slimmpylk/Skoll_Ultra/sportwatch_revA.kicad_pcb

## KiCad design sportwatch_revA.kicad_pcb (2026-10-22)

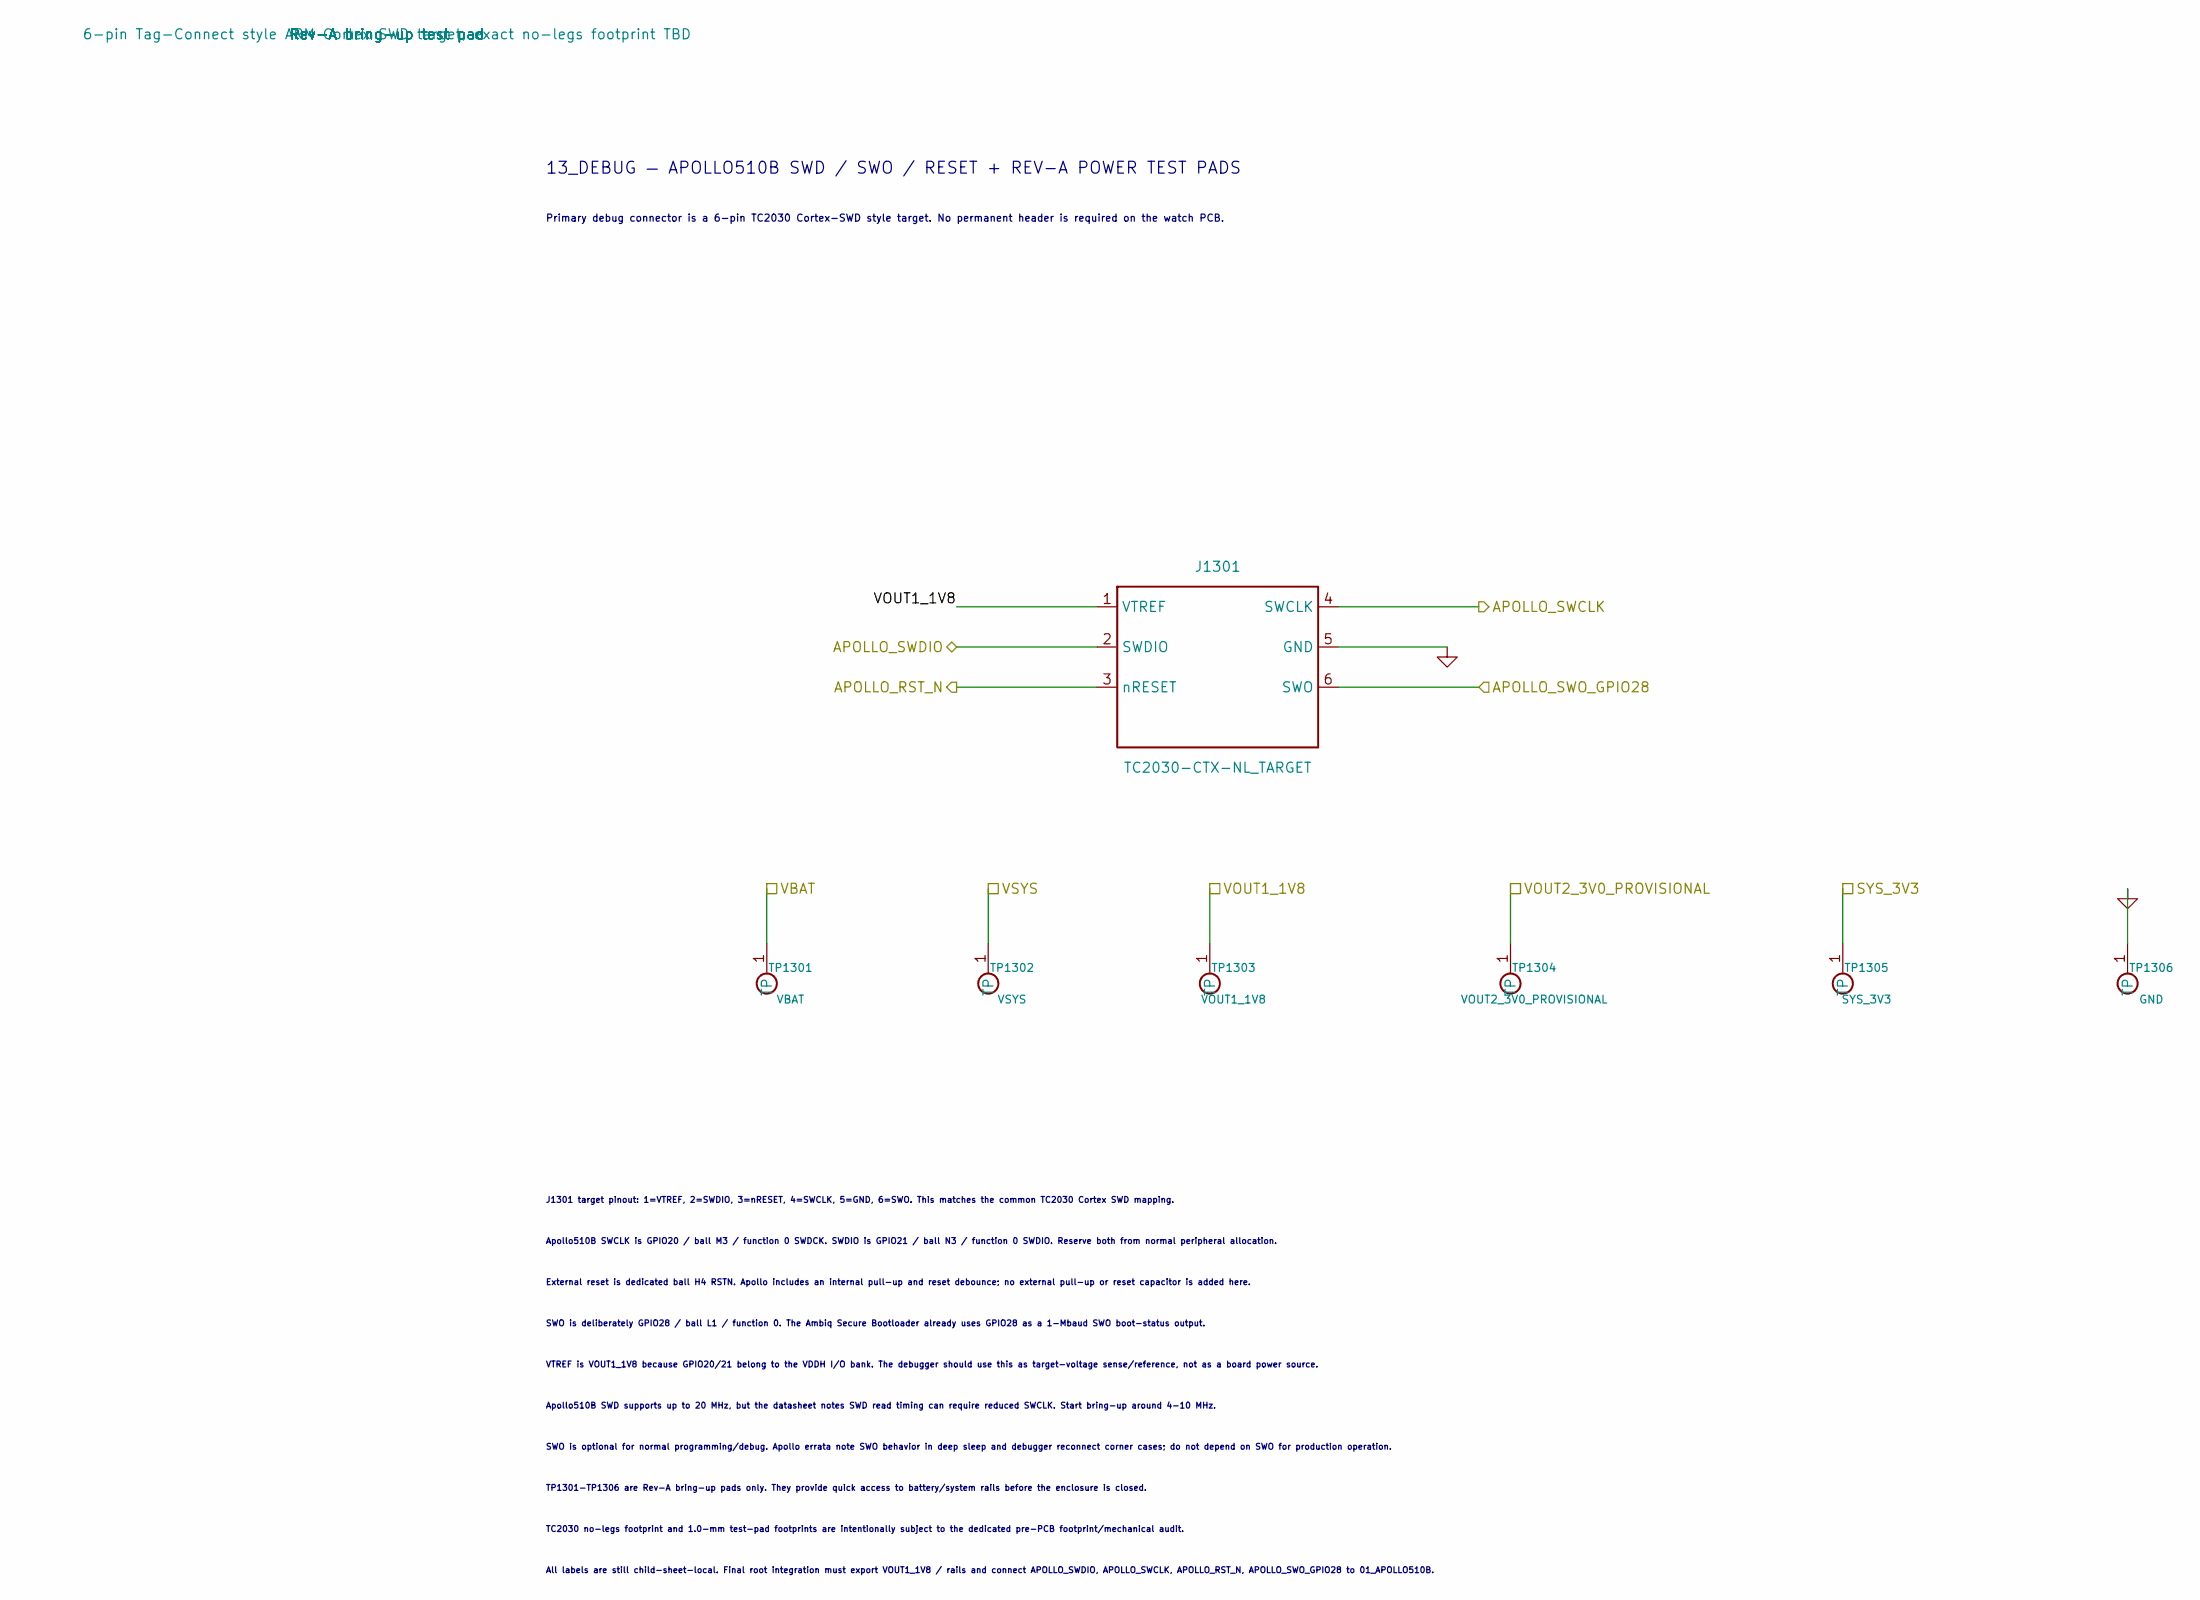
[picture p2: schematic 13_DEBUG.kicad_sch, Rev-A — Apollo510B Debug / Bring-up]

Parts:
J1301: TC2030-CTX-NL_TARGET; Tag-Connect_TC2030-IDC-NL_2x03_P1.27mm_Vertical
TP1301: VBAT; TestPoint_Pad_D1.0mm
TP1302: VSYS; TestPoint_Pad_D1.0mm
TP1303: VOUT1_1V8; TestPoint_Pad_D1.0mm
TP1304: VOUT2_3V0_PROVISIONAL; TestPoint_Pad_D1.0mm
TP1305: SYS_3V3; TestPoint_Pad_D1.0mm
TP1306: GND; TestPoint_Pad_D1.0mm

Connections:
/APOLLO_RST_N: J1301.3 (nRESET); also elsewhere on the board
/APOLLO_SWCLK: J1301.4 (SWCLK); also elsewhere on the board
/APOLLO_SWDIO: J1301.2 (SWDIO); also elsewhere on the board
/APOLLO_SWO_GPIO28: J1301.6 (SWO); also elsewhere on the board
/SYS_3V3: TP1305.1 (TP_1); also elsewhere on the board
/VOUT2_3V0_PROVISIONAL: TP1304.1 (TP_1); also elsewhere on the board
/VSYS: TP1302.1 (TP_1); also elsewhere on the board
GND: J1301.5 (GND), TP1306.1 (TP_1); also elsewhere on the board
VBAT: TP1301.1 (TP_1); also elsewhere on the board
VOUT1_1V8: J1301.1 (VTREF), TP1303.1 (TP_1); also elsewhere on the board

Notes on the sheet:
J1301 target pinout: 1=VTREF, 2=SWDIO, 3=nRESET, 4=SWCLK, 5=GND, 6=SWO. This matches the common TC2030 Cortex SWD mapping.
13_DEBUG — APOLLO510B SWD / SWO / RESET + REV-A POWER TEST PADS
SWO is optional for normal programming/debug. Apollo errata note SWO behavior in deep sleep and debugger reconnect corner cases; do not depend on SWO for production operation.
VTREF is VOUT1_1V8 because GPIO20/21 belong to the VDDH I/O bank. The debugger should use this as target-voltage sense/reference, not as a board power source.
All labels are still child-sheet-local. Final root integration must export VOUT1_1V8 / rails and connect APOLLO_SWDIO, APOLLO_SWCLK, APOLLO_RST_N, APOLLO_SWO_GPIO28 to 01_APOLLO510B.
Apollo510B SWCLK is GPIO20 / ball M3 / function 0 SWDCK. SWDIO is GPIO21 / ball N3 / function 0 SWDIO. Reserve both from normal peripheral allocation.
TC2030 no-legs footprint and 1.0-mm test-pad footprints are intentionally subject to the dedicated pre-PCB footprint/mechanical audit.
External reset is dedicated ball H4 RSTN. Apollo includes an internal pull-up and reset debounce; no external pull-up or reset capacitor is added here.
SWO is deliberately GPIO28 / ball L1 / function 0. The Ambiq Secure Bootloader already uses GPIO28 as a 1-Mbaud SWO boot-status output.
Apollo510B SWD supports up to 20 MHz, but the datasheet notes SWD read timing can require reduced SWCLK. Start bring-up around 4-10 MHz.
Primary debug connector is a 6-pin TC2030 Cortex-SWD style target. No permanent header is required on the watch PCB.
TP1301-TP1306 are Rev-A bring-up pads only. They provide quick access to battery/system rails before the enclosure is closed.

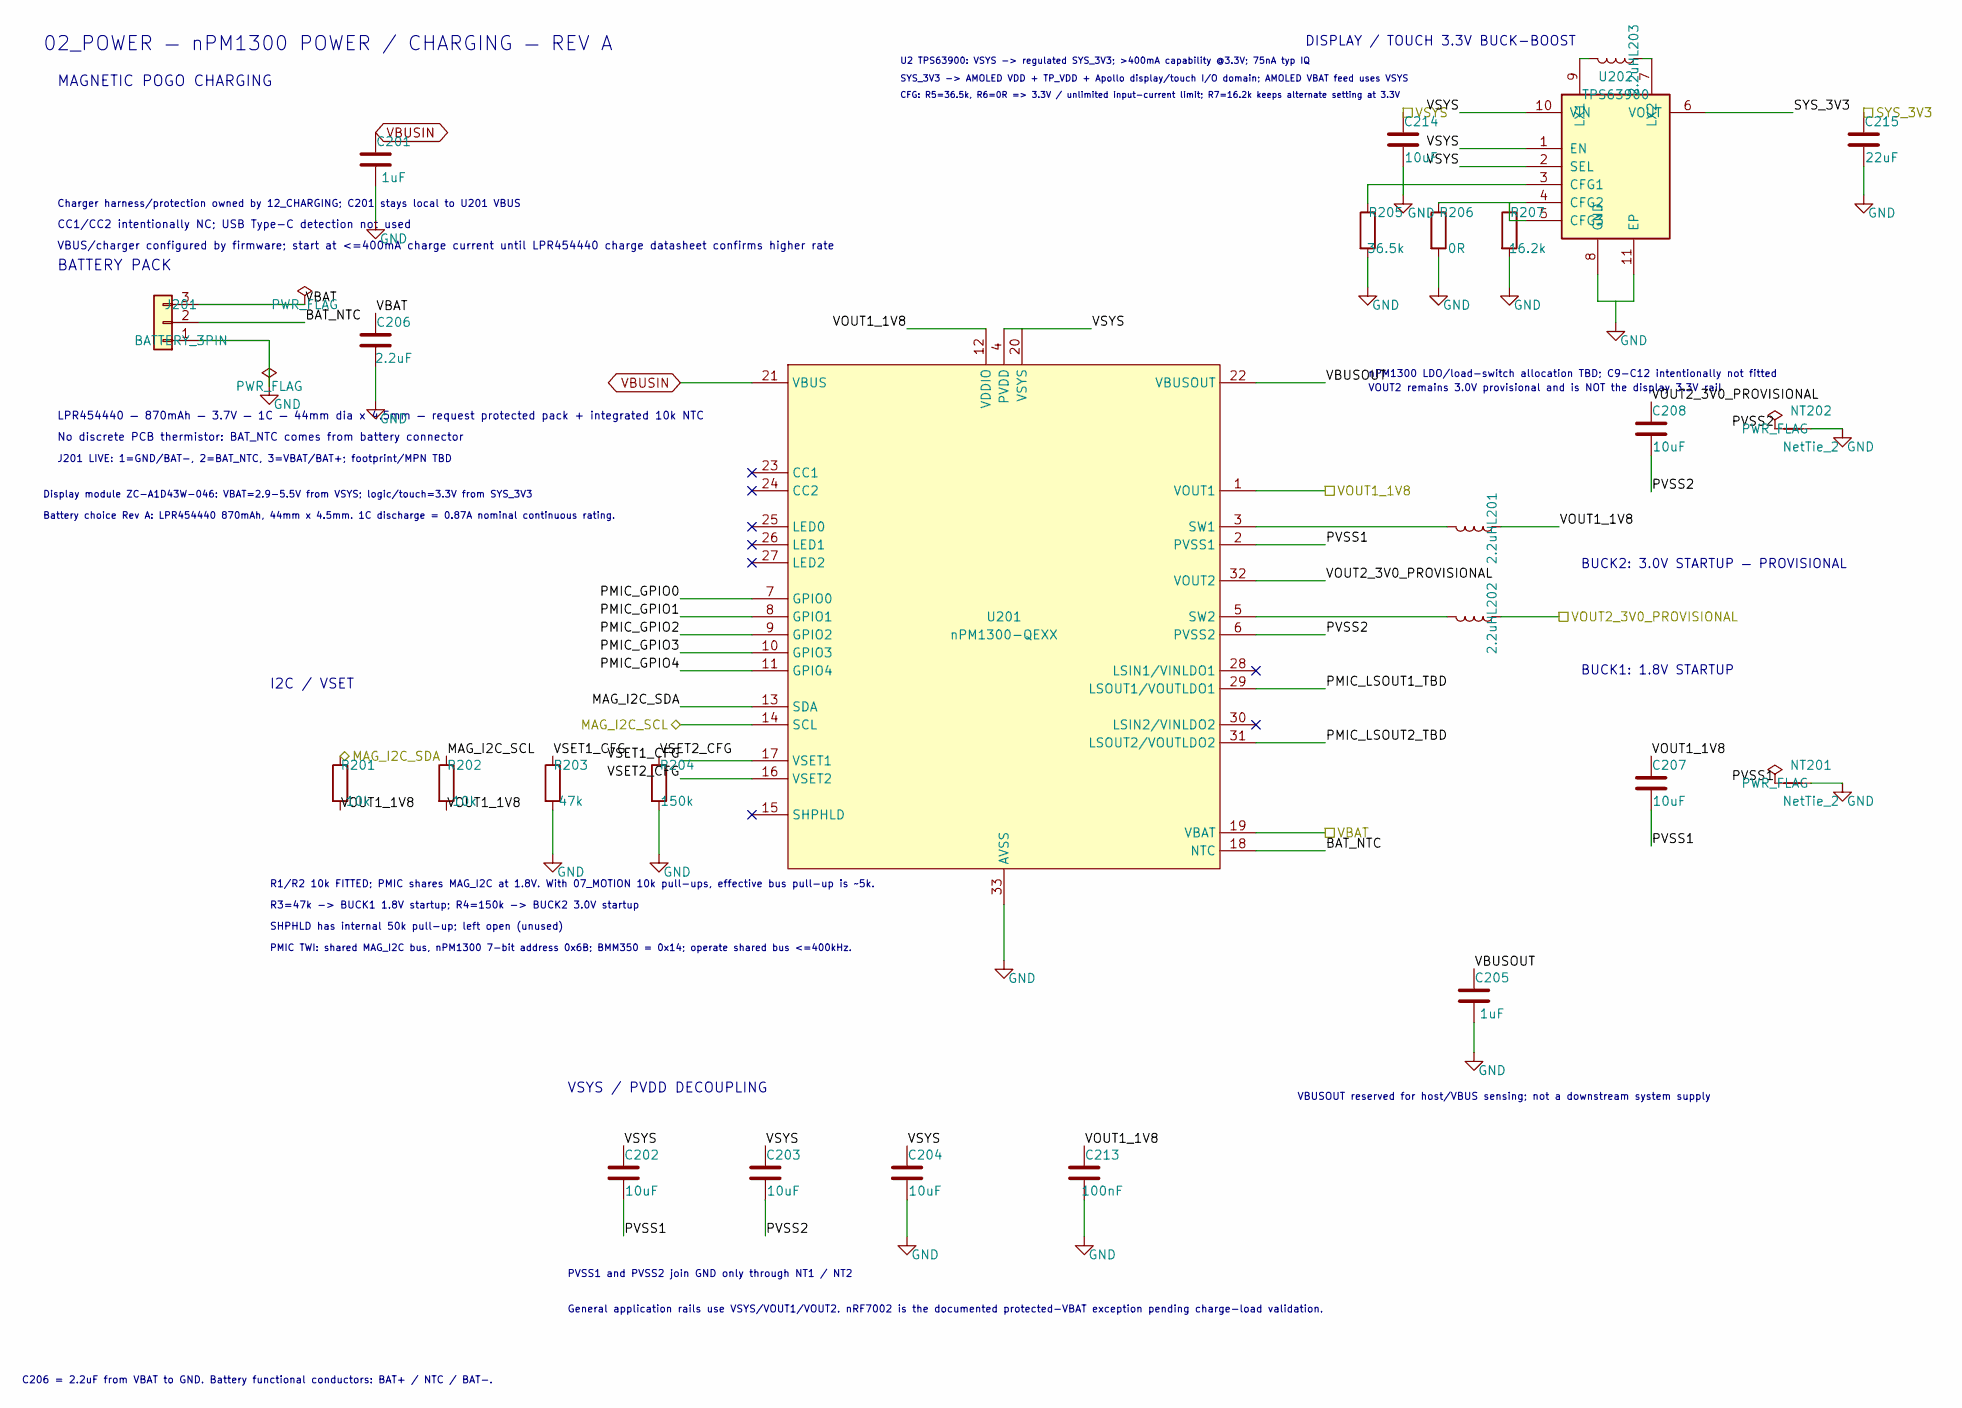
[picture p3: schematic 02_POWER.kicad_sch]

Parts:
C201, C205: 1uF; C_0402_1005Metric
C202, C203, C204, C207, C208, C214: 10uF; C_0603_1608Metric
C206: 2.2uF; C_0402_1005Metric
C213: 100nF; C_0402_1005Metric
C215: 22uF; C_0603_1608Metric
J201: BATTERY_3PIN
L201, L202: 2.2uH; L_0603_1608Metric
L203: 2.2uH; L_2016_2016Metric
NT201, NT202: NetTie_2; NetTie-2_SMD_Pad0.5mm
R201, R202: 10k; R_0402_1005Metric
R203: 47k; R_0402_1005Metric; Tolerance 1%
R204: 150k; R_0402_1005Metric; Tolerance 1%
R205: 36.5k; R_0402_1005Metric; Tolerance 1%
R206: 0R; R_0402_1005Metric; Tolerance 1%
R207: 16.2k; R_0402_1005Metric; Tolerance 1%
U201: nPM1300-QEXX; QFN-32-1EP_5x5mm_P0.5mm_EP3.6x3.6mm_ThermalVias
U202: TPS63900; WSON-10-1EP_2.5x2.5mm_P0.5mm_EP1.2x2mm_ThermalVias; MPN TPS63900DSK

Connections:
/02_POWER/BAT_NTC: J201.2, U201.18 (NTC)
/02_POWER/PMIC_GPIO0: U201.7 (GPIO0)
/02_POWER/PMIC_GPIO1: U201.8 (GPIO1)
/02_POWER/PMIC_GPIO2: U201.9 (GPIO2)
/02_POWER/PMIC_GPIO3: U201.10 (GPIO3)
/02_POWER/PMIC_GPIO4: U201.11 (GPIO4)
/02_POWER/PMIC_LSOUT1_TBD: U201.29 (LSOUT1/VOUTLDO1)
/02_POWER/PMIC_LSOUT2_TBD: U201.31 (LSOUT2/VOUTLDO2)
/02_POWER/PVSS1: C202.2, C207.2, NT201.1, U201.2 (PVSS1)
/02_POWER/PVSS2: C203.2, C208.2, NT202.1, U201.6 (PVSS2)
/02_POWER/VBUSOUT: C205.1, U201.22 (VBUSOUT)
/02_POWER/VSET1_CFG: R203.1, U201.17 (VSET1)
/02_POWER/VSET2_CFG: R204.1, U201.16 (VSET2)
/MAG_I2C_SCL: R202.1, U201.14 (SCL); also elsewhere on the board
/MAG_I2C_SDA: R201.1, U201.13 (SDA); also elsewhere on the board
/SYS_3V3: C215.1, U202.6 (VOUT); also elsewhere on the board
/VOUT2_3V0_PROVISIONAL: C208.1, L202.1, U201.32 (VOUT2); also elsewhere on the board
/VSYS: C202.1, C203.1, C204.1, C214.1, U201.4 (PVDD), U201.20 (VSYS), U202.1 (EN), U202.2 (SEL), U202.10 (VIN); also elsewhere on the board
GND: C201.2, C204.2, C205.2, C206.2, C213.2, C214.2, C215.2, J201.1, NT201.2, NT202.2, R203.2, R204.2, R205.2, R206.2, R207.2, U201.33 (AVSS), U202.8 (GND), U202.11 (EP); also elsewhere on the board
unnamed: L201.2, U201.3 (SW1)
unnamed: L202.2, U201.5 (SW2)
unnamed: R205.1, U202.3 (CFG1)
unnamed: R206.1, U202.4 (CFG2)
unnamed: R207.1, U202.5 (CFG3)
unnamed: L203.2, U202.9 (LX1)
unnamed: L203.1, U202.7 (LX2)
VBAT: C206.1, J201.3, U201.19 (VBAT); also elsewhere on the board
VBUSIN: C201.1, U201.21 (VBUS)
VOUT1_1V8: C207.1, C213.1, L201.1, R201.2, R202.2, U201.1 (VOUT1), U201.12 (VDDIO); also elsewhere on the board

Notes on the sheet:
VBUSOUT reserved for host/VBUS sensing; not a downstream system supply
U2 TPS63900: VSYS -> regulated SYS_3V3; >400mA capability @3.3V; 75nA typ IQ
Battery choice Rev A: LPR454440 870mAh, 44mm x 4.5mm. 1C discharge = 0.87A nominal continuous rating.
BATTERY PACK
DISPLAY / TOUCH 3.3V BUCK-BOOST
SYS_3V3 -> AMOLED VDD + TP_VDD + Apollo display/touch I/O domain; AMOLED VBAT feed uses VSYS
Charger harness/protection owned by 12_CHARGING; C201 stays local to U201 VBUS
VSYS / PVDD DECOUPLING
BUCK1: 1.8V STARTUP
CFG: R5=36.5k, R6=0R => 3.3V / unlimited input-current limit; R7=16.2k keeps alternate setting at 3.3V
No discrete PCB thermistor: BAT_NTC comes from battery connector
CC1/CC2 intentionally NC; USB Type-C detection not used
R3=47k -> BUCK1 1.8V startup; R4=150k -> BUCK2 3.0V startup
I2C / VSET
nPM1300 LDO/load-switch allocation TBD; C9-C12 intentionally not fitted
02_POWER — nPM1300 POWER / CHARGING — REV A
LPR454440 — 870mAh — 3.7V — 1C — 44mm dia x 4.5mm — request protected pack + integrated 10k NTC
R1/R2 10k FITTED; PMIC shares MAG_I2C at 1.8V. With 07_MOTION 10k pull-ups, effective bus pull-up is ~5k.
MAGNETIC POGO CHARGING
J201 LIVE: 1=GND/BAT-, 2=BAT_NTC, 3=VBAT/BAT+; footprint/MPN TBD
Display module ZC-A1D43W-046: VBAT=2.9-5.5V from VSYS; logic/touch=3.3V from SYS_3V3
SHPHLD has internal 50k pull-up; left open (unused)
VBUS/charger configured by firmware; start at <=400mA charge current until LPR454440 charge datasheet confirms higher rate
VOUT2 remains 3.0V provisional and is NOT the display 3.3V rail
PVSS1 and PVSS2 join GND only through NT1 / NT2
BUCK2: 3.0V STARTUP — PROVISIONAL
General application rails use VSYS/VOUT1/VOUT2. nRF7002 is the documented protected-VBAT exception pending charge-load validation.
PMIC TWI: shared MAG_I2C bus, nPM1300 7-bit address 0x6B; BMM350 = 0x14; operate shared bus <=400kHz.
C206 = 2.2uF from VBAT to GND. Battery functional conductors: BAT+ / NTC / BAT-.

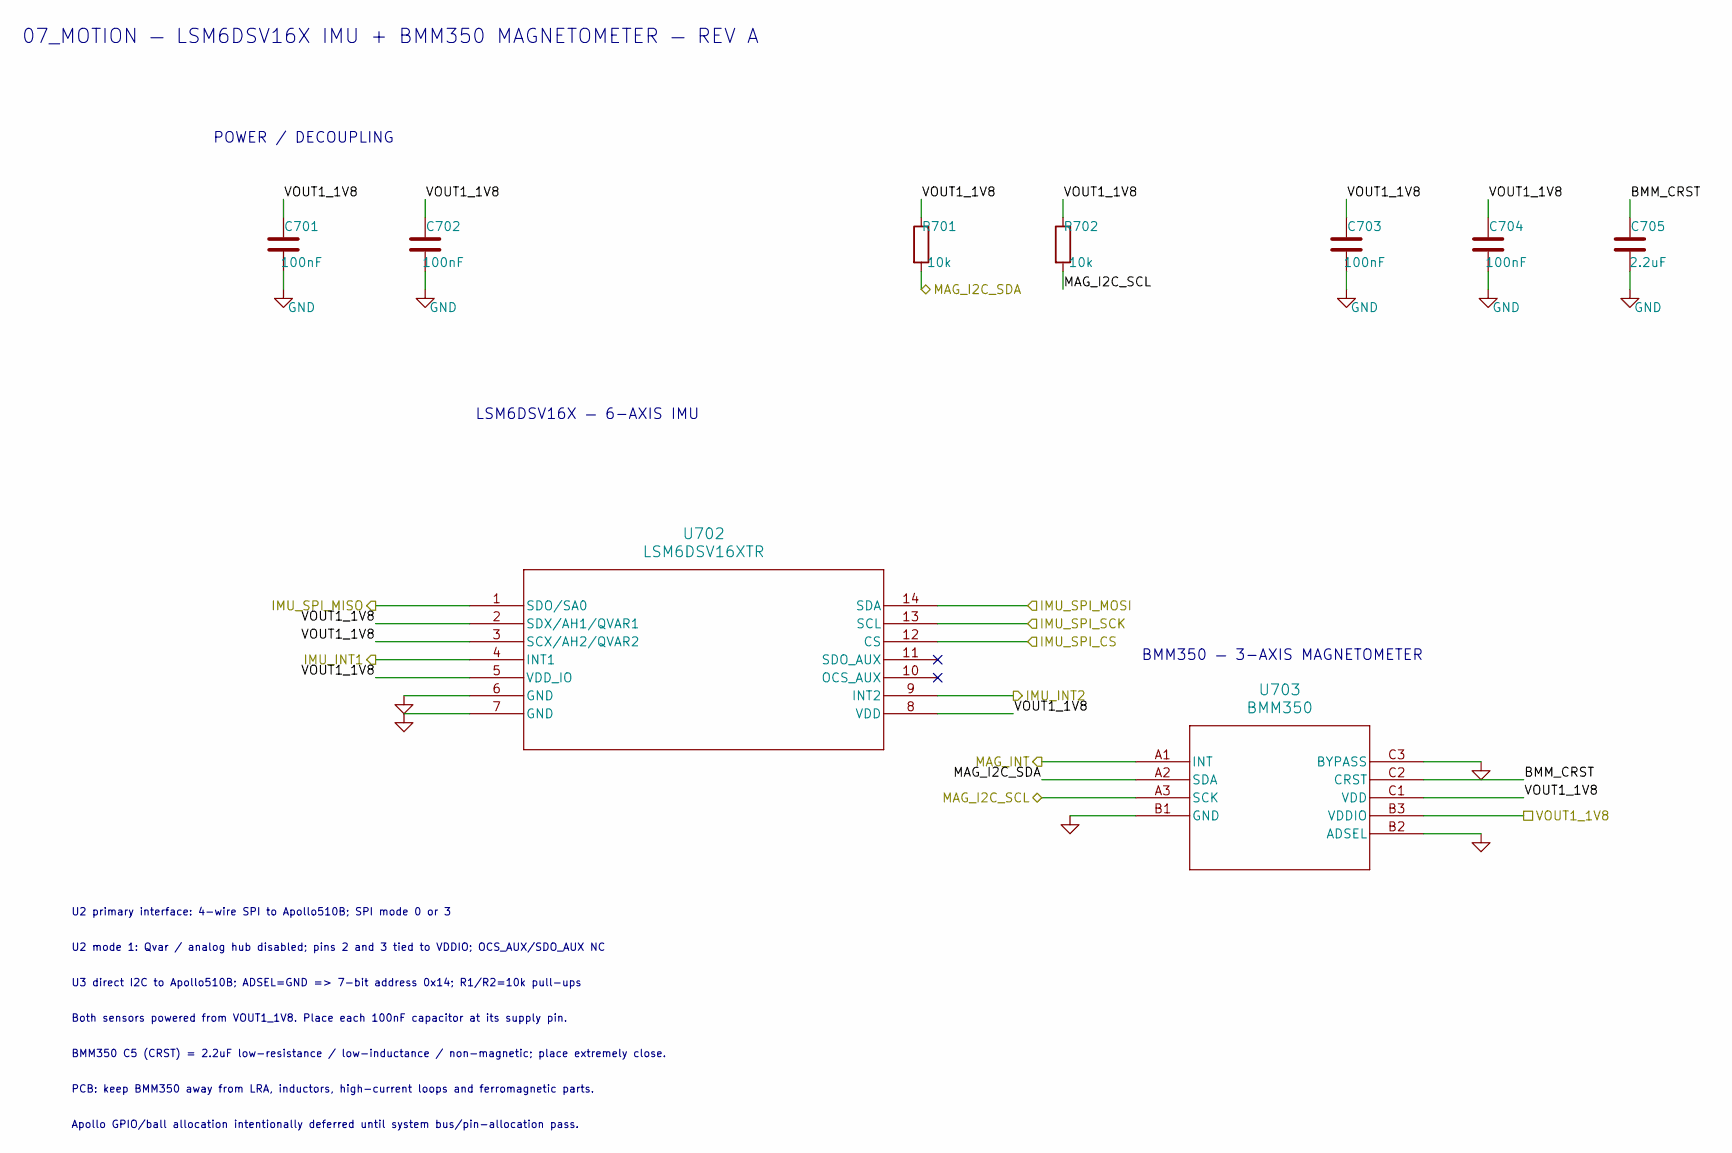
[picture p4: schematic 07_MOTION.kicad_sch]

Parts:
C701, C702, C703, C704: 100nF; C_0402_1005Metric
C705: 2.2uF; C_0805_2012Metric
R701, R702: 10k; R_0402_1005Metric; Tolerance 1%
U702: LSM6DSV16XTR; LGA-14L_STM
U703: BMM350; BGA9_BMM350_BOS

Connections:
/07_MOTION/BMM_CRST: C705.1, U703.C2 (CRST)
/IMU_INT1: U702.4 (INT1); also elsewhere on the board
/IMU_INT2: U702.9 (INT2); also elsewhere on the board
/IMU_SPI_CS: U702.12 (CS); also elsewhere on the board
/IMU_SPI_MISO: U702.1 (SDO/SA0); also elsewhere on the board
/IMU_SPI_MOSI: U702.14 (SDA); also elsewhere on the board
/IMU_SPI_SCK: U702.13 (SCL); also elsewhere on the board
/MAG_I2C_SCL: R702.2, U703.A3 (SCK); also elsewhere on the board
/MAG_I2C_SDA: R701.2, U703.A2 (SDA); also elsewhere on the board
/MAG_INT: U703.A1 (INT); also elsewhere on the board
GND: C701.2, C702.2, C703.2, C704.2, C705.2, U702.6 (GND), U702.7 (GND), U703.B1 (GND), U703.B2 (ADSEL), U703.C3 (BYPASS); also elsewhere on the board
VOUT1_1V8: C701.1, C702.1, C703.1, C704.1, R701.1, R702.1, U702.2 (SDX/AH1/QVAR1), U702.3 (SCX/AH2/QVAR2), U702.5 (VDD_IO), U702.8 (VDD), U703.B3 (VDDIO), U703.C1 (VDD); also elsewhere on the board

Notes on the sheet:
LSM6DSV16X — 6-AXIS IMU
BMM350 C5 (CRST) = 2.2uF low-resistance / low-inductance / non-magnetic; place extremely close.
BMM350 — 3-AXIS MAGNETOMETER
U2 primary interface: 4-wire SPI to Apollo510B; SPI mode 0 or 3
U2 mode 1: Qvar / analog hub disabled; pins 2 and 3 tied to VDDIO; OCS_AUX/SDO_AUX NC
07_MOTION — LSM6DSV16X IMU + BMM350 MAGNETOMETER — REV A
U3 direct I2C to Apollo510B; ADSEL=GND => 7-bit address 0x14; R1/R2=10k pull-ups
POWER / DECOUPLING
PCB: keep BMM350 away from LRA, inductors, high-current loops and ferromagnetic parts.
Apollo GPIO/ball allocation intentionally deferred until system bus/pin-allocation pass.
Both sensors powered from VOUT1_1V8. Place each 100nF capacitor at its supply pin.

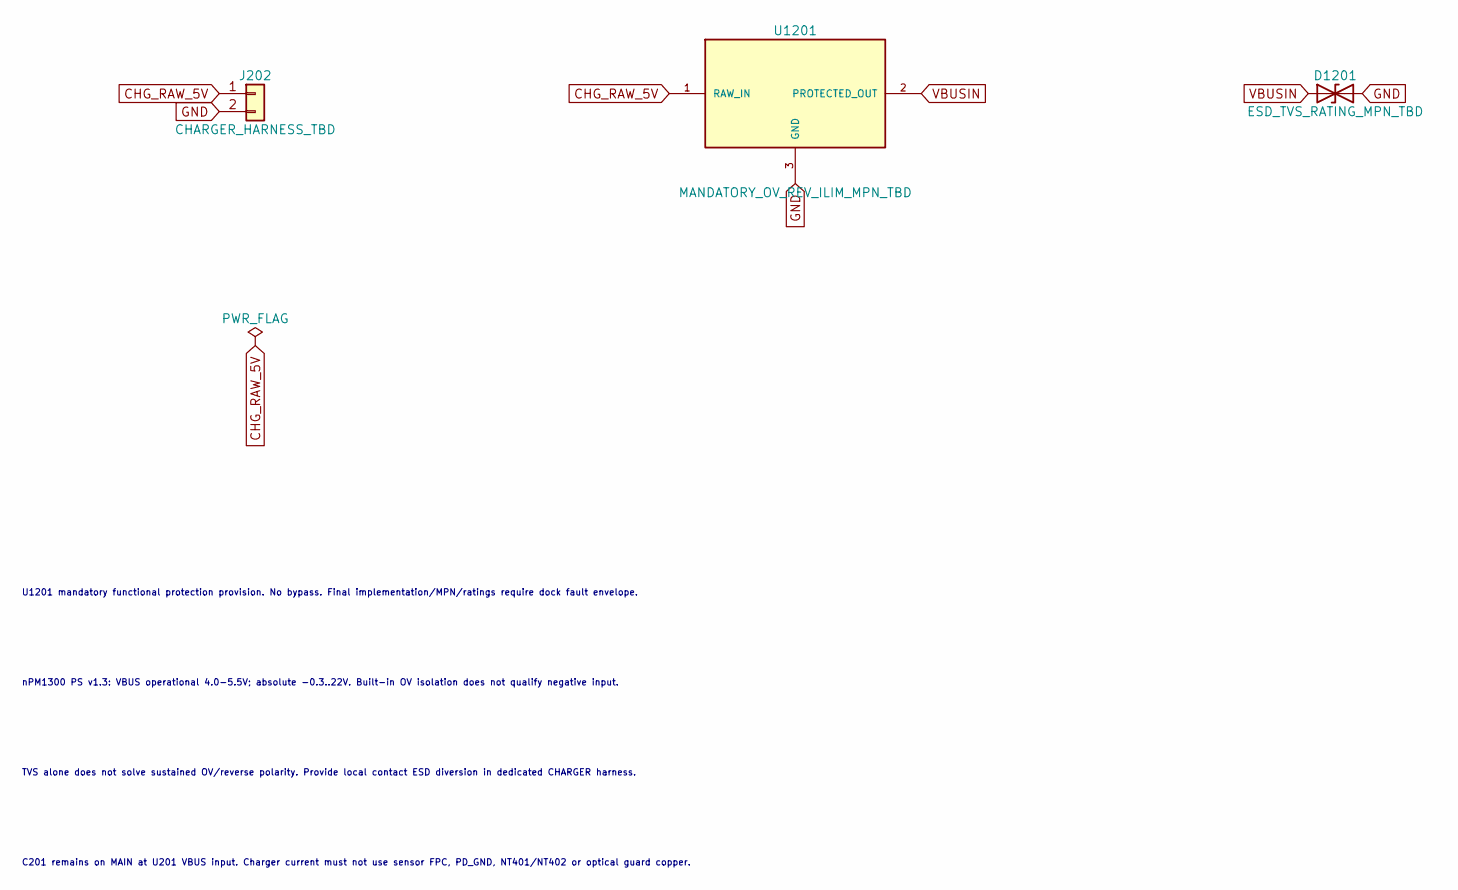
[picture p5: schematic 12_CHARGING.kicad_sch]

Parts:
D1201: ESD_TVS_RATING_MPN_TBD
J202: CHARGER_HARNESS_TBD
U1201: MANDATORY_OV_REV_ILIM_MPN_TBD

Connections:
unnamed: D1201.1 (A1), U1201.2 (PROTECTED_OUT)
unnamed: D1201.2 (A2), J202.2, U1201.3 (GND)
unnamed: J202.1, U1201.1 (RAW_IN)

Notes on the sheet:
U1201 mandatory functional protection provision. No bypass. Final implementation/MPN/ratings require dock fault envelope.
nPM1300 PS v1.3: VBUS operational 4.0-5.5V; absolute -0.3..22V. Built-in OV isolation does not qualify negative input.
TVS alone does not solve sustained OV/reverse polarity. Provide local contact ESD diversion in dedicated CHARGER harness.
C201 remains on MAIN at U201 VBUS input. Charger current must not use sensor FPC, PD_GND, NT401/NT402 or optical guard copper.

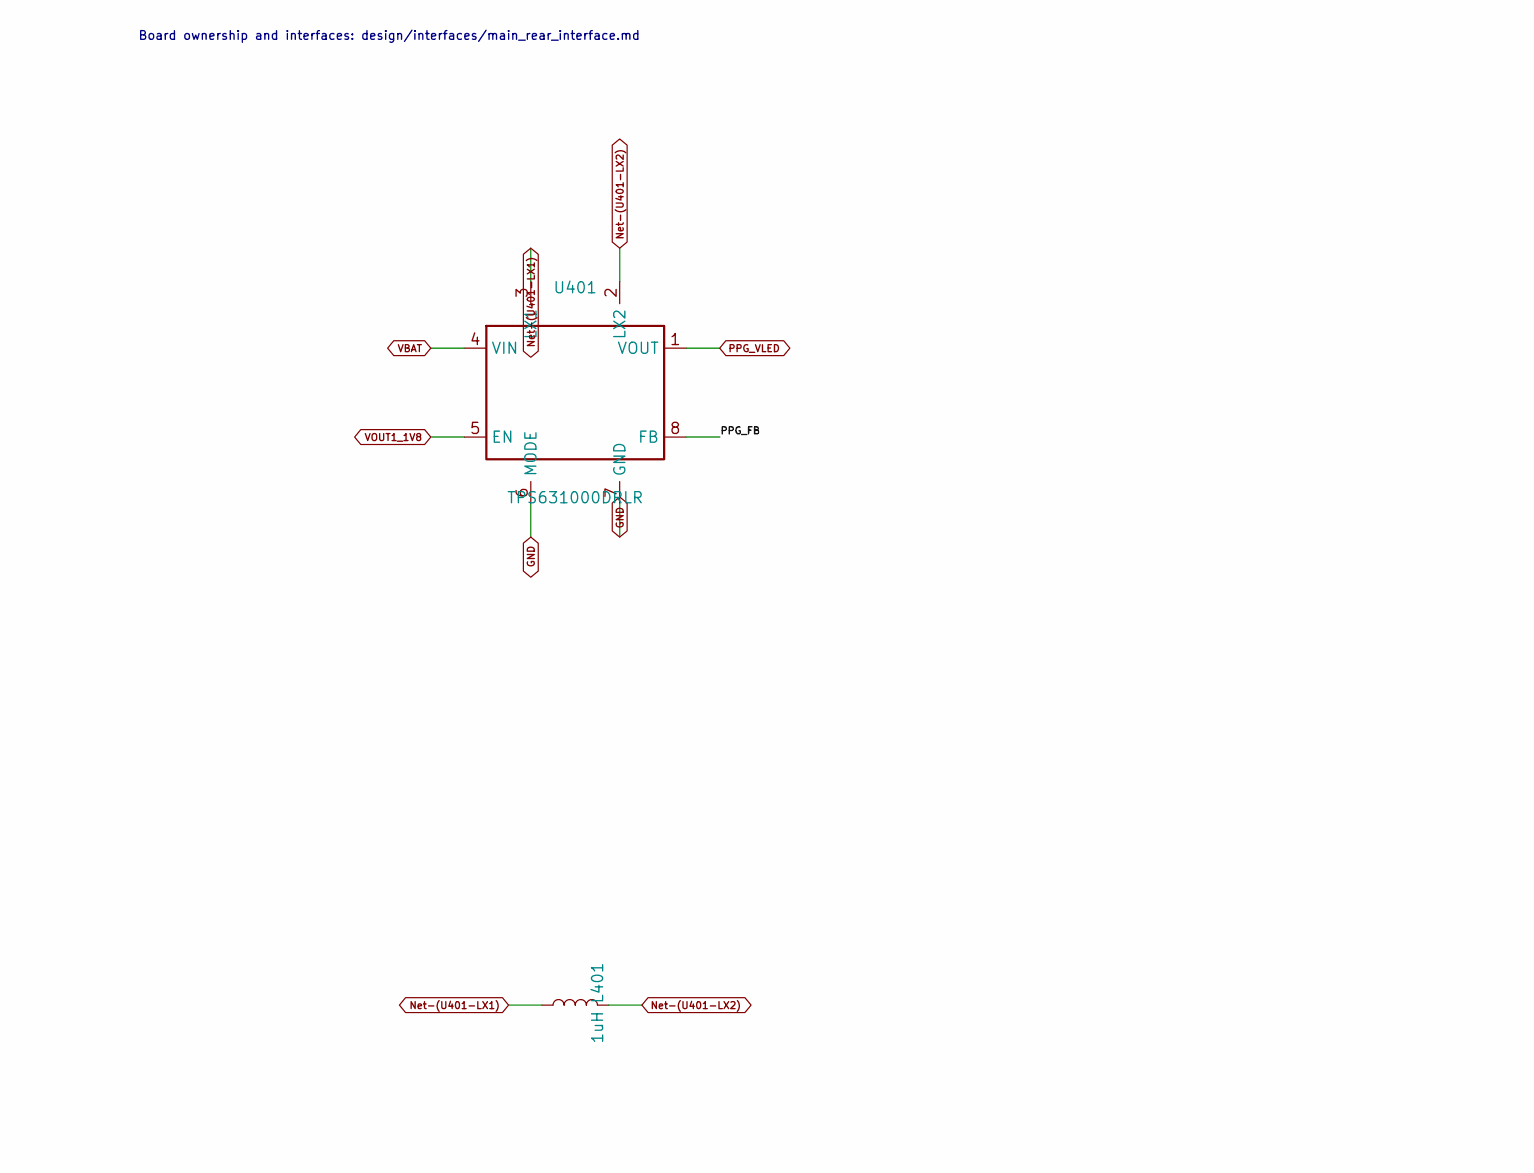
[picture p6: schematic 04_PPG.kicad_sch, MAIN - TPS631000 VLED source and rear interface, part in row 1, column 1]

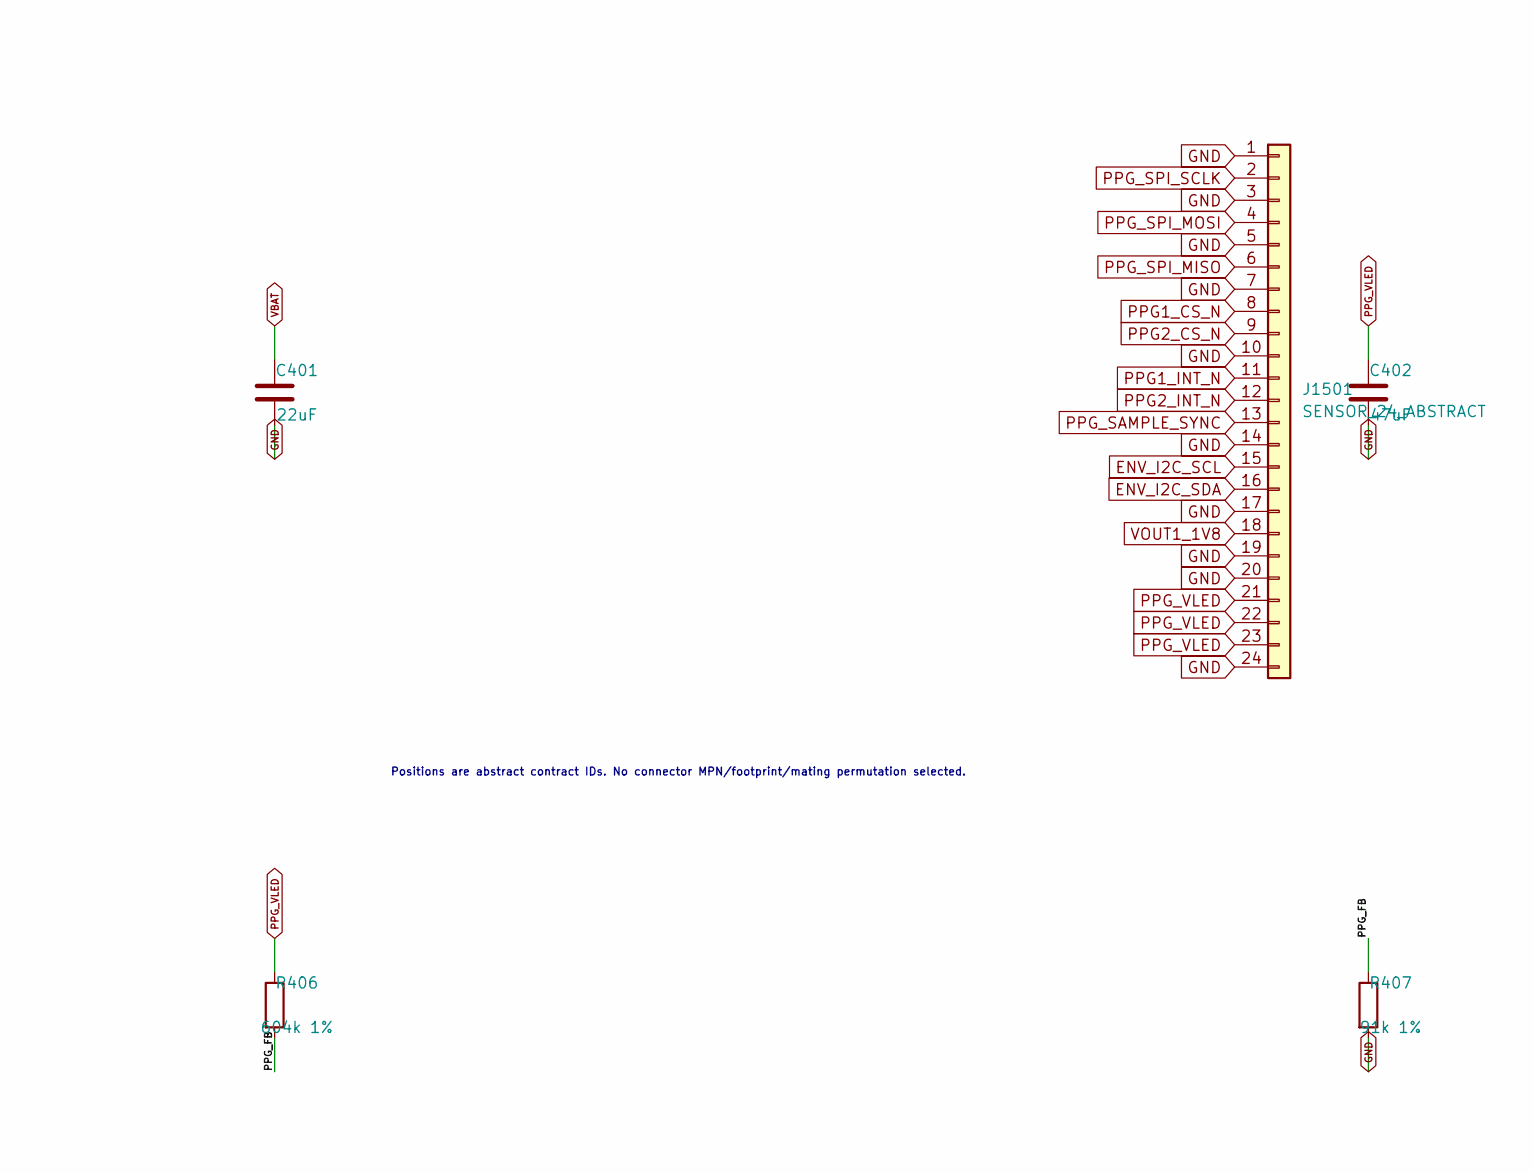
[picture p7: schematic 04_PPG.kicad_sch, MAIN - TPS631000 VLED source and rear interface, part in row 1, column 2]

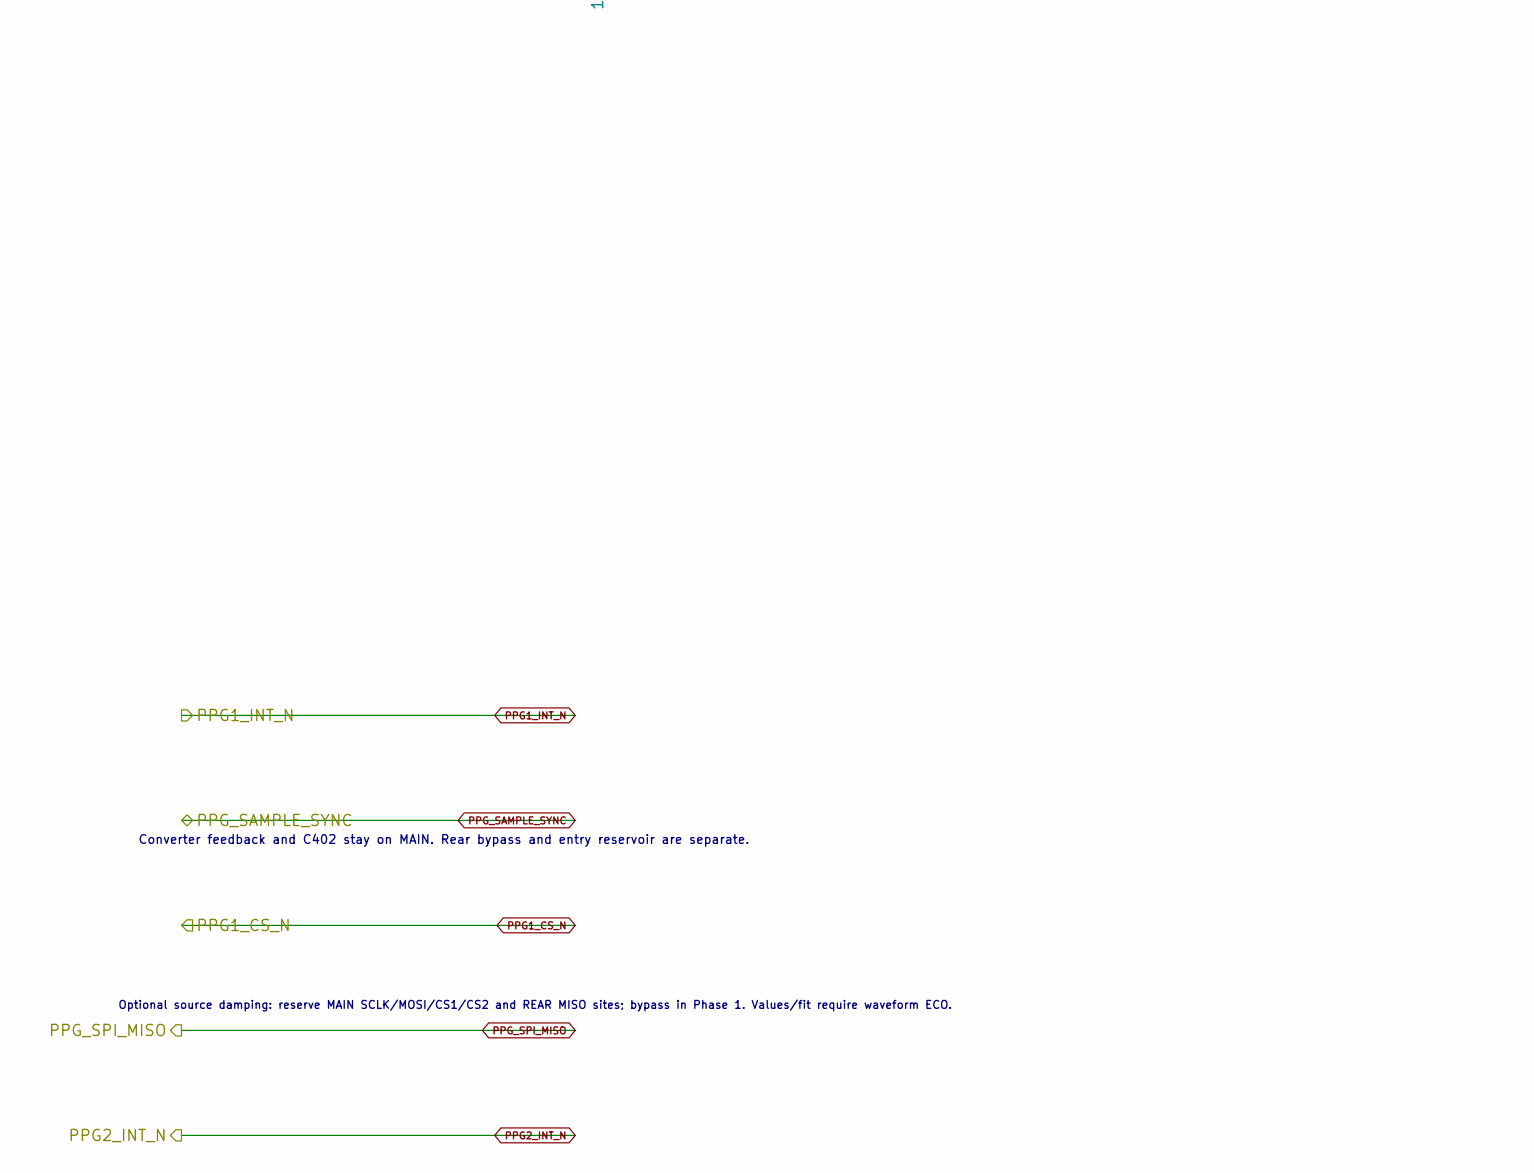
[picture p8: schematic 04_PPG.kicad_sch, MAIN - TPS631000 VLED source and rear interface, part in row 2, column 1]

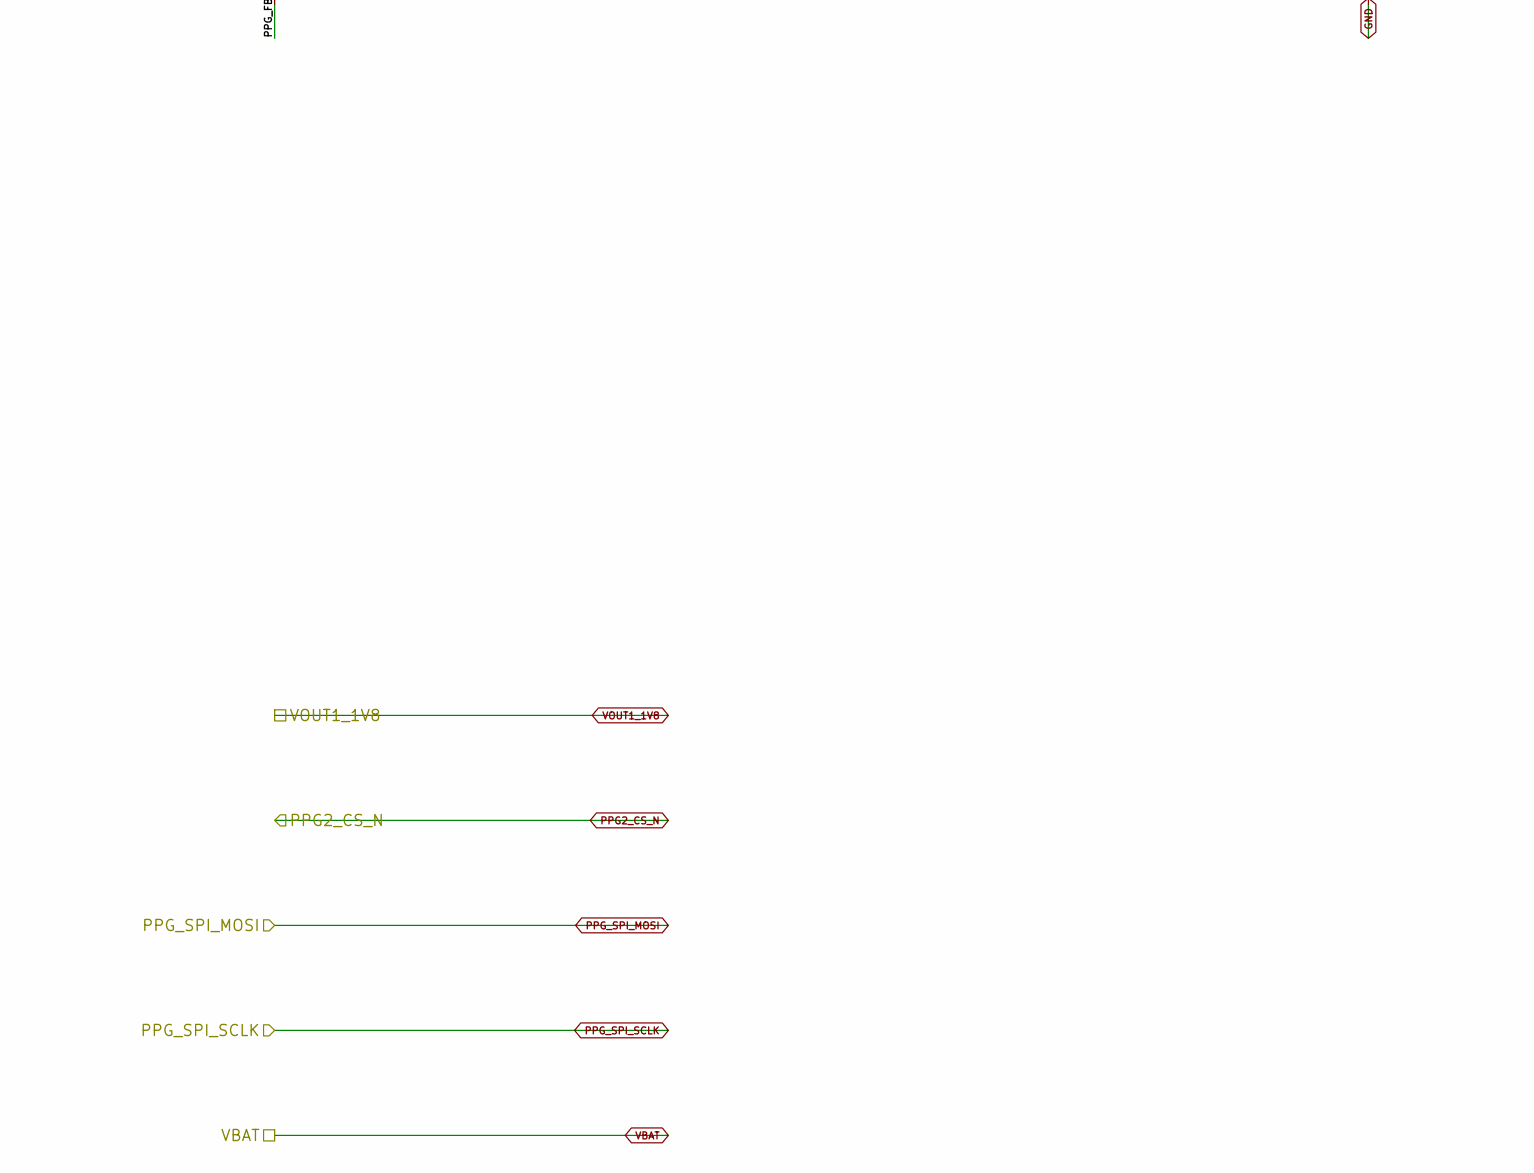
[picture p9: schematic 04_PPG.kicad_sch, MAIN - TPS631000 VLED source and rear interface, part in row 2, column 2]

Parts:
C401: 22uF; C_0603_1608Metric
C402: 47uF; C_0805_2012Metric
J1501: SENSOR_24_ABSTRACT
L401: 1uH; L_2016_2016Metric
R406: 604k 1%; R_0402_1005Metric
R407: 91k 1%; R_0402_1005Metric
U401: TPS631000DRLR; SOT-583-8

Connections:
/04_PPG/PPG_FB: R406.2, R407.1, U401.8 (FB)
GND: C401.2, C402.2, J1501.1, J1501.3, J1501.5, J1501.7, J1501.10, J1501.14, J1501.17, J1501.19, J1501.20, J1501.24, R407.2, U401.6 (MODE), U401.7 (GND); also elsewhere on the board
unnamed: L401.1, U401.3 (LX1)
unnamed: L401.2, U401.2 (LX2)
PPG_VLED: C402.1, J1501.21, J1501.22, J1501.23, R406.1, U401.1 (VOUT)
VBAT: C401.1, U401.4 (VIN); also elsewhere on the board
VOUT1_1V8: J1501.18, U401.5 (EN); also elsewhere on the board

Notes on the sheet:
Board ownership and interfaces: design/interfaces/main_rear_interface.md
Converter feedback and C402 stay on MAIN. Rear bypass and entry reservoir are separate.
Positions are abstract contract IDs. No connector MPN/footprint/mating permutation selected.
Optional source damping: reserve MAIN SCLK/MOSI/CS1/CS2 and REAR MISO sites; bypass in Phase 1. Values/fit require waveform ECO.
