slimmpylk/Skoll_Ultra/sportwatch_revA.kicad_pcb

## KiCad design sportwatch_revA.kicad_pcb (continued)

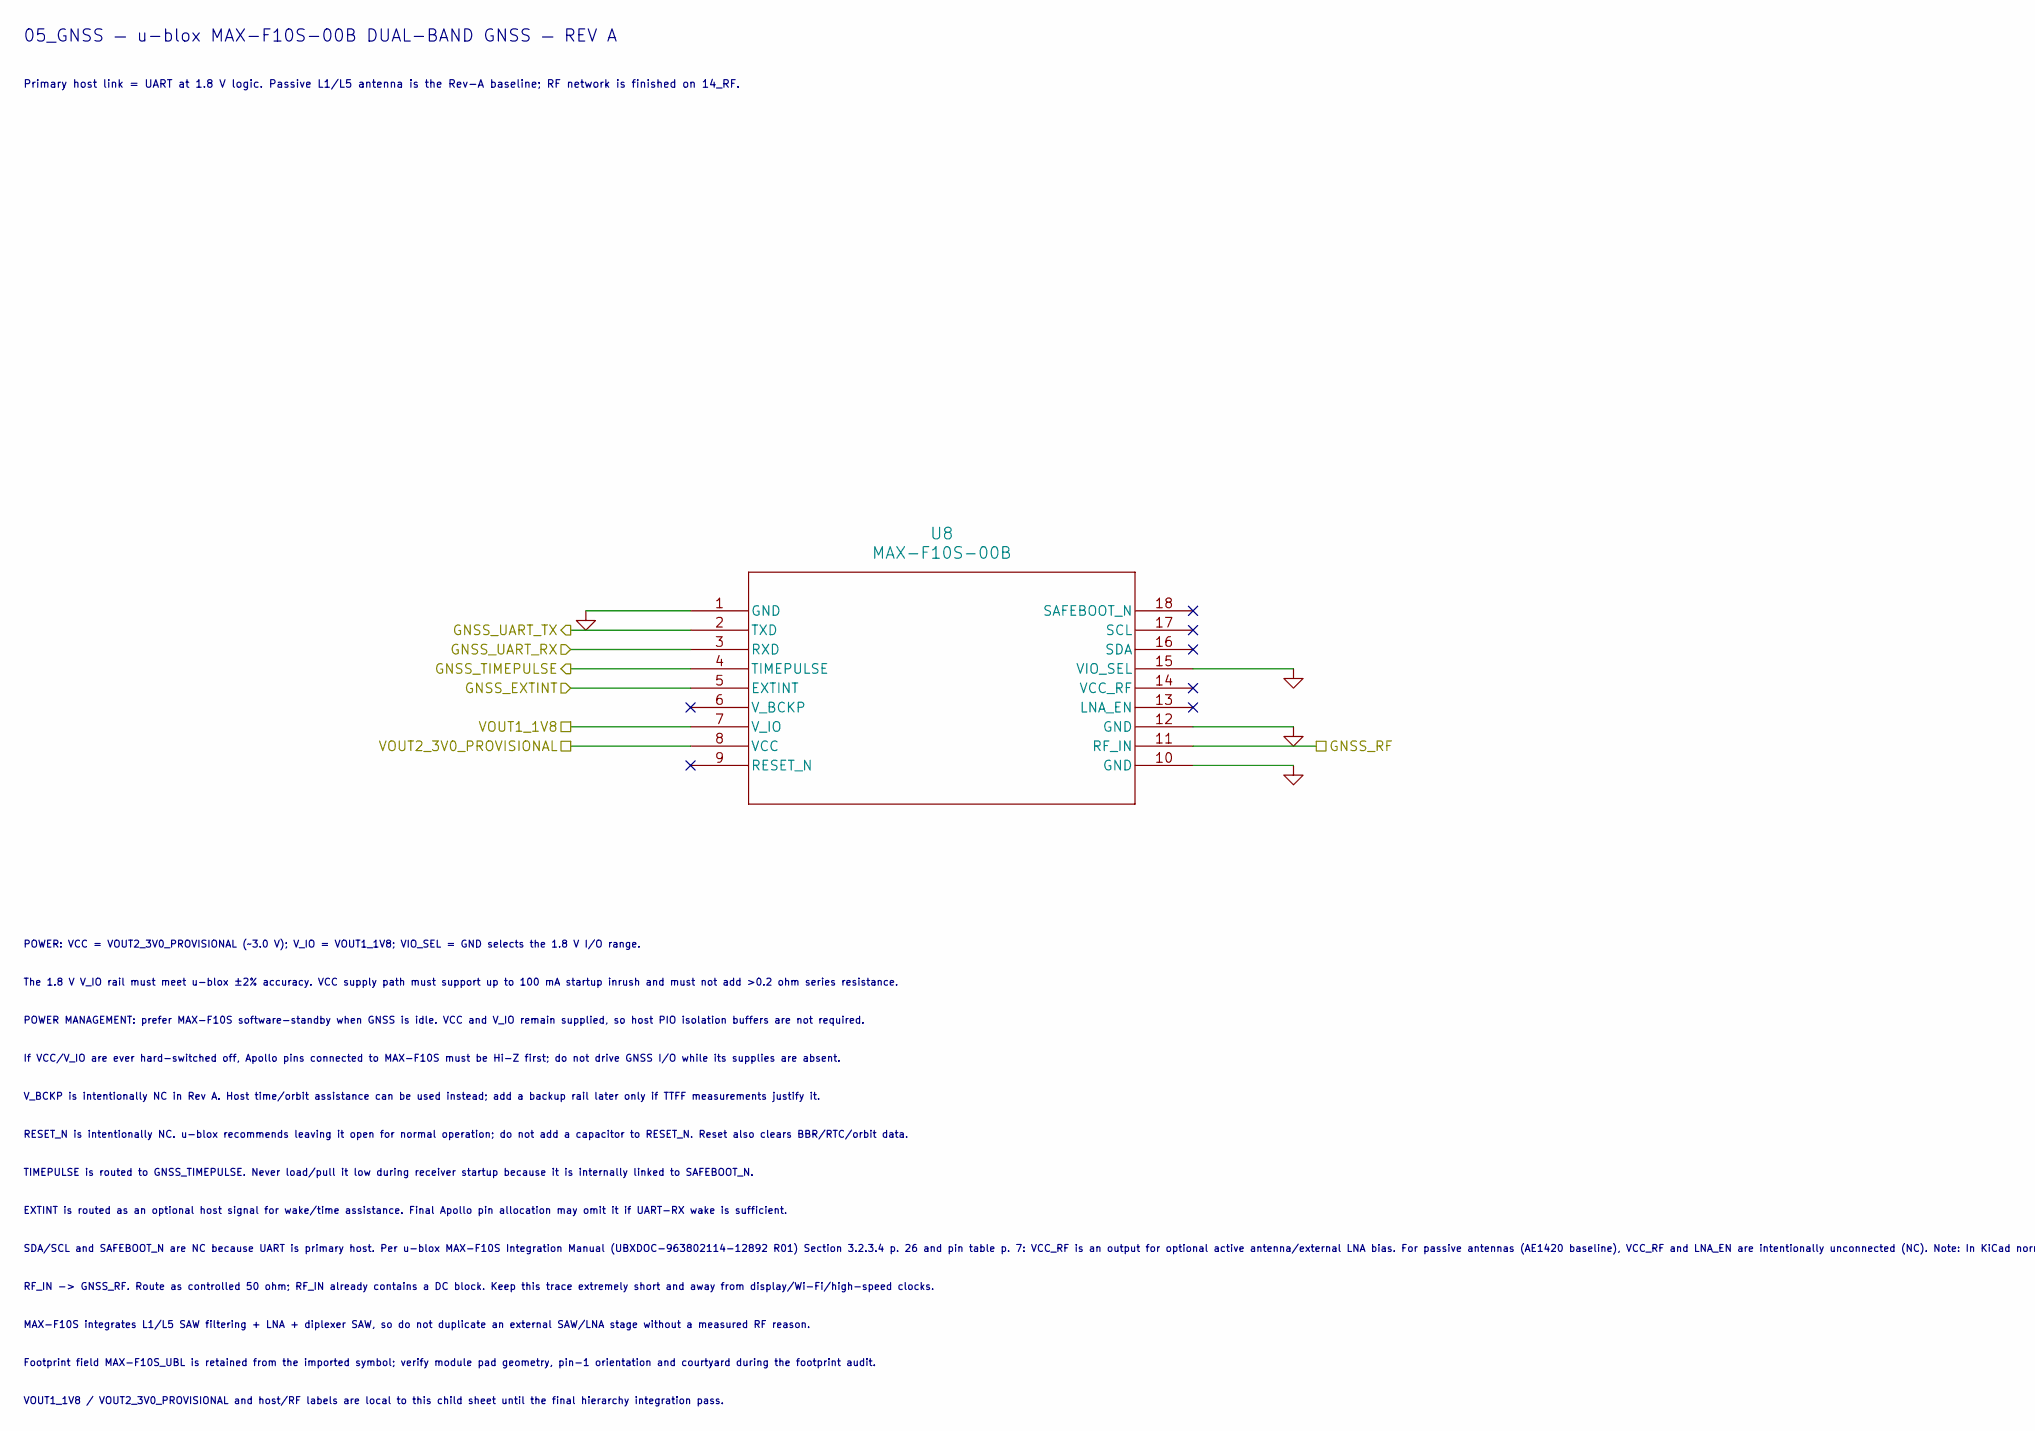
[picture p10: schematic 05_GNSS.kicad_sch, Rev-A — GNSS, part in row 1, column 1]

Parts:
U8: MAX-F10S-00B; MAX-F10S_UBL

Connections:
/GNSS_EXTINT: U8.5 (EXTINT); also elsewhere on the board
/GNSS_RF: U8.11 (RF_IN); also elsewhere on the board
/GNSS_TIMEPULSE: U8.4 (TIMEPULSE); also elsewhere on the board
/GNSS_UART_RX: U8.3 (RXD); also elsewhere on the board
/GNSS_UART_TX: U8.2 (TXD); also elsewhere on the board
/VOUT2_3V0_PROVISIONAL: U8.8 (VCC); also elsewhere on the board
GND: U8.1 (GND), U8.10 (GND), U8.12 (GND), U8.15 (VIO_SEL); also elsewhere on the board
VOUT1_1V8: U8.7 (V_IO); also elsewhere on the board

Notes on the sheet:
EXTINT is routed as an optional host signal for wake/time assistance. Final Apollo pin allocation may omit it if UART-RX wake is sufficient.
VOUT1_1V8 / VOUT2_3V0_PROVISIONAL and host/RF labels are local to this child sheet until the final hierarchy integration pass.
SDA/SCL and SAFEBOOT_N are NC because UART is primary host. Per u-blox MAX-F10S Integration Manual (UBXDOC-963802114-12892 R01) Section 3.2.3.4 p. 26 and pin table p. 7: VCC_RF is an output for optional active antenna/external LNA bias. For passive antennas (AE1420 baseline), VCC_RF and LNA_EN are 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
Primary host link = UART at 1.8 V logic. Passive L1/L5 antenna is the Rev-A baseline; RF network is finished on 14_RF.
If VCC/V_IO are ever hard-switched off, Apollo pins connected to MAX-F10S must be Hi-Z first; do not drive GNSS I/O while its supplies are absent.
The 1.8 V V_IO rail must meet u-blox ±2% accuracy. VCC supply path must support up to 100 mA startup inrush and must not add >0.2 ohm series resistance.
MAX-F10S integrates L1/L5 SAW filtering + LNA + diplexer SAW, so do not duplicate an external SAW/LNA stage without a measured RF reason.
RESET_N is intentionally NC. u-blox recommends leaving it open for normal operation; do not add a capacitor to RESET_N. Reset also clears BBR/RTC/orbit data.
RF_IN -> GNSS_RF. Route as controlled 50 ohm; RF_IN already contains a DC block. Keep this trace extremely short and away from display/Wi-Fi/high-speed clocks.
POWER: VCC = VOUT2_3V0_PROVISIONAL (~3.0 V); V_IO = VOUT1_1V8; VIO_SEL = GND selects the 1.8 V I/O range.
TIMEPULSE is routed to GNSS_TIMEPULSE. Never load/pull it low during receiver startup because it is internally linked to SAFEBOOT_N.
05_GNSS — u-blox MAX-F10S-00B DUAL-BAND GNSS — REV A
POWER MANAGEMENT: prefer MAX-F10S software-standby when GNSS is idle. VCC and V_IO remain supplied, so host PIO isolation buffers are not required.
Footprint field MAX-F10S_UBL is retained from the imported symbol; verify module pad geometry, pin-1 orientation and courtyard during the footprint audit.
V_BCKP is intentionally NC in Rev A. Host time/orbit assistance can be used instead; add a backup rail later only if TTFF measurements justify it.
