slimmpylk/Skoll_Ultra/sportwatch_revA.kicad_pcb

## KiCad design sportwatch_revA.kicad_pcb (continued)

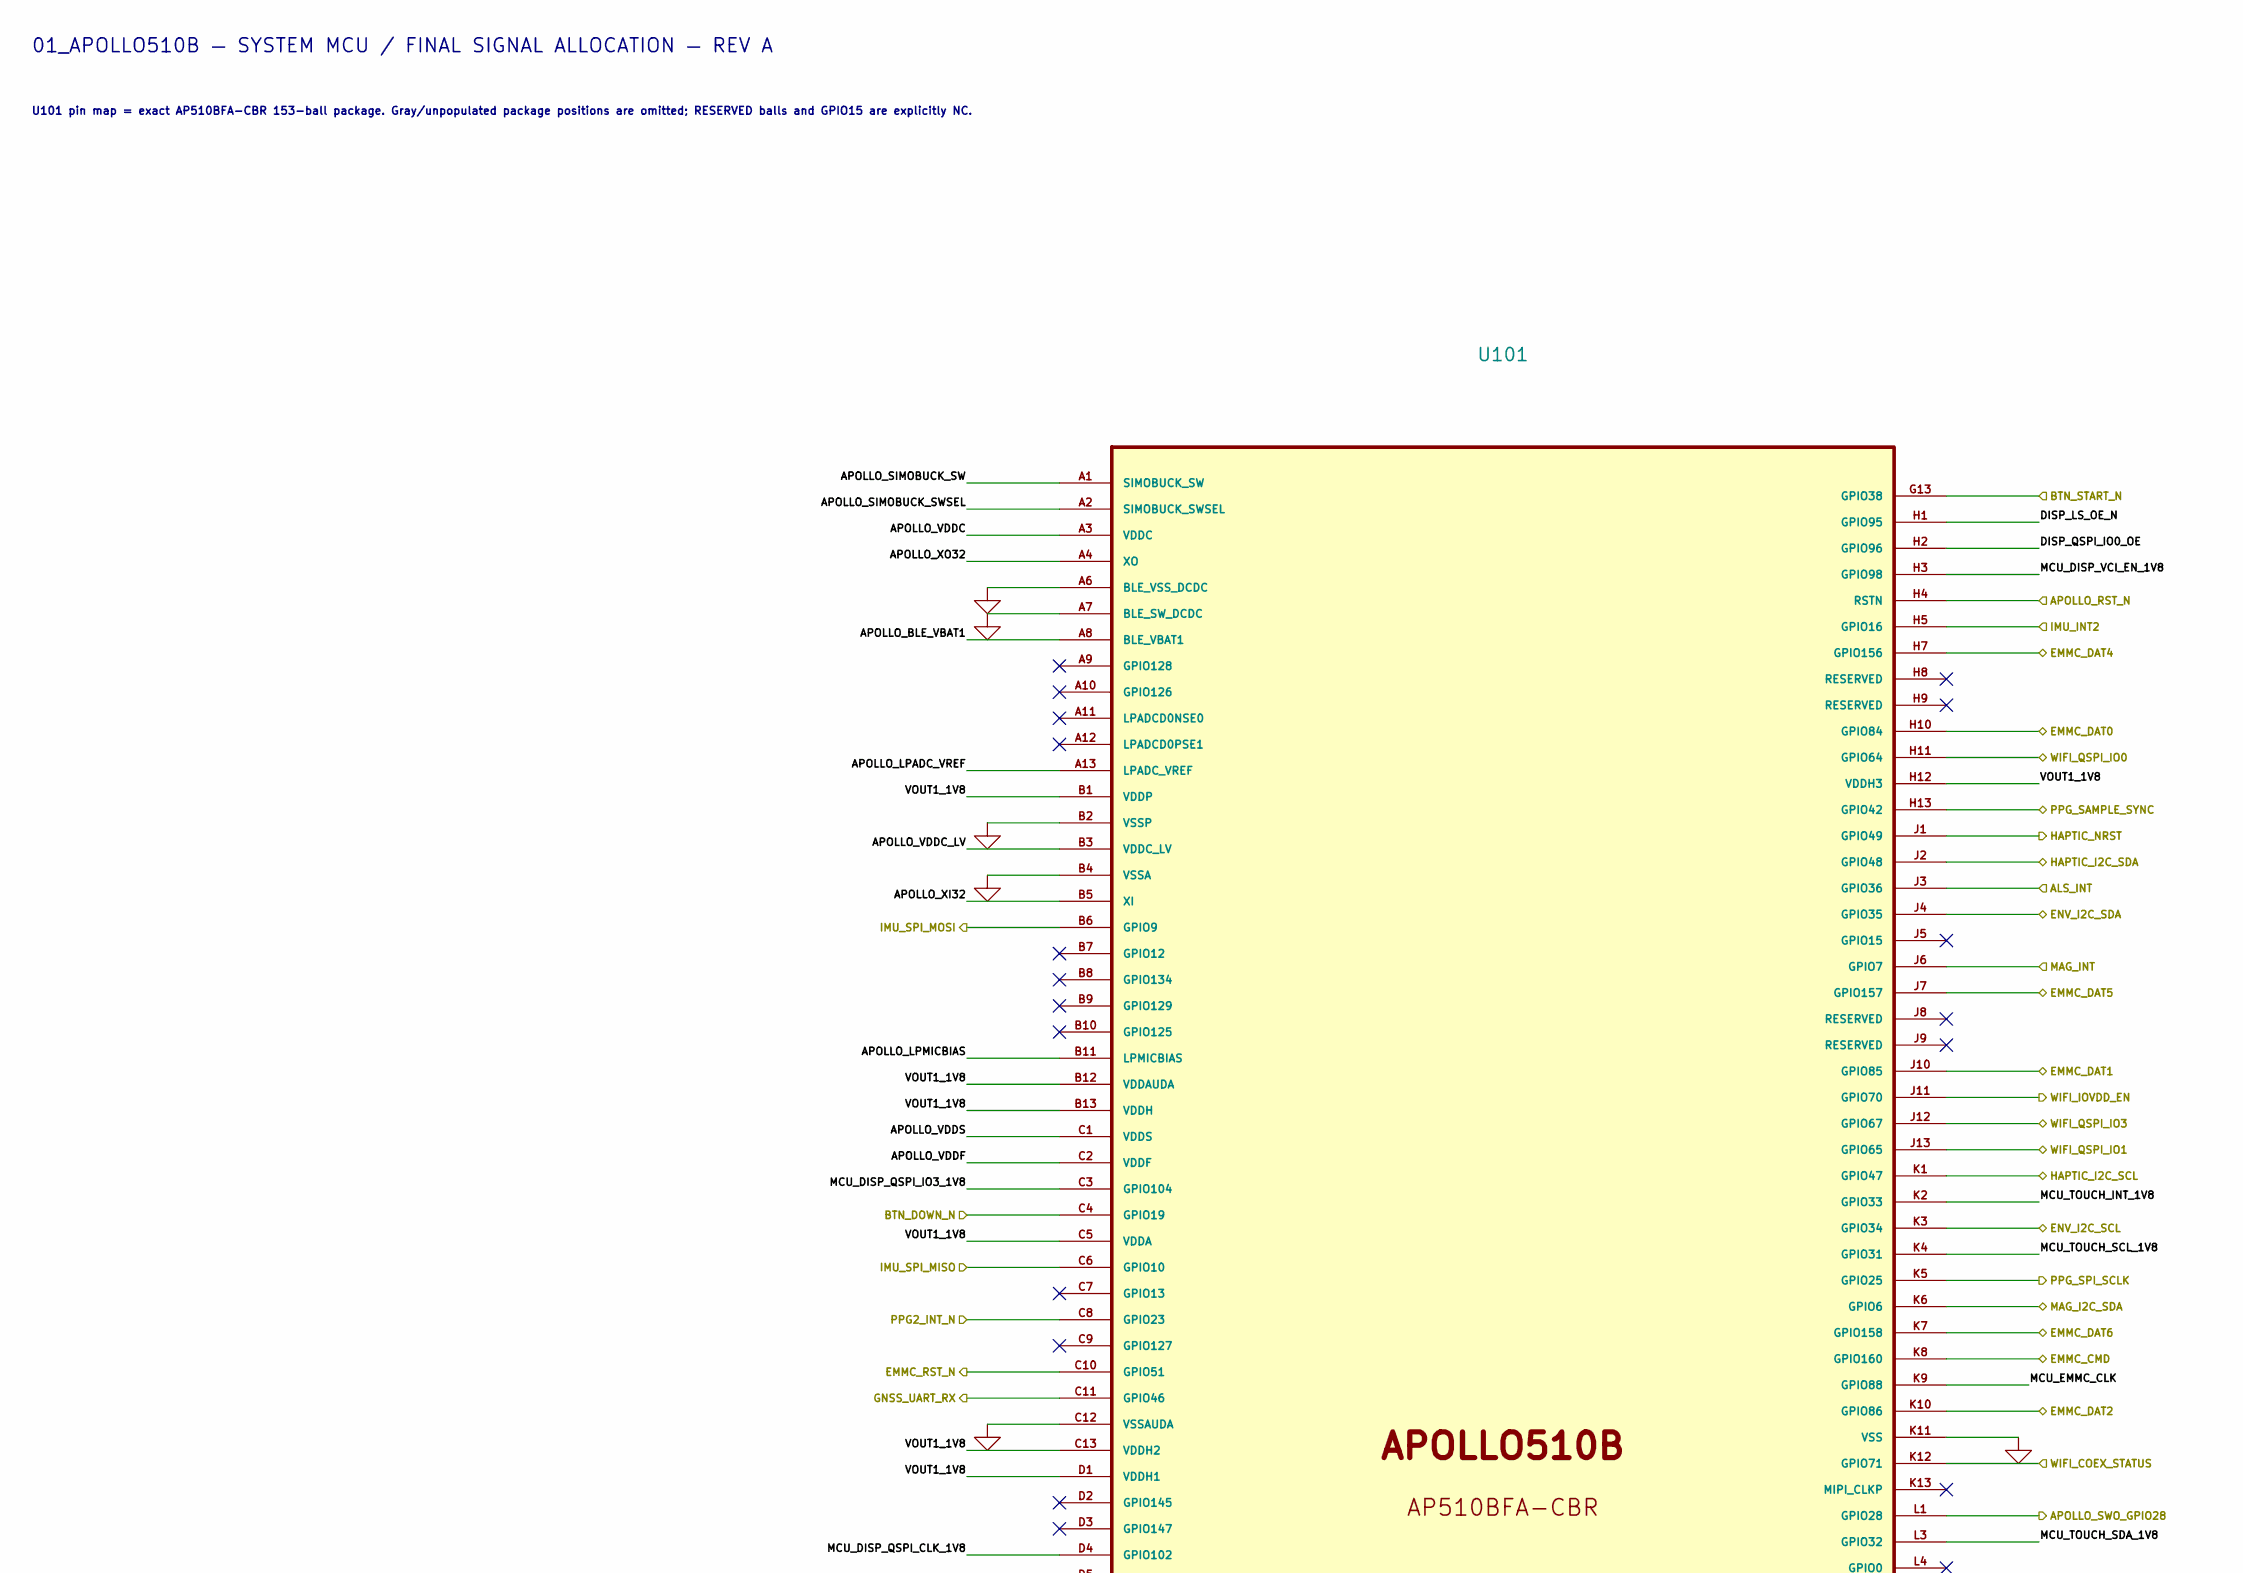
[picture p11: schematic 01_APOLLO510B.kicad_sch, Rev-A — Apollo510B MCU / System Integration, part in row 1, column 1]

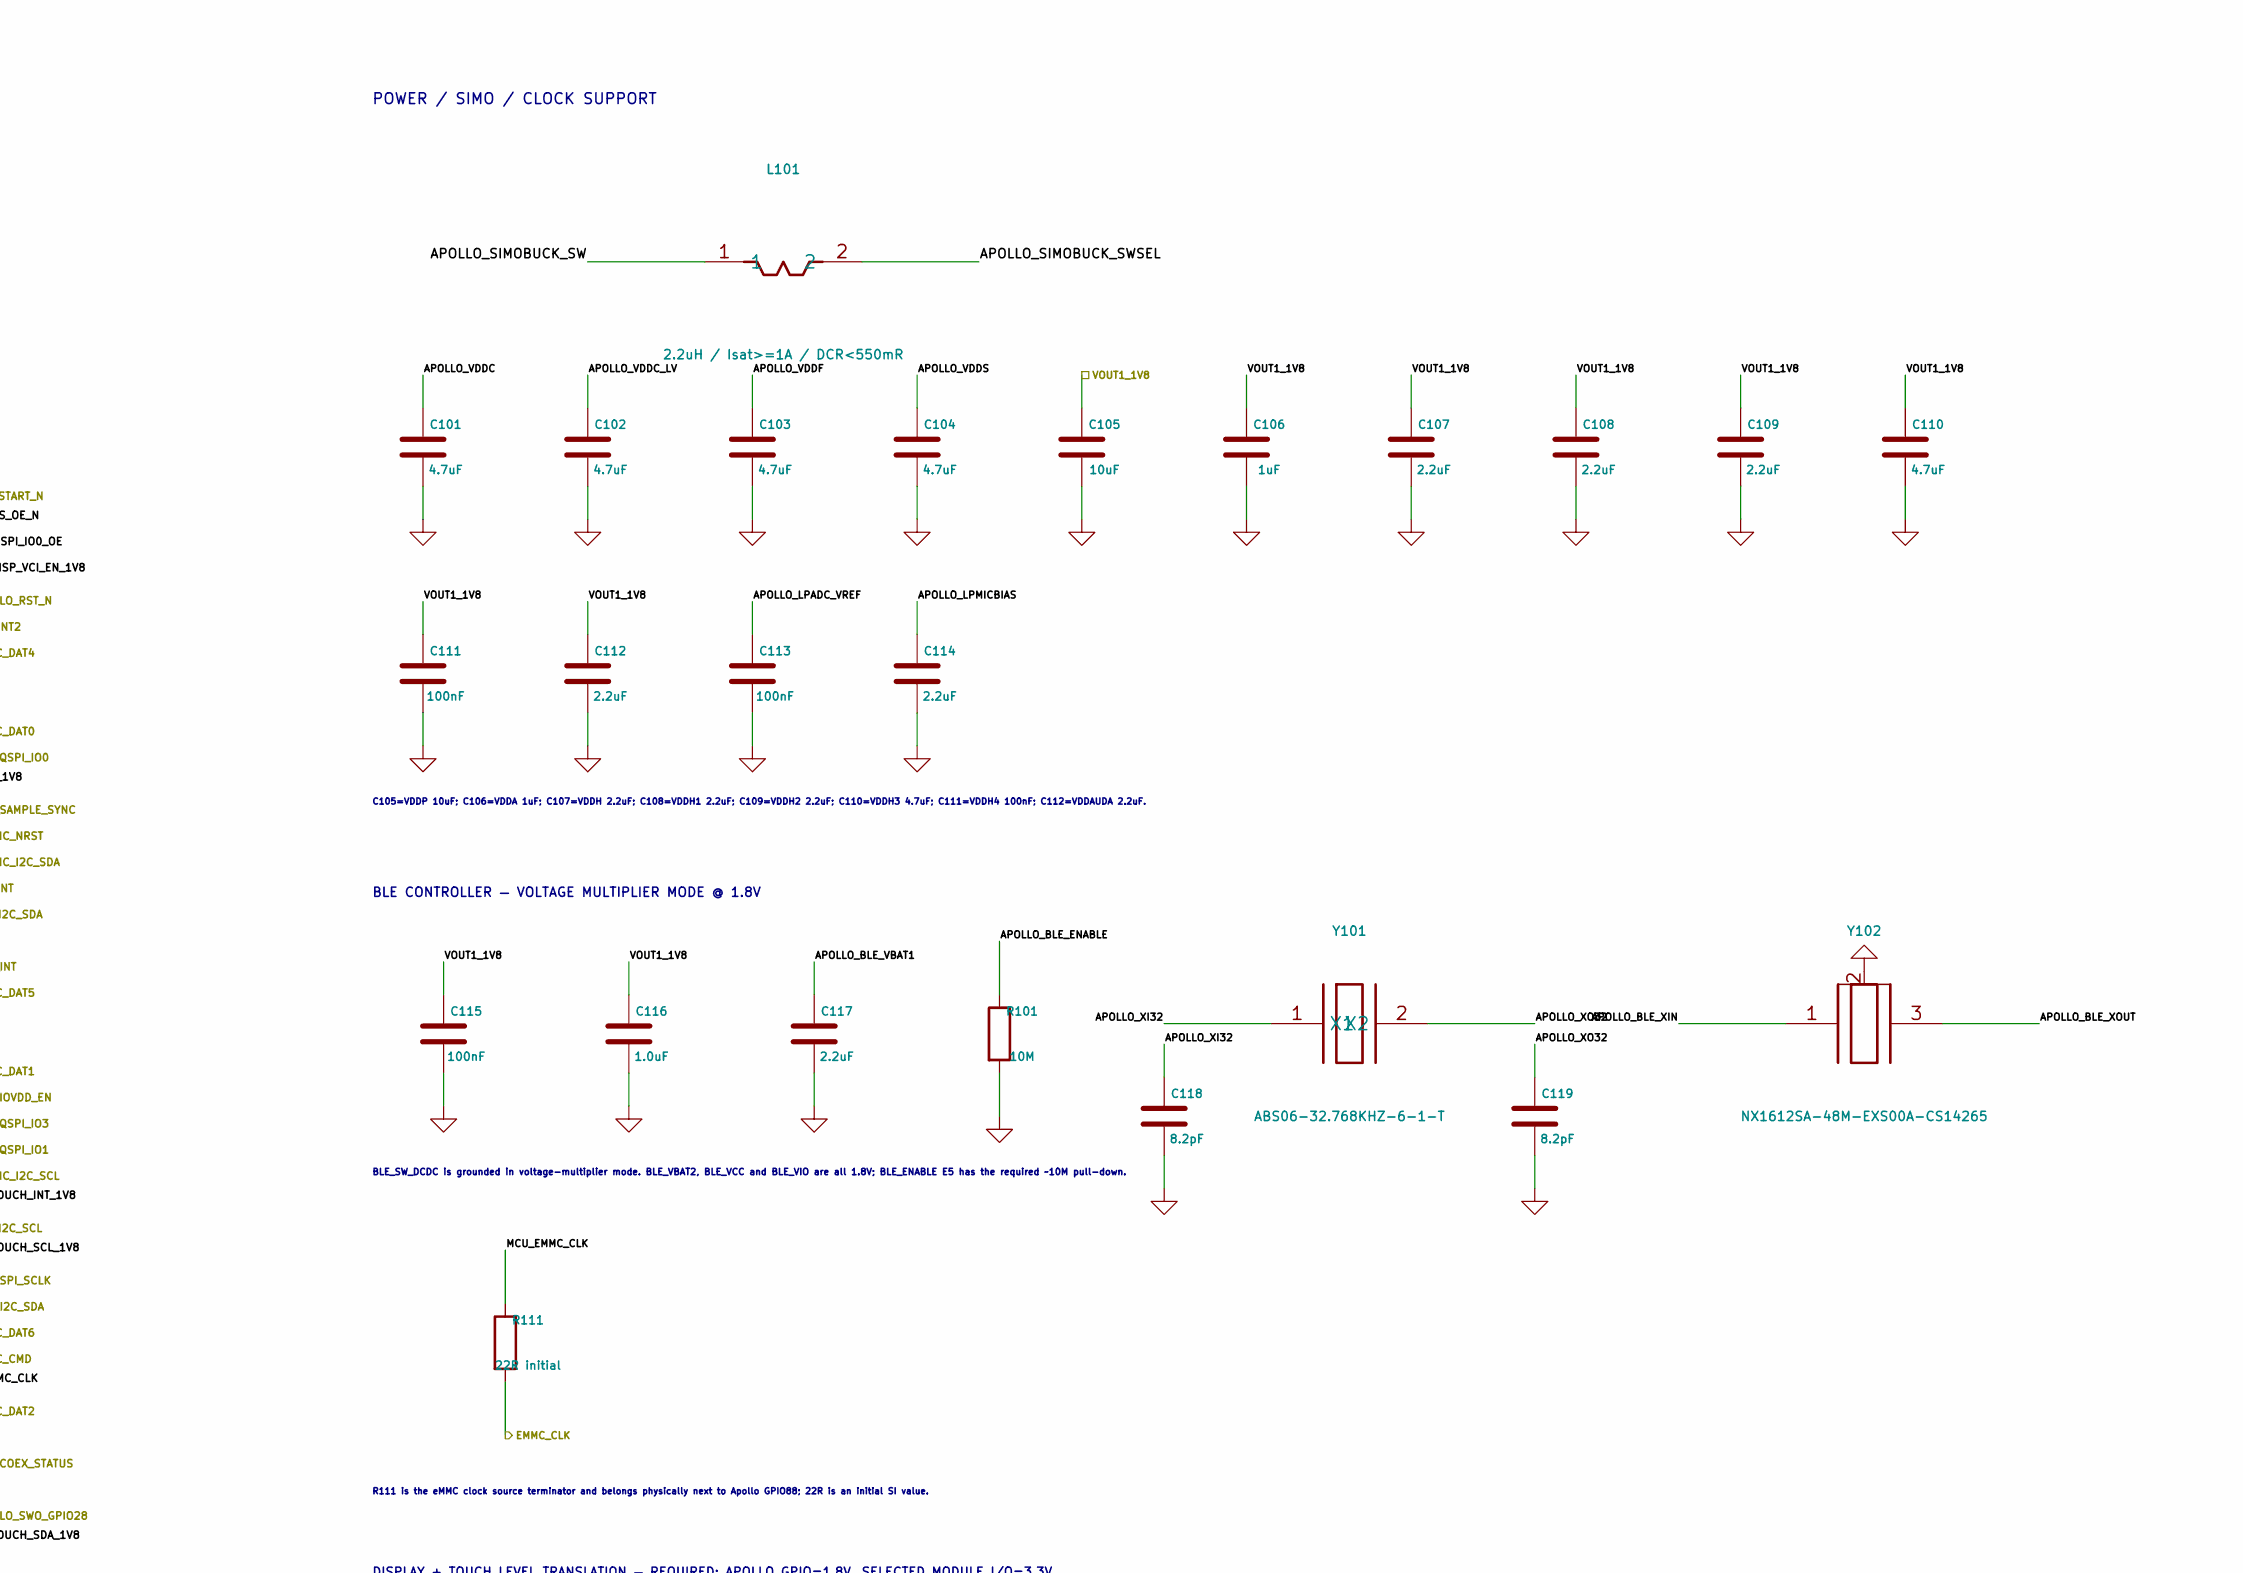
[picture p12: schematic 01_APOLLO510B.kicad_sch, Rev-A — Apollo510B MCU / System Integration, part in row 1, column 2]

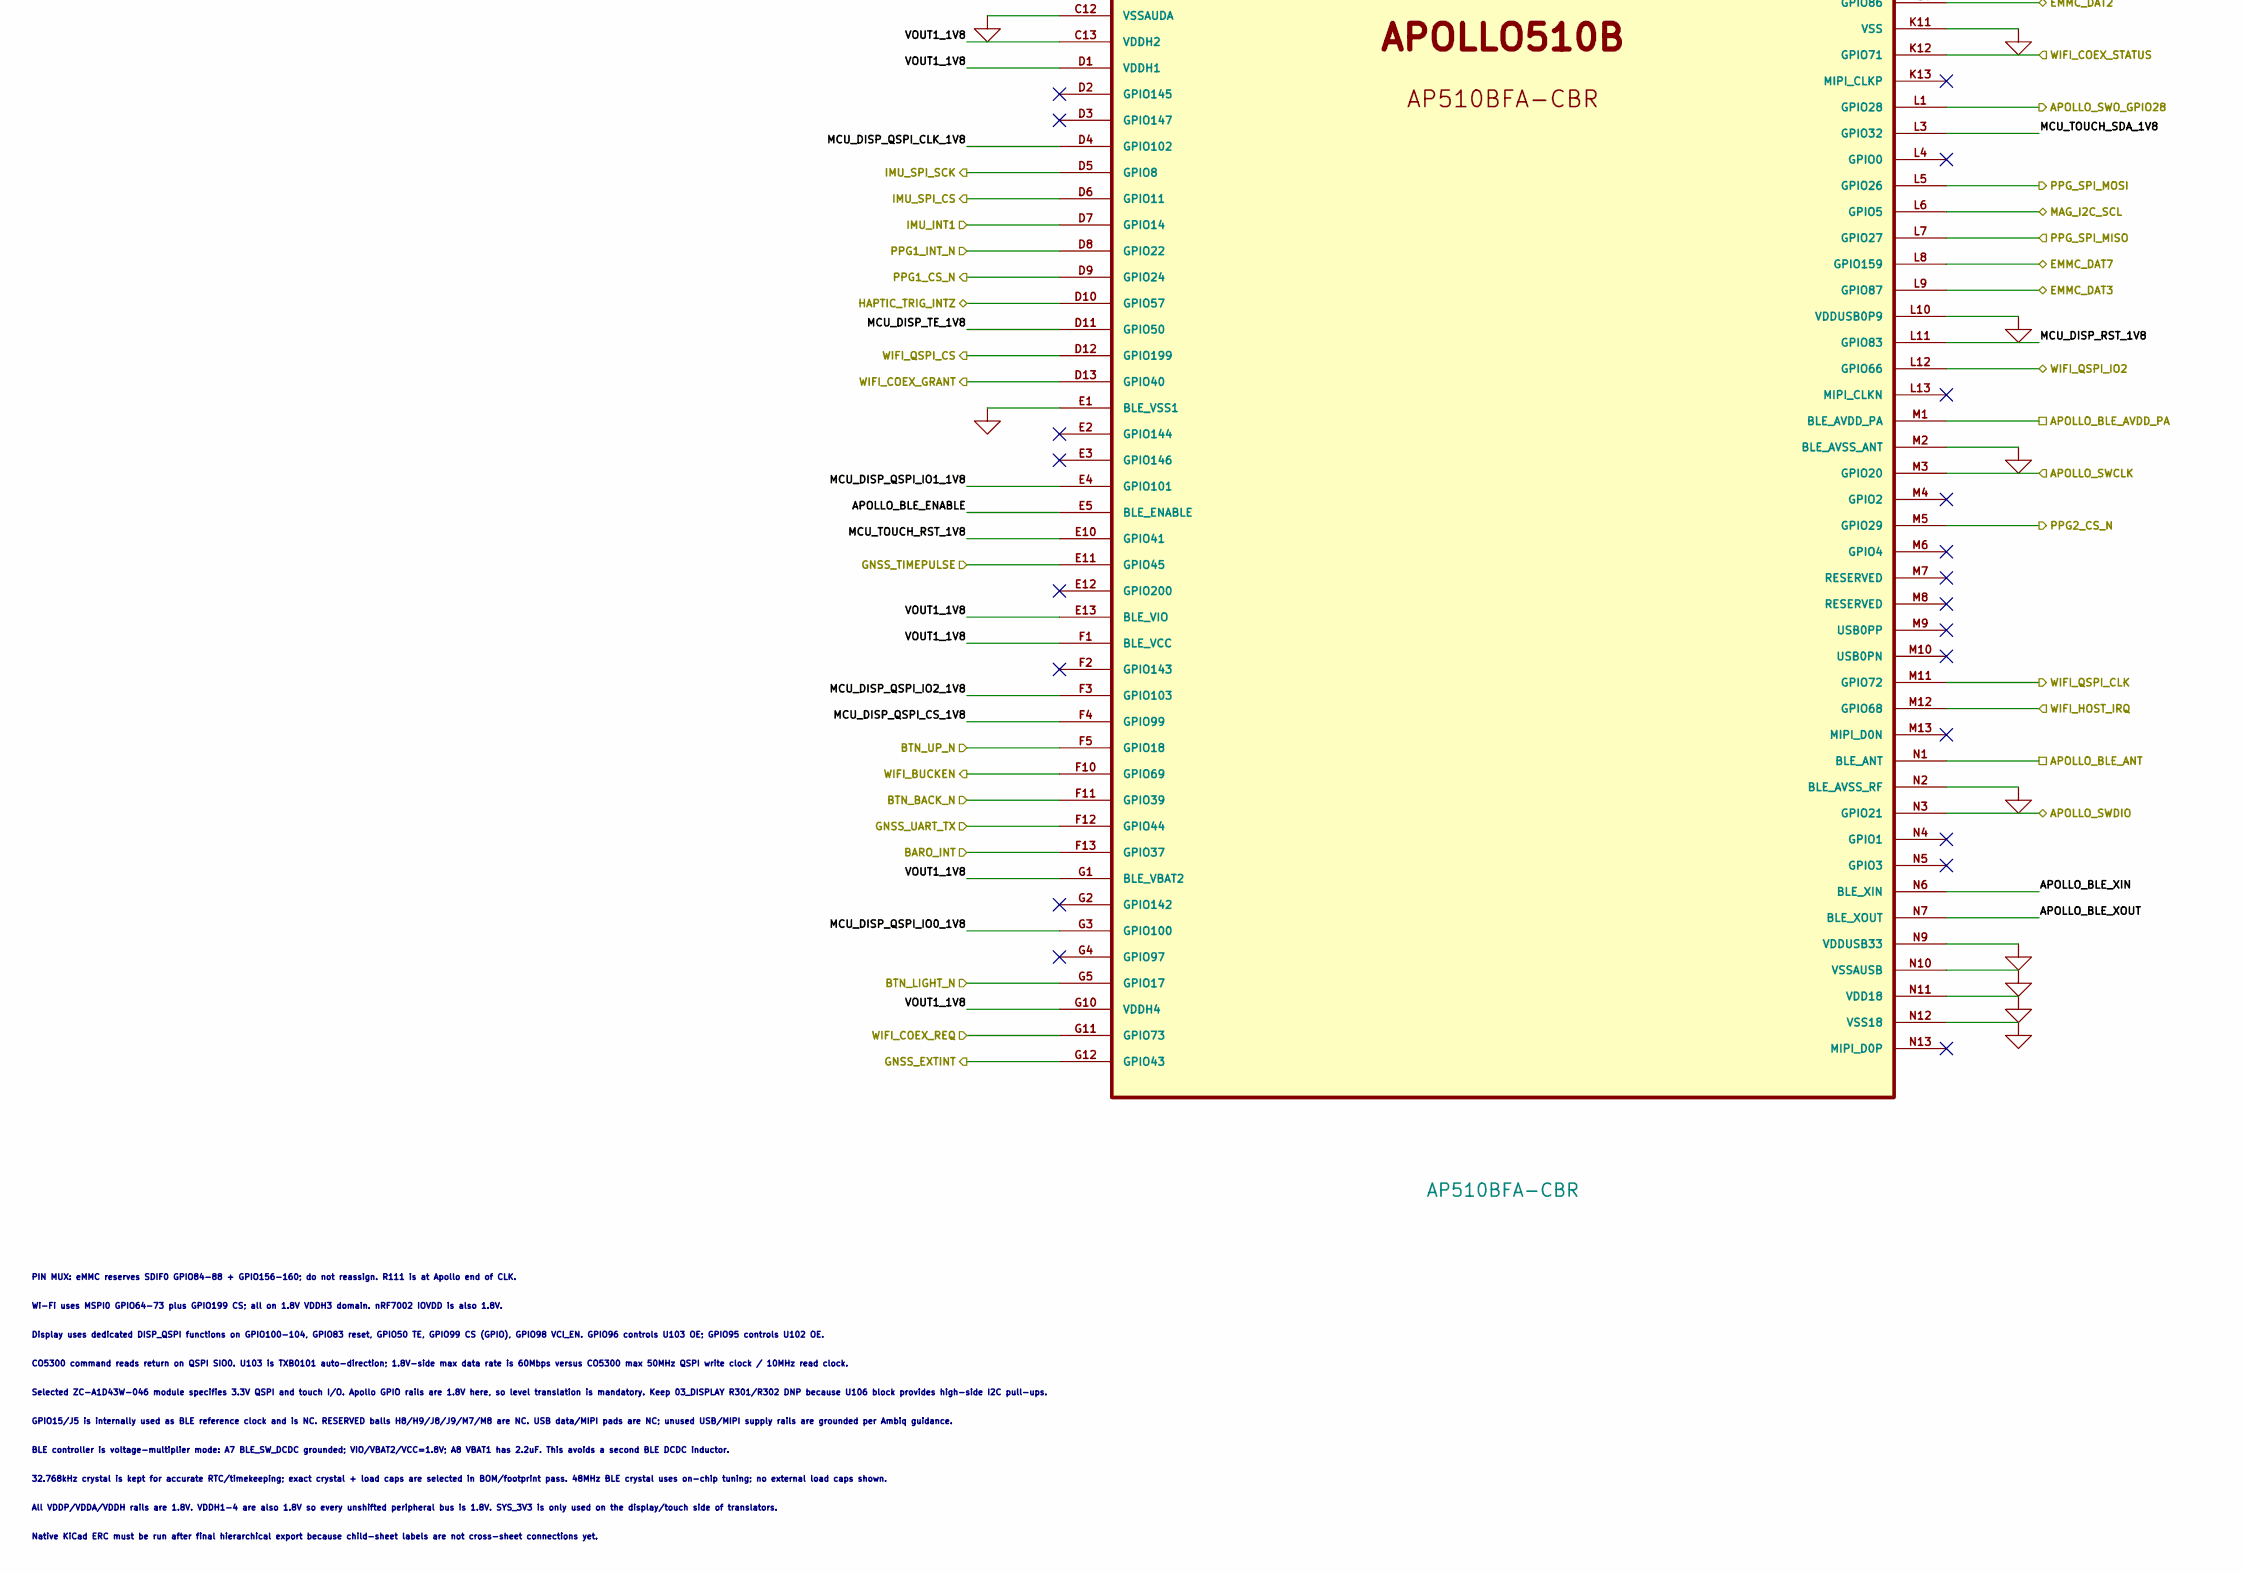
[picture p13: schematic 01_APOLLO510B.kicad_sch, Rev-A — Apollo510B MCU / System Integration, part in row 2, column 1]

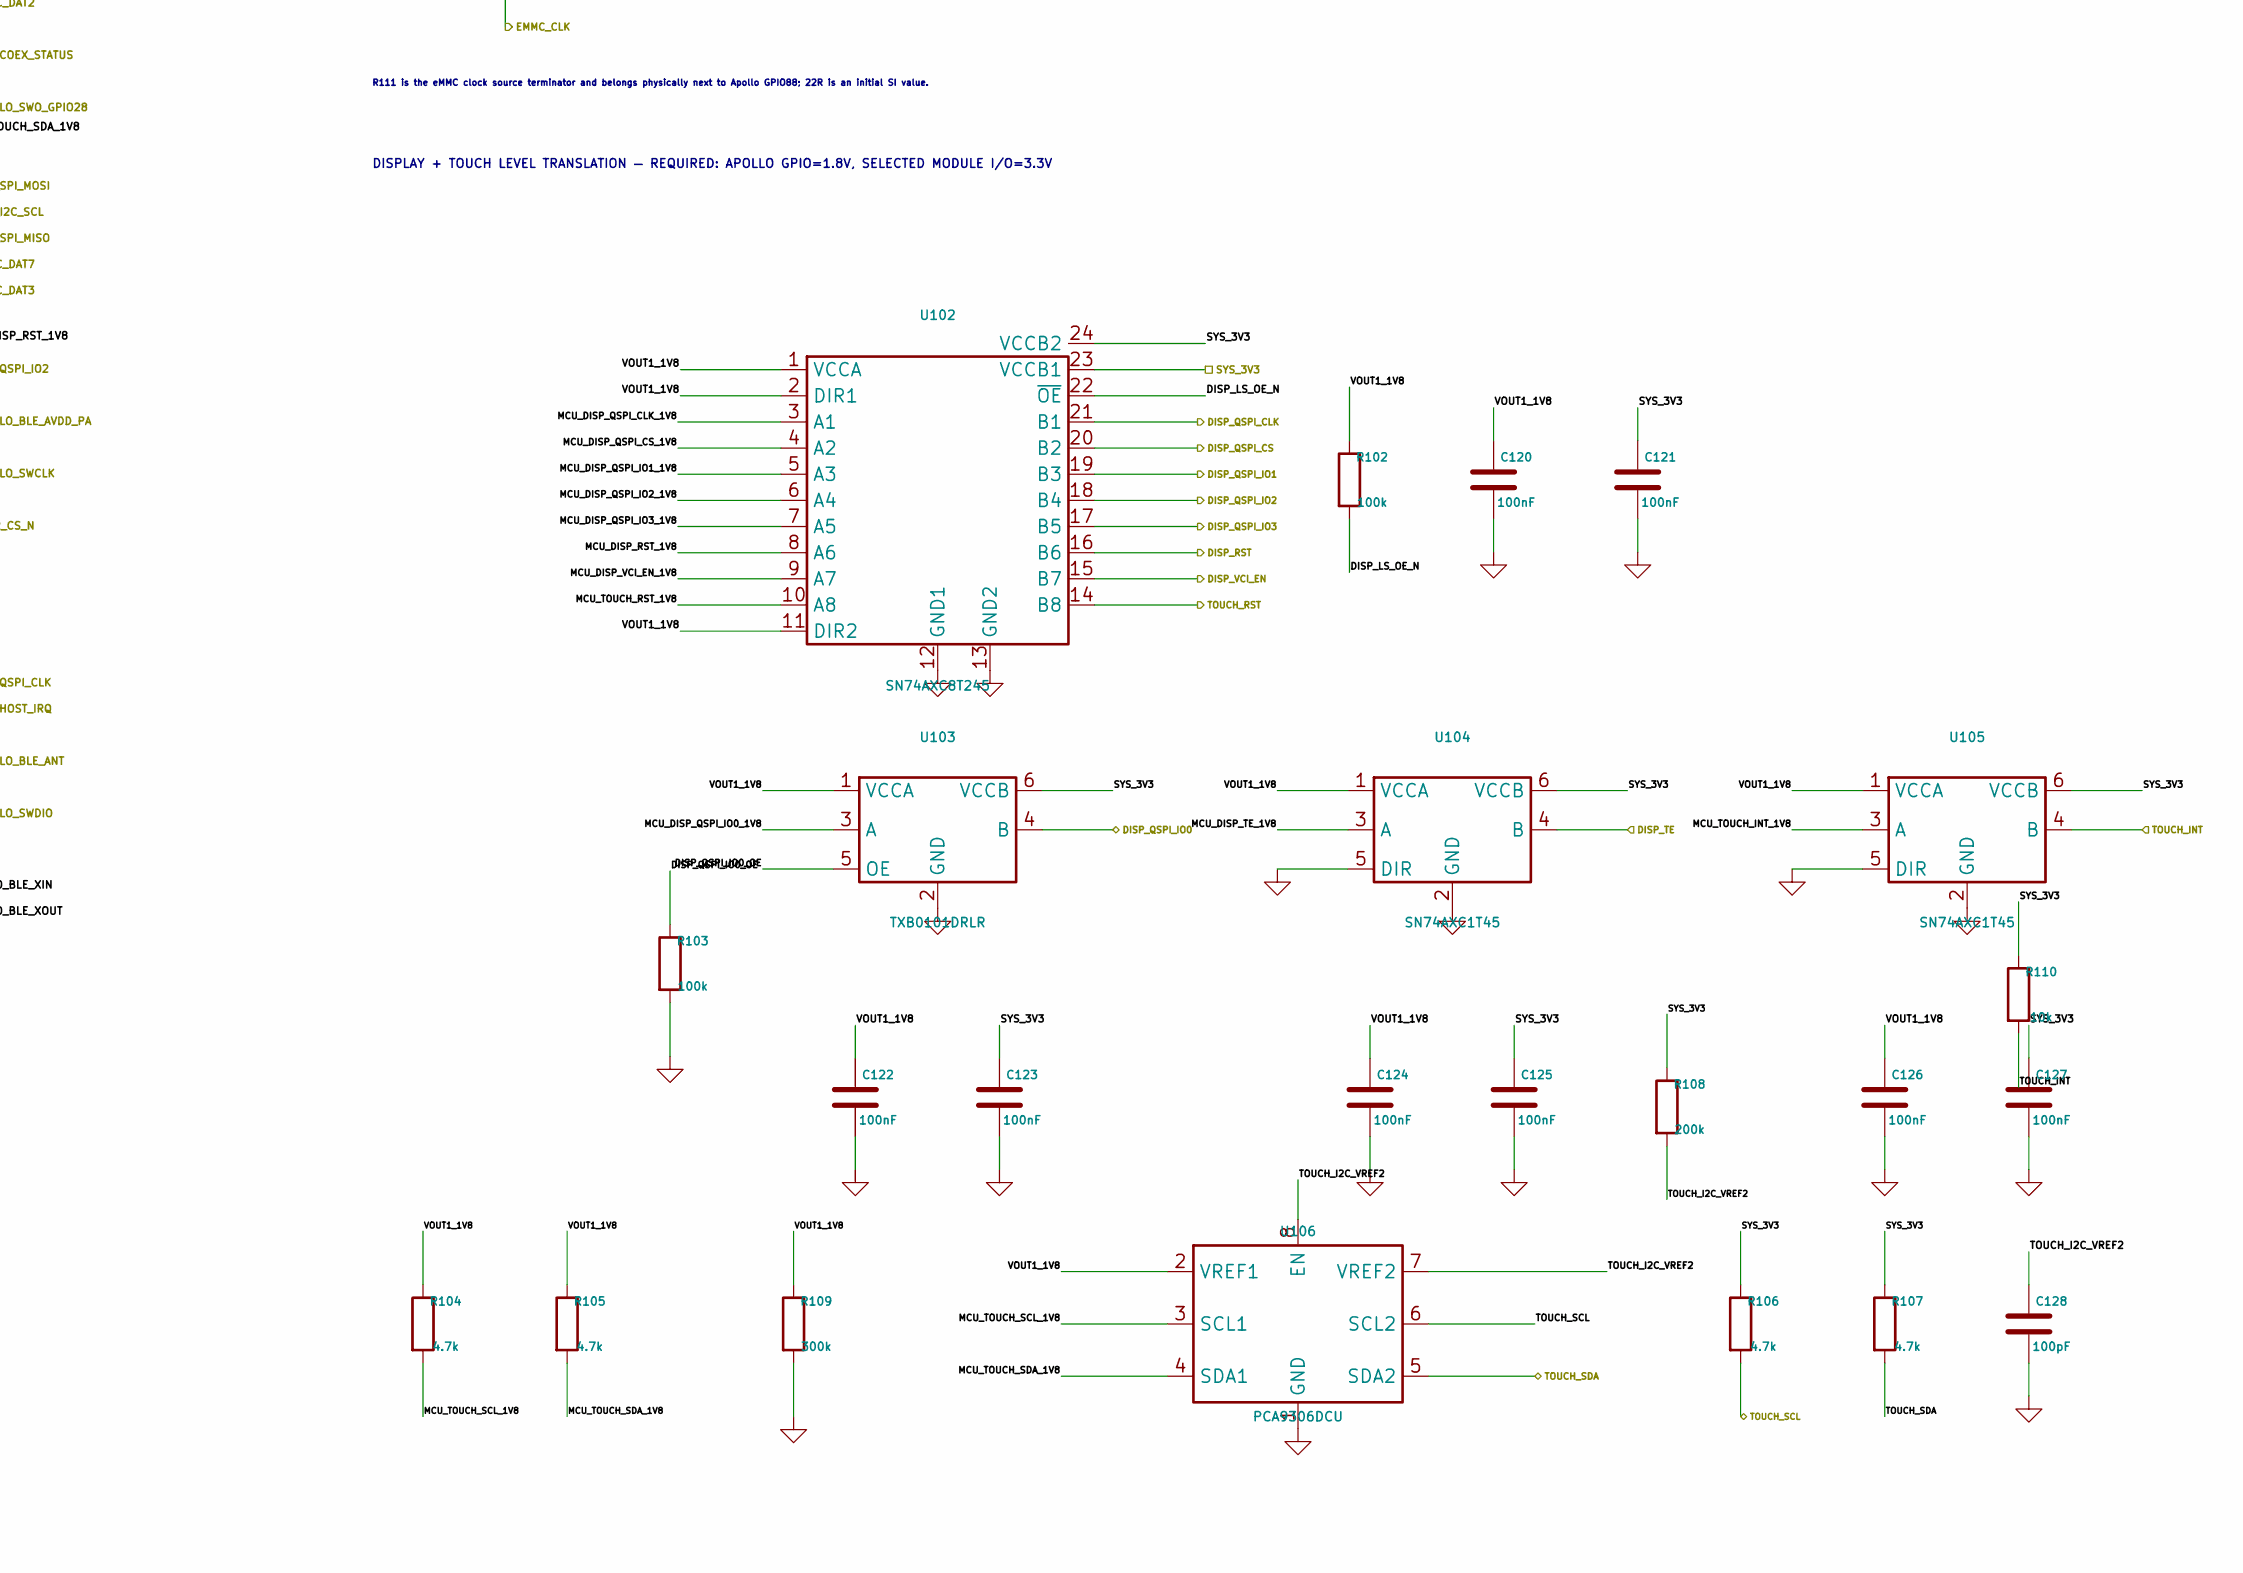
[picture p14: schematic 01_APOLLO510B.kicad_sch, Rev-A — Apollo510B MCU / System Integration, part in row 2, column 2]

Parts:
C101, C102, C103, C104: 4.7uF; C_0201_0603Metric
C105: 10uF; C_0402_1005Metric
C106: 1uF; C_0402_1005Metric
C107, C108, C109, C112, C114, C117: 2.2uF; C_0402_1005Metric
C110: 4.7uF; C_0402_1005Metric
C111, C113, C115, C120, C121, C122, C123, C124, C125, C126, C127: 100nF; C_0402_1005Metric
C116: 1.0uF; C_0402_1005Metric
C118, C119: 8.2pF; C_0201_0603Metric
C128: 100pF; C_0201_0603Metric
L101: 2.2uH / Isat>=1A / DCR<550mR; L_0603_1608Metric
R101: 10M; R_0402_1005Metric
R102, R103: 100k; R_0402_1005Metric
R104, R105, R106, R107: 4.7k; R_0402_1005Metric
R108: 200k; R_0402_1005Metric
R109: 300k; R_0402_1005Metric
R110: 10k; R_0402_1005Metric
R111: 22R initial; R_0201_0603Metric
U101: AP510BFA-CBR; BGA-153_5.6x5.6mm_Layout13x13_P0.4mm_Ball0.25mm_Pad0.22mm_N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
U102: SN74AXC8T245; Texas_RHL0024A
U103: TXB0101DRLR; SOT-563
U104, U105: SN74AXC1T45; SOT-563
U106: PCA9306DCU; VSSOP-8_2.3x2mm_P0.5mm
Y101: ABS06-32.768KHZ-6-1-T; Crystal_SMD_ABS06_2.0x1.2mm
Y102: NX1612SA-48M-EXS00A-CS14265; Crystal_1612-4Pin_1.6x1.2mm

Connections:
/01_APOLLO510B/APOLLO_BLE_ENABLE: R101.1, U101.E5 (BLE_ENABLE)
/01_APOLLO510B/APOLLO_BLE_VBAT1: C117.1, U101.A8 (BLE_VBAT1)
/01_APOLLO510B/APOLLO_BLE_XIN: U101.N6 (BLE_XIN), Y102.1
/01_APOLLO510B/APOLLO_BLE_XOUT: U101.N7 (BLE_XOUT), Y102.3
/01_APOLLO510B/APOLLO_LPADC_VREF: C113.1, U101.A13 (LPADC_VREF)
/01_APOLLO510B/APOLLO_LPMICBIAS: C114.1, U101.B11 (LPMICBIAS)
/01_APOLLO510B/APOLLO_SIMOBUCK_SW: L101.1, U101.A1 (SIMOBUCK_SW)
/01_APOLLO510B/APOLLO_SIMOBUCK_SWSEL: L101.2, U101.A2 (SIMOBUCK_SWSEL)
/01_APOLLO510B/APOLLO_VDDC: C101.1, U101.A3 (VDDC)
/01_APOLLO510B/APOLLO_VDDC_LV: C102.1, U101.B3 (VDDC_LV)
/01_APOLLO510B/APOLLO_VDDF: C103.1, U101.C2 (VDDF)
/01_APOLLO510B/APOLLO_VDDS: C104.1, U101.C1 (VDDS)
/01_APOLLO510B/APOLLO_XI32: C118.1, U101.B5 (XI), Y101.1 (X1)
/01_APOLLO510B/APOLLO_XO32: C119.1, U101.A4 (XO), Y101.2 (X2)
/01_APOLLO510B/DISP_LS_OE_N: R102.2, U101.H1 (GPIO95), U102.22 (~OE)
/01_APOLLO510B/DISP_QSPI_IO0_OE: R103.1, U101.H2 (GPIO96), U103.5 (OE)
/01_APOLLO510B/MCU_DISP_QSPI_CLK_1V8: U101.D4 (GPIO102), U102.3 (A1)
/01_APOLLO510B/MCU_DISP_QSPI_CS_1V8: U101.F4 (GPIO99), U102.4 (A2)
/01_APOLLO510B/MCU_DISP_QSPI_IO0_1V8: U101.G3 (GPIO100), U103.3 (A)
/01_APOLLO510B/MCU_DISP_QSPI_IO1_1V8: U101.E4 (GPIO101), U102.5 (A3)
/01_APOLLO510B/MCU_DISP_QSPI_IO2_1V8: U101.F3 (GPIO103), U102.6 (A4)
/01_APOLLO510B/MCU_DISP_QSPI_IO3_1V8: U101.C3 (GPIO104), U102.7 (A5)
/01_APOLLO510B/MCU_DISP_RST_1V8: U101.L11 (GPIO83), U102.8 (A6)
/01_APOLLO510B/MCU_DISP_TE_1V8: U101.D11 (GPIO50), U104.3 (A)
/01_APOLLO510B/MCU_DISP_VCI_EN_1V8: U101.H3 (GPIO98), U102.9 (A7)
/01_APOLLO510B/MCU_EMMC_CLK: R111.1, U101.K9 (GPIO88)
/01_APOLLO510B/MCU_TOUCH_INT_1V8: U101.K2 (GPIO33), U105.3 (A)
/01_APOLLO510B/MCU_TOUCH_RST_1V8: U101.E10 (GPIO41), U102.10 (A8)
/01_APOLLO510B/MCU_TOUCH_SCL_1V8: R104.2, U101.K4 (GPIO31), U106.3 (SCL1)
/01_APOLLO510B/MCU_TOUCH_SDA_1V8: R105.2, U101.L3 (GPIO32), U106.4 (SDA1)
/01_APOLLO510B/TOUCH_I2C_VREF2: C128.1, R108.2, U106.7 (VREF2), U106.8 (EN)
/APOLLO_BLE_ANT: U101.N1 (BLE_ANT); also elsewhere on the board
/APOLLO_BLE_AVDD_PA: U101.M1 (BLE_AVDD_PA); also elsewhere on the board
/APOLLO_RST_N: U101.H4 (RSTN); also elsewhere on the board
/APOLLO_SWCLK: U101.M3 (GPIO20); also elsewhere on the board
/APOLLO_SWDIO: U101.N3 (GPIO21); also elsewhere on the board
/APOLLO_SWO_GPIO28: U101.L1 (GPIO28); also elsewhere on the board
/BTN_BACK_N: U101.F11 (GPIO39); also elsewhere on the board
/BTN_DOWN_N: U101.C4 (GPIO19); also elsewhere on the board
/BTN_LIGHT_N: U101.G5 (GPIO17); also elsewhere on the board
/BTN_START_N: U101.G13 (GPIO38); also elsewhere on the board
/BTN_UP_N: U101.F5 (GPIO18); also elsewhere on the board
/DISP_QSPI_CLK: U102.21 (B1); also elsewhere on the board
/DISP_QSPI_CS: U102.20 (B2); also elsewhere on the board
/DISP_QSPI_IO0: U103.4 (B); also elsewhere on the board
/DISP_QSPI_IO1: U102.19 (B3); also elsewhere on the board
/DISP_QSPI_IO2: U102.18 (B4); also elsewhere on the board
/DISP_QSPI_IO3: U102.17 (B5); also elsewhere on the board
/DISP_RST: U102.16 (B6); also elsewhere on the board
/DISP_TE: U104.4 (B); also elsewhere on the board
/DISP_VCI_EN: U102.15 (B7); also elsewhere on the board
/EMMC_CLK: R111.2; also elsewhere on the board
/EMMC_CMD: U101.K8 (GPIO160); also elsewhere on the board
/EMMC_DAT0: U101.H10 (GPIO84); also elsewhere on the board
/EMMC_DAT1: U101.J10 (GPIO85); also elsewhere on the board
/EMMC_DAT2: U101.K10 (GPIO86); also elsewhere on the board
/EMMC_DAT3: U101.L9 (GPIO87); also elsewhere on the board
/EMMC_DAT4: U101.H7 (GPIO156); also elsewhere on the board
/EMMC_DAT5: U101.J7 (GPIO157); also elsewhere on the board
/EMMC_DAT6: U101.K7 (GPIO158); also elsewhere on the board
/EMMC_DAT7: U101.L8 (GPIO159); also elsewhere on the board
/EMMC_RST_N: U101.C10 (GPIO51); also elsewhere on the board
/GNSS_EXTINT: U101.G12 (GPIO43); also elsewhere on the board
/GNSS_TIMEPULSE: U101.E11 (GPIO45); also elsewhere on the board
/GNSS_UART_RX: U101.C11 (GPIO46); also elsewhere on the board
/GNSS_UART_TX: U101.F12 (GPIO44); also elsewhere on the board
/HAPTIC_I2C_SCL: U101.K1 (GPIO47); also elsewhere on the board
/HAPTIC_I2C_SDA: U101.J2 (GPIO48); also elsewhere on the board
/HAPTIC_NRST: U101.J1 (GPIO49); also elsewhere on the board
/HAPTIC_TRIG_INTZ: U101.D10 (GPIO57); also elsewhere on the board
/IMU_INT1: U101.D7 (GPIO14); also elsewhere on the board
/IMU_INT2: U101.H5 (GPIO16); also elsewhere on the board
/IMU_SPI_CS: U101.D6 (GPIO11); also elsewhere on the board
/IMU_SPI_MISO: U101.C6 (GPIO10); also elsewhere on the board
/IMU_SPI_MOSI: U101.B6 (GPIO9); also elsewhere on the board
/IMU_SPI_SCK: U101.D5 (GPIO8); also elsewhere on the board
/MAG_I2C_SCL: U101.L6 (GPIO5); also elsewhere on the board
/MAG_I2C_SDA: U101.K6 (GPIO6); also elsewhere on the board
/MAG_INT: U101.J6 (GPIO7); also elsewhere on the board
/SYS_3V3: C121.1, C123.1, C125.1, C127.1, R106.1, R107.1, R108.1, R110.1, U102.23 (VCCB1), U102.24 (VCCB2), U103.6 (VCCB), U104.6 (VCCB), U105.6 (VCCB); also elsewhere on the board
/TOUCH_INT: R110.2, U105.4 (B); also elsewhere on the board
/TOUCH_RST: U102.14 (B8); also elsewhere on the board
/TOUCH_SCL: R106.2, U106.6 (SCL2); also elsewhere on the board
/TOUCH_SDA: R107.2, U106.5 (SDA2); also elsewhere on the board
/WIFI_BUCKEN: U101.F10 (GPIO69); also elsewhere on the board
/WIFI_COEX_GRANT: U101.D13 (GPIO40); also elsewhere on the board
/WIFI_COEX_REQ: U101.G11 (GPIO73); also elsewhere on the board
/WIFI_COEX_STATUS: U101.K12 (GPIO71); also elsewhere on the board
/WIFI_HOST_IRQ: U101.M12 (GPIO68); also elsewhere on the board
/WIFI_IOVDD_EN: U101.J11 (GPIO70); also elsewhere on the board
/WIFI_QSPI_CLK: U101.M11 (GPIO72); also elsewhere on the board
/WIFI_QSPI_CS: U101.D12 (GPIO199); also elsewhere on the board
/WIFI_QSPI_IO0: U101.H11 (GPIO64); also elsewhere on the board
/WIFI_QSPI_IO1: U101.J13 (GPIO65); also elsewhere on the board
/WIFI_QSPI_IO2: U101.L12 (GPIO66); also elsewhere on the board
/WIFI_QSPI_IO3: U101.J12 (GPIO67); also elsewhere on the board
ALS_INT: U101.J3 (GPIO36); also elsewhere on the board
BARO_INT: U101.F13 (GPIO37); also elsewhere on the board
ENV_I2C_SCL: U101.K3 (GPIO34); also elsewhere on the board
ENV_I2C_SDA: U101.J4 (GPIO35); also elsewhere on the board
GND: C101.2, C102.2, C103.2, C104.2, C105.2, C106.2, C107.2, C108.2, C109.2, C110.2, C111.2, C112.2, C113.2, C114.2, C115.2, C116.2, C117.2, C118.2, C119.2, C120.2, C121.2, C122.2, C123.2, C124.2, C125.2, C126.2, C127.2, C128.2, R101.2, R103.2, R109.2, U101.A6 (BLE_VSS_DCDC), U101.A7 (BLE_SW_DCDC), U101.B2 (VSSP), U101.B4 (VSSA), U101.C12 (VSSAUDA), U101.E1 (BLE_VSS1), U101.K11 (VSS), U101.L10 (VDDUSB0P9), U101.M2 (BLE_AVSS_ANT), U101.N2 (BLE_AVSS_RF), U101.N9 (VDDUSB33), U101.N10 (VSSAUSB), U101.N11 (VDD18), U101.N12 (VSS18), U102.12 (GND1), U102.13 (GND2), U103.2 (GND), U104.2 (GND), U104.5 (DIR), U105.2 (GND), U105.5 (DIR), U106.1 (GND), Y102.2 (GND), Y102.4 (GND); also elsewhere on the board
PPG1_CS_N: U101.D9 (GPIO24)
PPG1_INT_N: U101.D8 (GPIO22)
PPG2_CS_N: U101.M5 (GPIO29)
PPG2_INT_N: U101.C8 (GPIO23)
PPG_SAMPLE_SYNC: U101.H13 (GPIO42)
PPG_SPI_MISO: U101.L7 (GPIO27)
PPG_SPI_MOSI: U101.L5 (GPIO26)
PPG_SPI_SCLK: U101.K5 (GPIO25)
VOUT1_1V8: C105.1, C106.1, C107.1, C108.1, C109.1, C110.1, C111.1, C112.1, C115.1, C116.1, C120.1, C122.1, C124.1, C126.1, R102.1, R104.1, R105.1, R109.1, U101.B1 (VDDP), U101.B12 (VDDAUDA), U101.B13 (VDDH), U101.C5 (VDDA), U101.C13 (VDDH2), U101.D1 (VDDH1), U101.E13 (BLE_VIO), U101.F1 (BLE_VCC), U101.G1 (BLE_VBAT2), U101.G10 (VDDH4), U101.H12 (VDDH3), U102.1 (VCCA), U102.2 (DIR1), U102.11 (DIR2), U103.1 (VCCA), U104.1 (VCCA), U105.1 (VCCA), U106.2 (VREF1); also elsewhere on the board

Notes on the sheet:
01_APOLLO510B — SYSTEM MCU / FINAL SIGNAL ALLOCATION — REV A
Selected ZC-A1D43W-046 module specifies 3.3V QSPI and touch I/O. Apollo GPIO rails are 1.8V here, so level translation is mandatory. Keep 03_DISPLAY R301/R302 DNP because U106 block provides high-side I2C pull-ups.
32.768kHz crystal is kept for accurate RTC/timekeeping; exact crystal + load caps are selected in BOM/footprint pass. 48MHz BLE crystal uses on-chip tuning; no external load caps shown.
DISPLAY + TOUCH LEVEL TRANSLATION — REQUIRED: APOLLO GPIO=1.8V, SELECTED MODULE I/O=3.3V
Native KiCad ERC must be run after final hierarchical export because child-sheet labels are not cross-sheet connections yet.
POWER / SIMO / CLOCK SUPPORT
BLE CONTROLLER — VOLTAGE MULTIPLIER MODE @ 1.8V
GPIO15/J5 is internally used as BLE reference clock and is NC. RESERVED balls H8/H9/J8/J9/M7/M8 are NC. USB data/MIPI pads are NC; unused USB/MIPI supply rails are grounded per Ambiq guidance.
BLE controller is voltage-multiplier mode: A7 BLE_SW_DCDC grounded; VIO/VBAT2/VCC=1.8V; A8 VBAT1 has 2.2uF. This avoids a second BLE DCDC inductor.
Wi-Fi uses MSPI0 GPIO64-73 plus GPIO199 CS; all on 1.8V VDDH3 domain. nRF7002 IOVDD is also 1.8V.
Display uses dedicated DISP_QSPI functions on GPIO100-104, GPIO83 reset, GPIO50 TE, GPIO99 CS (GPIO), GPIO98 VCI_EN. GPIO96 controls U103 OE; GPIO95 controls U102 OE.
U101 pin map = exact AP510BFA-CBR 153-ball package. Gray/unpopulated package positions are omitted; RESERVED balls and GPIO15 are explicitly NC.
All VDDP/VDDA/VDDH rails are 1.8V. VDDH1-4 are also 1.8V so every unshifted peripheral bus is 1.8V. SYS_3V3 is only used on the display/touch side of translators.
CO5300 command reads return on QSPI SIO0. U103 is TXB0101 auto-direction; 1.8V-side max data rate is 60Mbps versus CO5300 max 50MHz QSPI write clock / 10MHz read clock.
BLE_SW_DCDC is grounded in voltage-multiplier mode. BLE_VBAT2, BLE_VCC and BLE_VIO are all 1.8V; BLE_ENABLE E5 has the required ~10M pull-down.
R111 is the eMMC clock source terminator and belongs physically next to Apollo GPIO88; 22R is an initial SI value.
PIN MUX: eMMC reserves SDIF0 GPIO84-88 + GPIO156-160; do not reassign. R111 is at Apollo end of CLK.
C105=VDDP 10uF; C106=VDDA 1uF; C107=VDDH 2.2uF; C108=VDDH1 2.2uF; C109=VDDH2 2.2uF; C110=VDDH3 4.7uF; C111=VDDH4 100nF; C112=VDDAUDA 2.2uF.
