slimmpylk/Skoll_Ultra/sportwatch_revA.kicad_pcb

## KiCad design sportwatch_revA.kicad_pcb (continued)

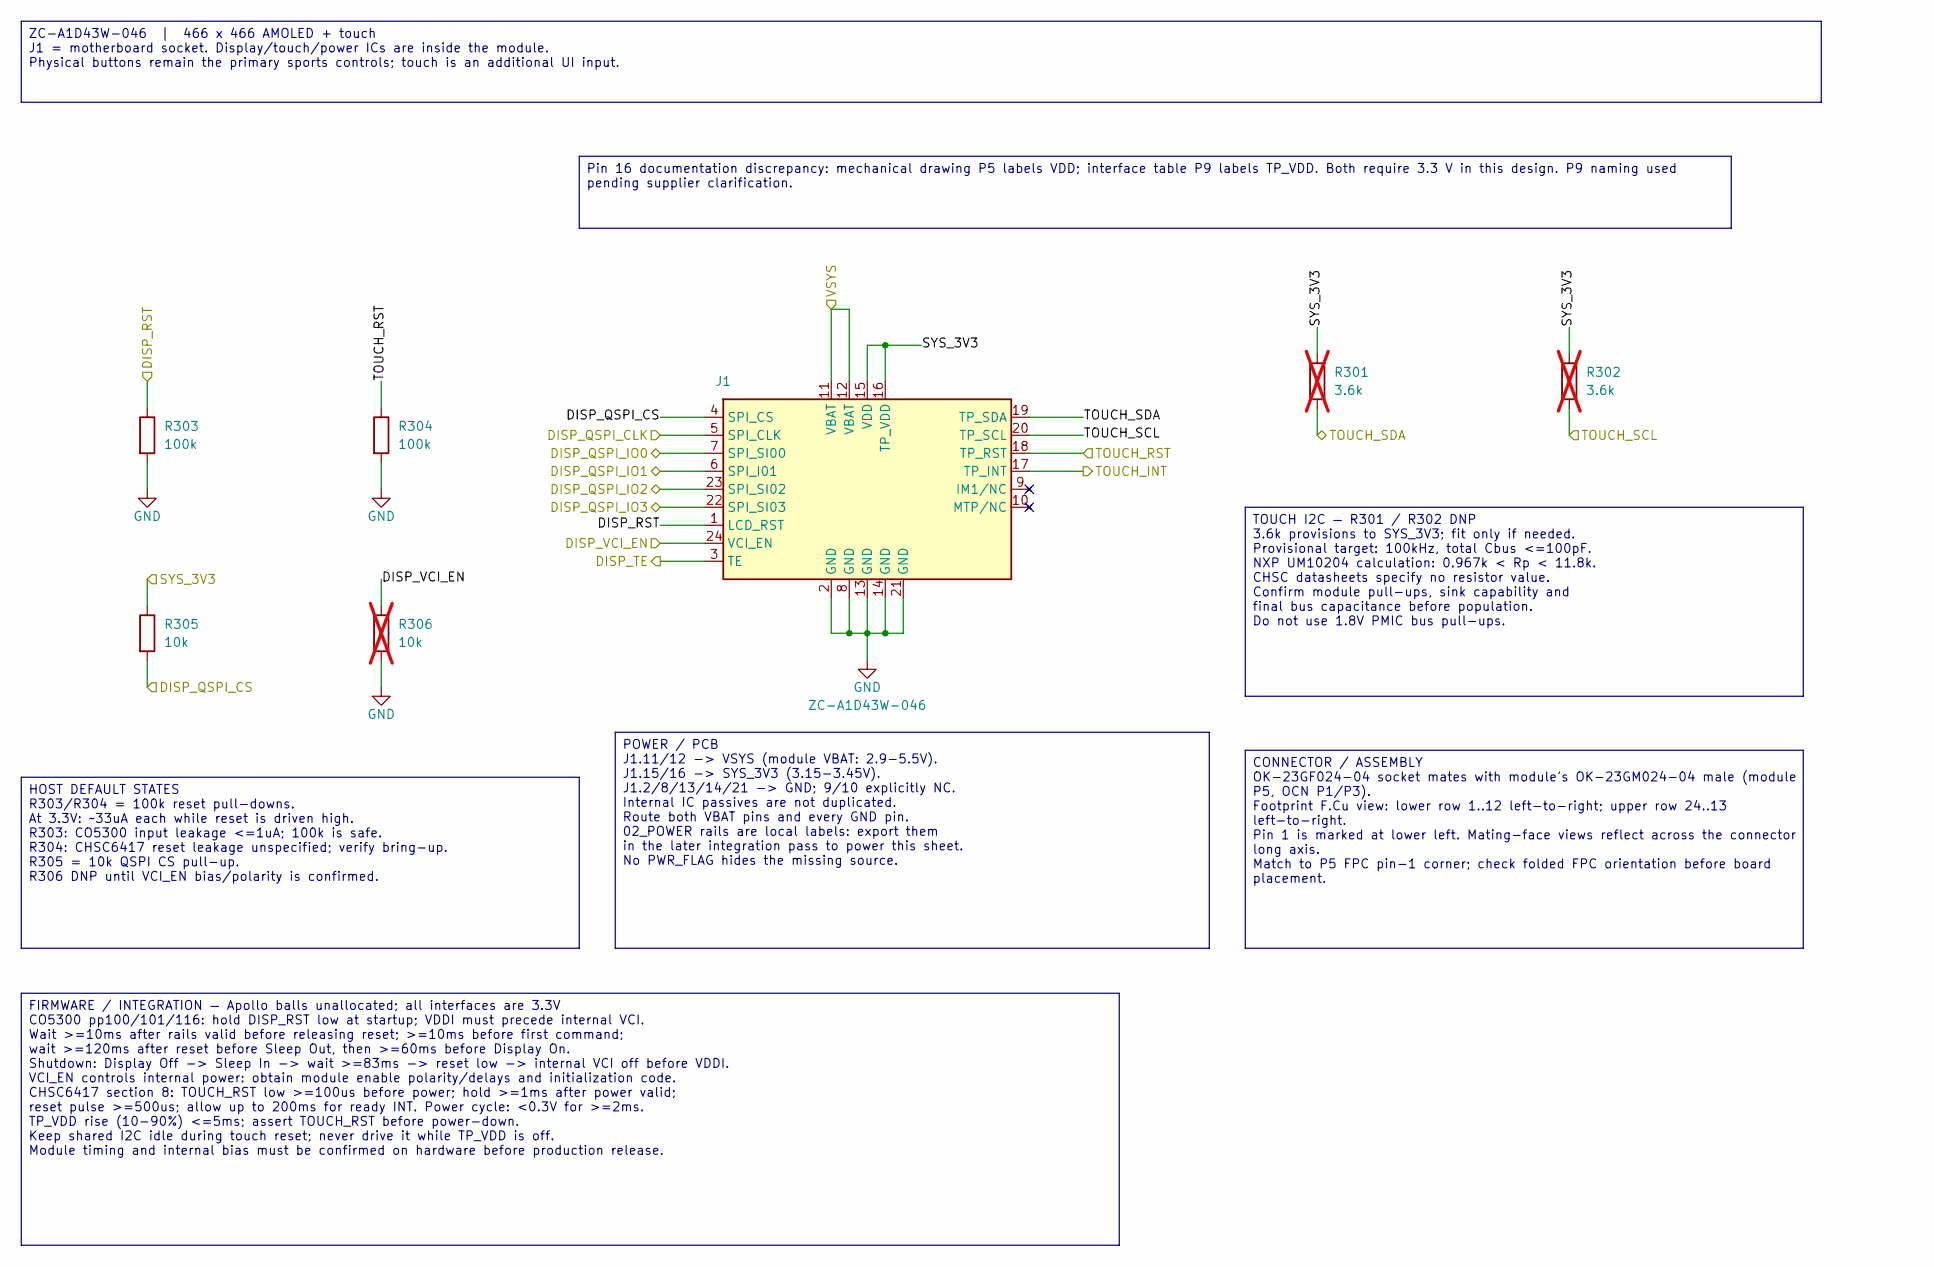
[picture p15: schematic 03_DISPLAY.kicad_sch, Rev-A — ZC-A1D43W-046 AMOLED / touch]

Parts:
J1: ZC-A1D43W-046; OK-23GF024-04; MPN OK-23GF024-04
R301, R302: 3.6k; R_0402_1005Metric; Tolerance 1%; Rating 0.063W, >=25V; not fitted
R303, R304: 100k; R_0402_1005Metric; Tolerance 1%; Rating 0.063W, >=25V
R305: 10k; R_0402_1005Metric; Tolerance 1%; Rating 0.063W, >=25V
R306: 10k; R_0402_1005Metric; Tolerance 1%; Rating 0.063W, >=25V; not fitted

Connections:
/DISP_QSPI_CLK: J1.5 (SPI_CLK); also elsewhere on the board
/DISP_QSPI_CS: J1.4 (SPI_CS), R305.2; also elsewhere on the board
/DISP_QSPI_IO0: J1.7 (SPI_SI00); also elsewhere on the board
/DISP_QSPI_IO1: J1.6 (SPI_I01); also elsewhere on the board
/DISP_QSPI_IO2: J1.23 (SPI_SI02); also elsewhere on the board
/DISP_QSPI_IO3: J1.22 (SPI_SI03); also elsewhere on the board
/DISP_RST: J1.1 (LCD_RST), R303.1; also elsewhere on the board
/DISP_TE: J1.3 (TE); also elsewhere on the board
/DISP_VCI_EN: J1.24 (VCI_EN), R306.1; also elsewhere on the board
/SYS_3V3: J1.15 (VDD), J1.16 (TP_VDD), R301.1, R302.1, R305.1; also elsewhere on the board
/TOUCH_INT: J1.17 (TP_INT); also elsewhere on the board
/TOUCH_RST: J1.18 (TP_RST), R304.1; also elsewhere on the board
/TOUCH_SCL: J1.20 (TP_SCL), R302.2; also elsewhere on the board
/TOUCH_SDA: J1.19 (TP_SDA), R301.2; also elsewhere on the board
/VSYS: J1.11 (VBAT), J1.12 (VBAT); also elsewhere on the board
GND: J1.2 (GND), J1.8 (GND), J1.13 (GND), J1.14 (GND), J1.21 (GND), R303.2, R304.2, R306.2; also elsewhere on the board

Notes on the sheet:
POWER / PCB J1.11/12 -> VSYS (module VBAT: 2.9-5.5V). J1.15/16 -> SYS_3V3 (3.15-3.45V). J1.2/8/13/14/21 -> GND; 9/10 explicitly NC. Internal IC passives are not duplicated. Route both VBAT pins and every GND pin. 02_POWER rails are local labels: export them in the later integration pass to power th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
CONNECTOR / ASSEMBLY OK-23GF024-04 socket mates with module's OK-23GM024-04 male (module P5, OCN P1/P3). Footprint F.Cu view: lower row 1..12 left-to-right; upper row 24..13 left-to-right. Pin 1 is marked at lower left. Mating-face views reflect across the connector long axis. Match to P5 FPC pin-1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
Pin 16 documentation discrepancy: mechanical drawing P5 labels VDD; interface table P9 labels TP_VDD. Both require 3.3 V in this design. P9 naming used pending supplier clarification.
ZC-A1D43W-046 | 466 x 466 AMOLED + touch J1 = motherboard socket. Display/touch/power ICs are inside the module. Physical buttons remain the primary sports controls; touch is an additional UI input.
TOUCH I2C — R301 / R302 DNP 3.6k provisions to SYS_3V3; fit only if needed. Provisional target: 100kHz, total Cbus <=100pF. NXP UM10204 calculation: 0.967k < Rp < 11.8k. CHSC datasheets specify no resistor value. Confirm module pull-ups, sink capability and final bus capacitance before population. 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
HOST DEFAULT STATES R303/R304 = 100k reset pull-downs. At 3.3V: ~33uA each while reset is driven high. R303: CO5300 input leakage <=1uA; 100k is safe. R304: CHSC6417 reset leakage unspecified; verify bring-up. R305 = 10k QSPI CS pull-up. R306 DNP until VCI_EN bias/polarity is confirmed.
FIRMWARE / INTEGRATION — Apollo balls unallocated; all interfaces are 3.3V CO5300 pp100/101/116: hold DISP_RST low at startup; VDDI must precede internal VCI. Wait >=10ms after rails valid before releasing reset; >=10ms before first command; wait >=120ms after reset before Sleep Out, then >=60ms be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

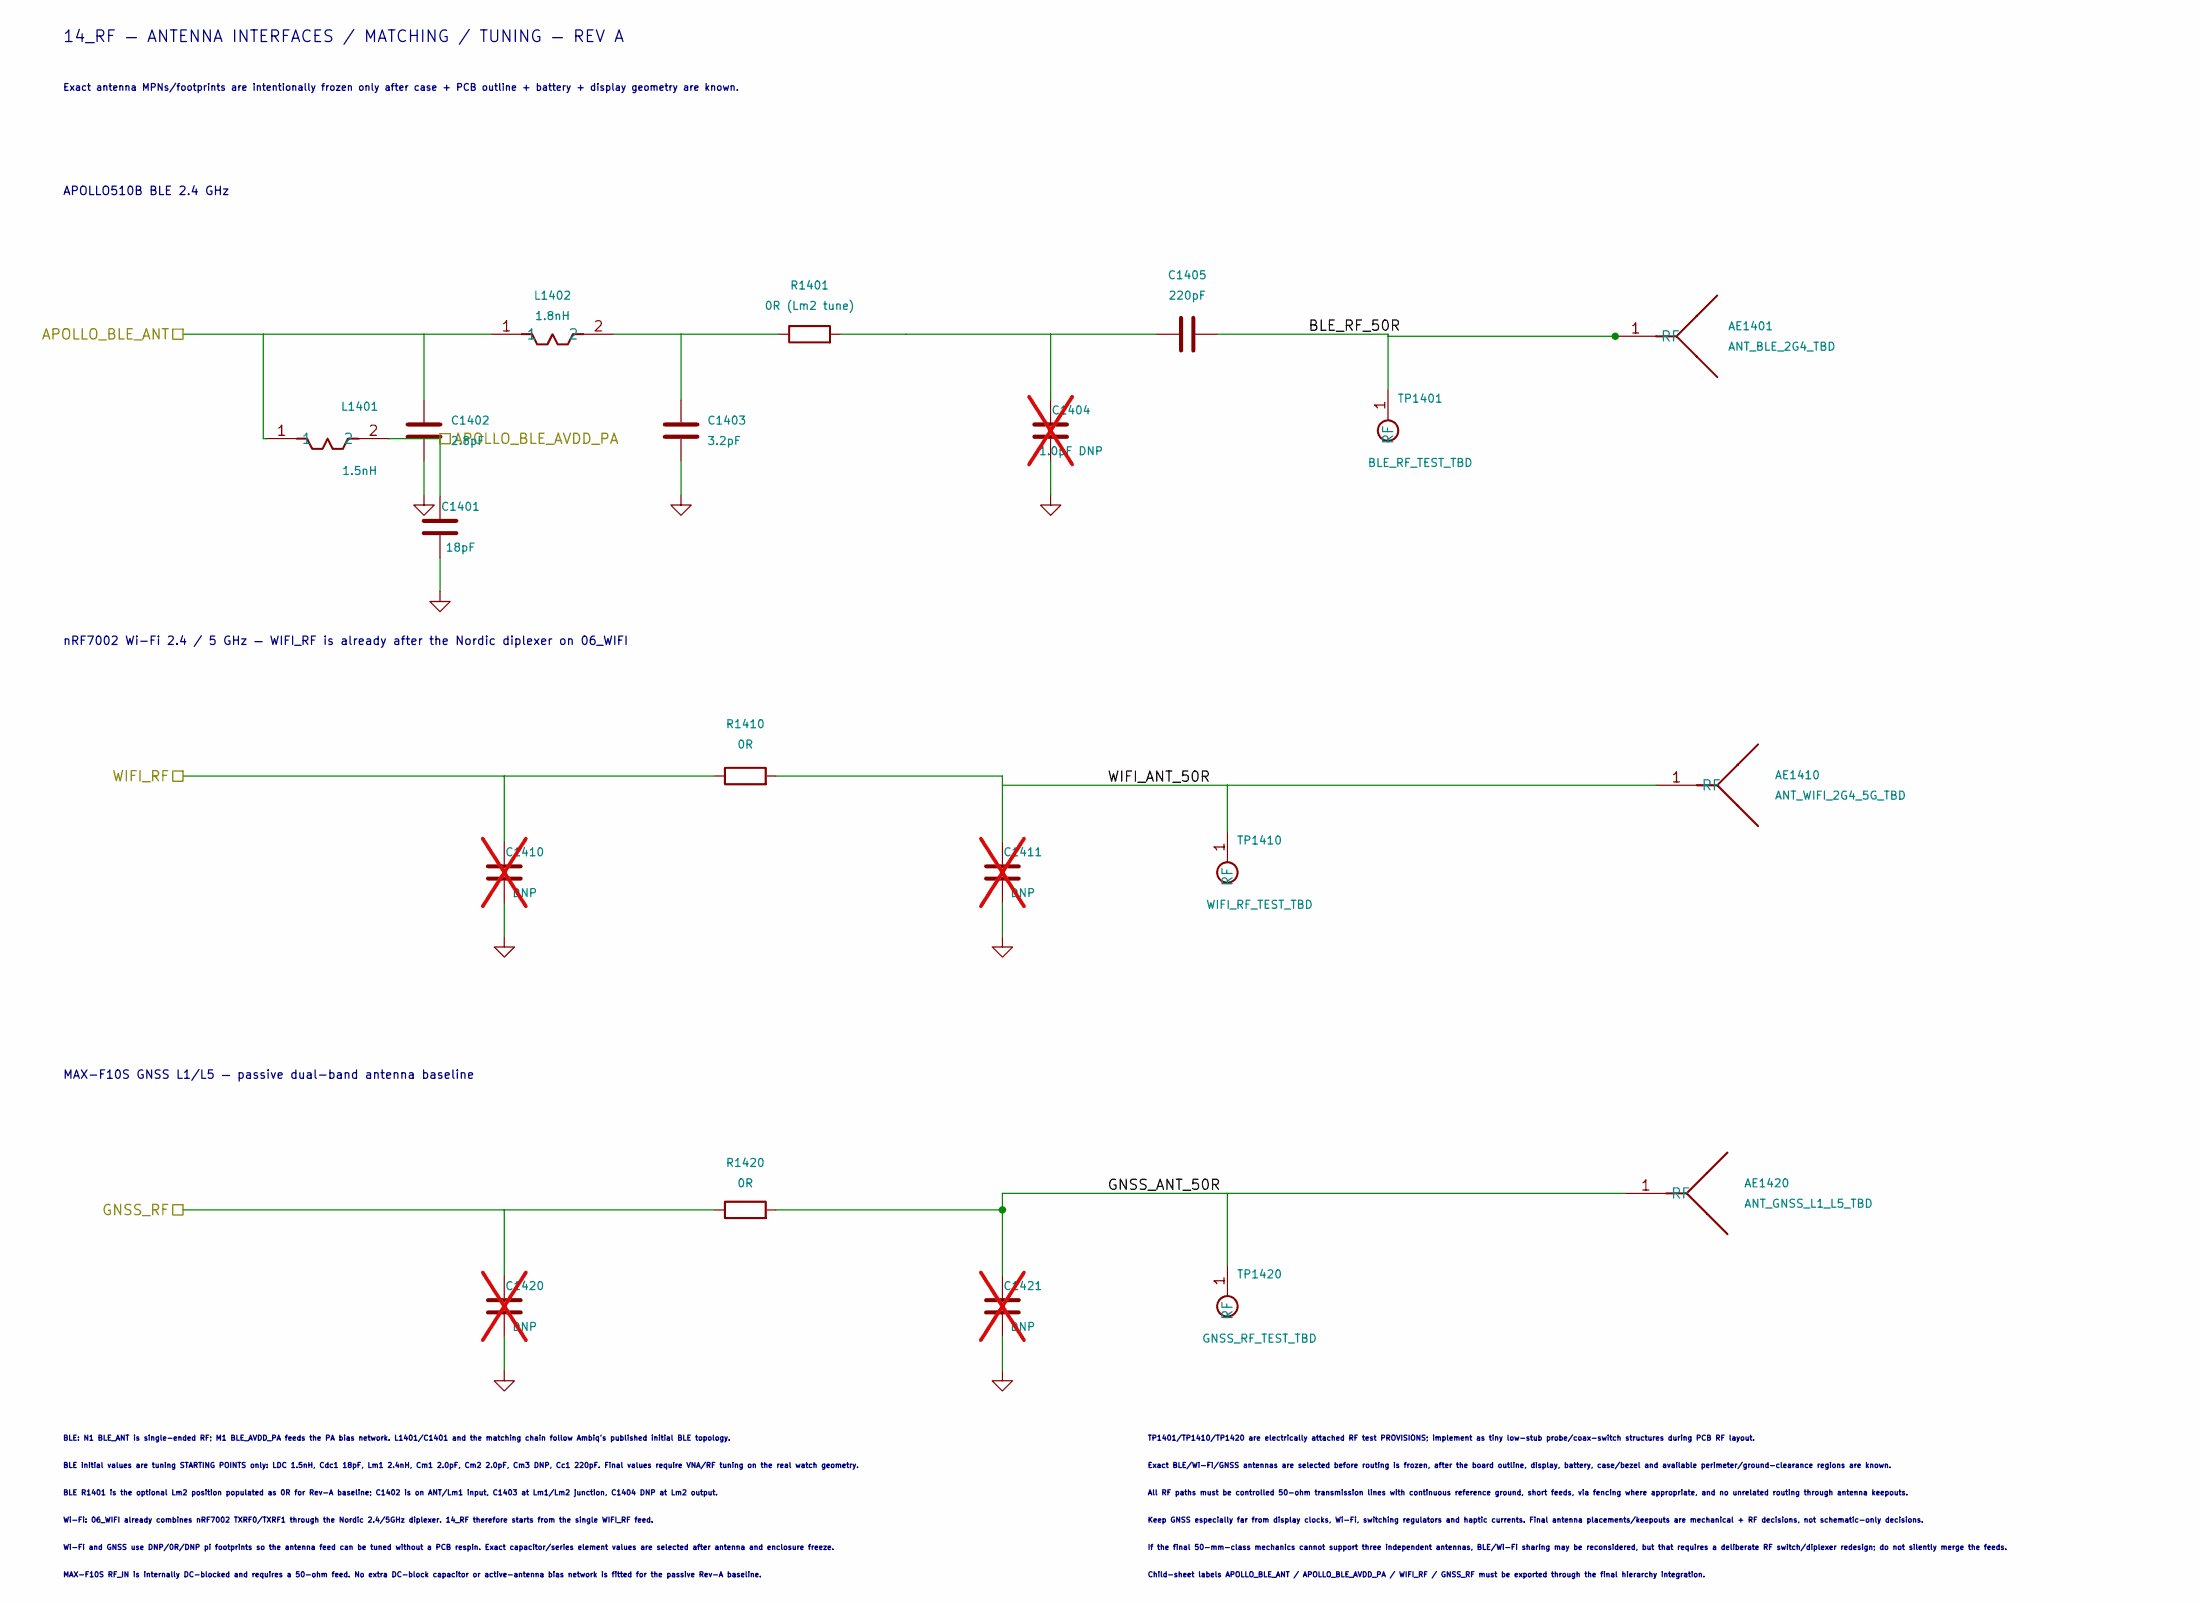
[picture p16: schematic 14_RF.kicad_sch, Rev-A — RF / Antenna Networks]

Parts:
AE1401: ANT_BLE_2G4_TBD
AE1410: ANT_WIFI_2G4_5G_TBD
AE1420: ANT_GNSS_L1_L5_TBD
C1401: 18pF; C_0201_0603Metric
C1402: 2.8pF; C_0201_0603Metric
C1403: 3.2pF; C_0201_0603Metric
C1404: 1.0pF DNP; C_0201_0603Metric; not fitted
C1405: 220pF; C_0201_0603Metric
C1410, C1411, C1420, C1421: DNP; C_0201_0603Metric; not fitted
L1401: 1.5nH; L_0201_0603Metric
L1402: 1.8nH; L_0201_0603Metric
R1401: 0R (Lm2 tune); R_0201_0603Metric
R1410, R1420: 0R; R_0201_0603Metric
TP1401: BLE_RF_TEST_TBD
TP1410: WIFI_RF_TEST_TBD
TP1420: GNSS_RF_TEST_TBD

Connections:
/14_RF/BLE_RF_50R: AE1401.1, C1405.2, TP1401.1
/14_RF/GNSS_ANT_50R: AE1420.1, C1421.1, R1420.2, TP1420.1
/14_RF/WIFI_ANT_50R: AE1410.1, C1411.1, R1410.2, TP1410.1
/APOLLO_BLE_ANT: C1402.1, L1401.1, L1402.1; also elsewhere on the board
/APOLLO_BLE_AVDD_PA: C1401.1, L1401.2; also elsewhere on the board
/GNSS_RF: C1420.1, R1420.1; also elsewhere on the board
/WIFI_RF: C1410.1, R1410.1
GND: C1401.2, C1402.2, C1403.2, C1404.2, C1410.2, C1411.2, C1420.2, C1421.2; also elsewhere on the board
unnamed: C1403.1, L1402.2, R1401.1
unnamed: C1404.1, C1405.1, R1401.2

Notes on the sheet:
If the final 50-mm-class mechanics cannot support three independent antennas, BLE/Wi-Fi sharing may be reconsidered, but that requires a deliberate RF switch/diplexer redesign; do not silently merge the feeds.
Exact BLE/Wi-Fi/GNSS antennas are selected before routing is frozen, after the board outline, display, battery, case/bezel and available perimeter/ground-clearance regions are known.
Child-sheet labels APOLLO_BLE_ANT / APOLLO_BLE_AVDD_PA / WIFI_RF / GNSS_RF must be exported through the final hierarchy integration.
TP1401/TP1410/TP1420 are electrically attached RF test PROVISIONS; implement as tiny low-stub probe/coax-switch structures during PCB RF layout.
All RF paths must be controlled 50-ohm transmission lines with continuous reference ground, short feeds, via fencing where appropriate, and no unrelated routing through antenna keepouts.
MAX-F10S RF_IN is internally DC-blocked and requires a 50-ohm feed. No extra DC-block capacitor or active-antenna bias network is fitted for the passive Rev-A baseline.
BLE initial values are tuning STARTING POINTS only: LDC 1.5nH, Cdc1 18pF, Lm1 2.4nH, Cm1 2.0pF, Cm2 2.0pF, Cm3 DNP, Cc1 220pF. Final values require VNA/RF tuning on the real watch geometry.
nRF7002 Wi-Fi 2.4 / 5 GHz — WIFI_RF is already after the Nordic diplexer on 06_WIFI
14_RF — ANTENNA INTERFACES / MATCHING / TUNING — REV A
APOLLO510B BLE 2.4 GHz
BLE R1401 is the optional Lm2 position populated as 0R for Rev-A baseline; C1402 is on ANT/Lm1 input, C1403 at Lm1/Lm2 junction, C1404 DNP at Lm2 output.
Wi-Fi and GNSS use DNP/0R/DNP pi footprints so the antenna feed can be tuned without a PCB respin. Exact capacitor/series element values are selected after antenna and enclosure freeze.
Wi-Fi: 06_WIFI already combines nRF7002 TXRF0/TXRF1 through the Nordic 2.4/5GHz diplexer. 14_RF therefore starts from the single WIFI_RF feed.
Exact antenna MPNs/footprints are intentionally frozen only after case + PCB outline + battery + display geometry are known.
BLE: N1 BLE_ANT is single-ended RF; M1 BLE_AVDD_PA feeds the PA bias network. L1401/C1401 and the matching chain follow Ambiq's published initial BLE topology.
MAX-F10S GNSS L1/L5 — passive dual-band antenna baseline
Keep GNSS especially far from display clocks, Wi-Fi, switching regulators and haptic currents. Final antenna placements/keepouts are mechanical + RF decisions, not schematic-only decisions.

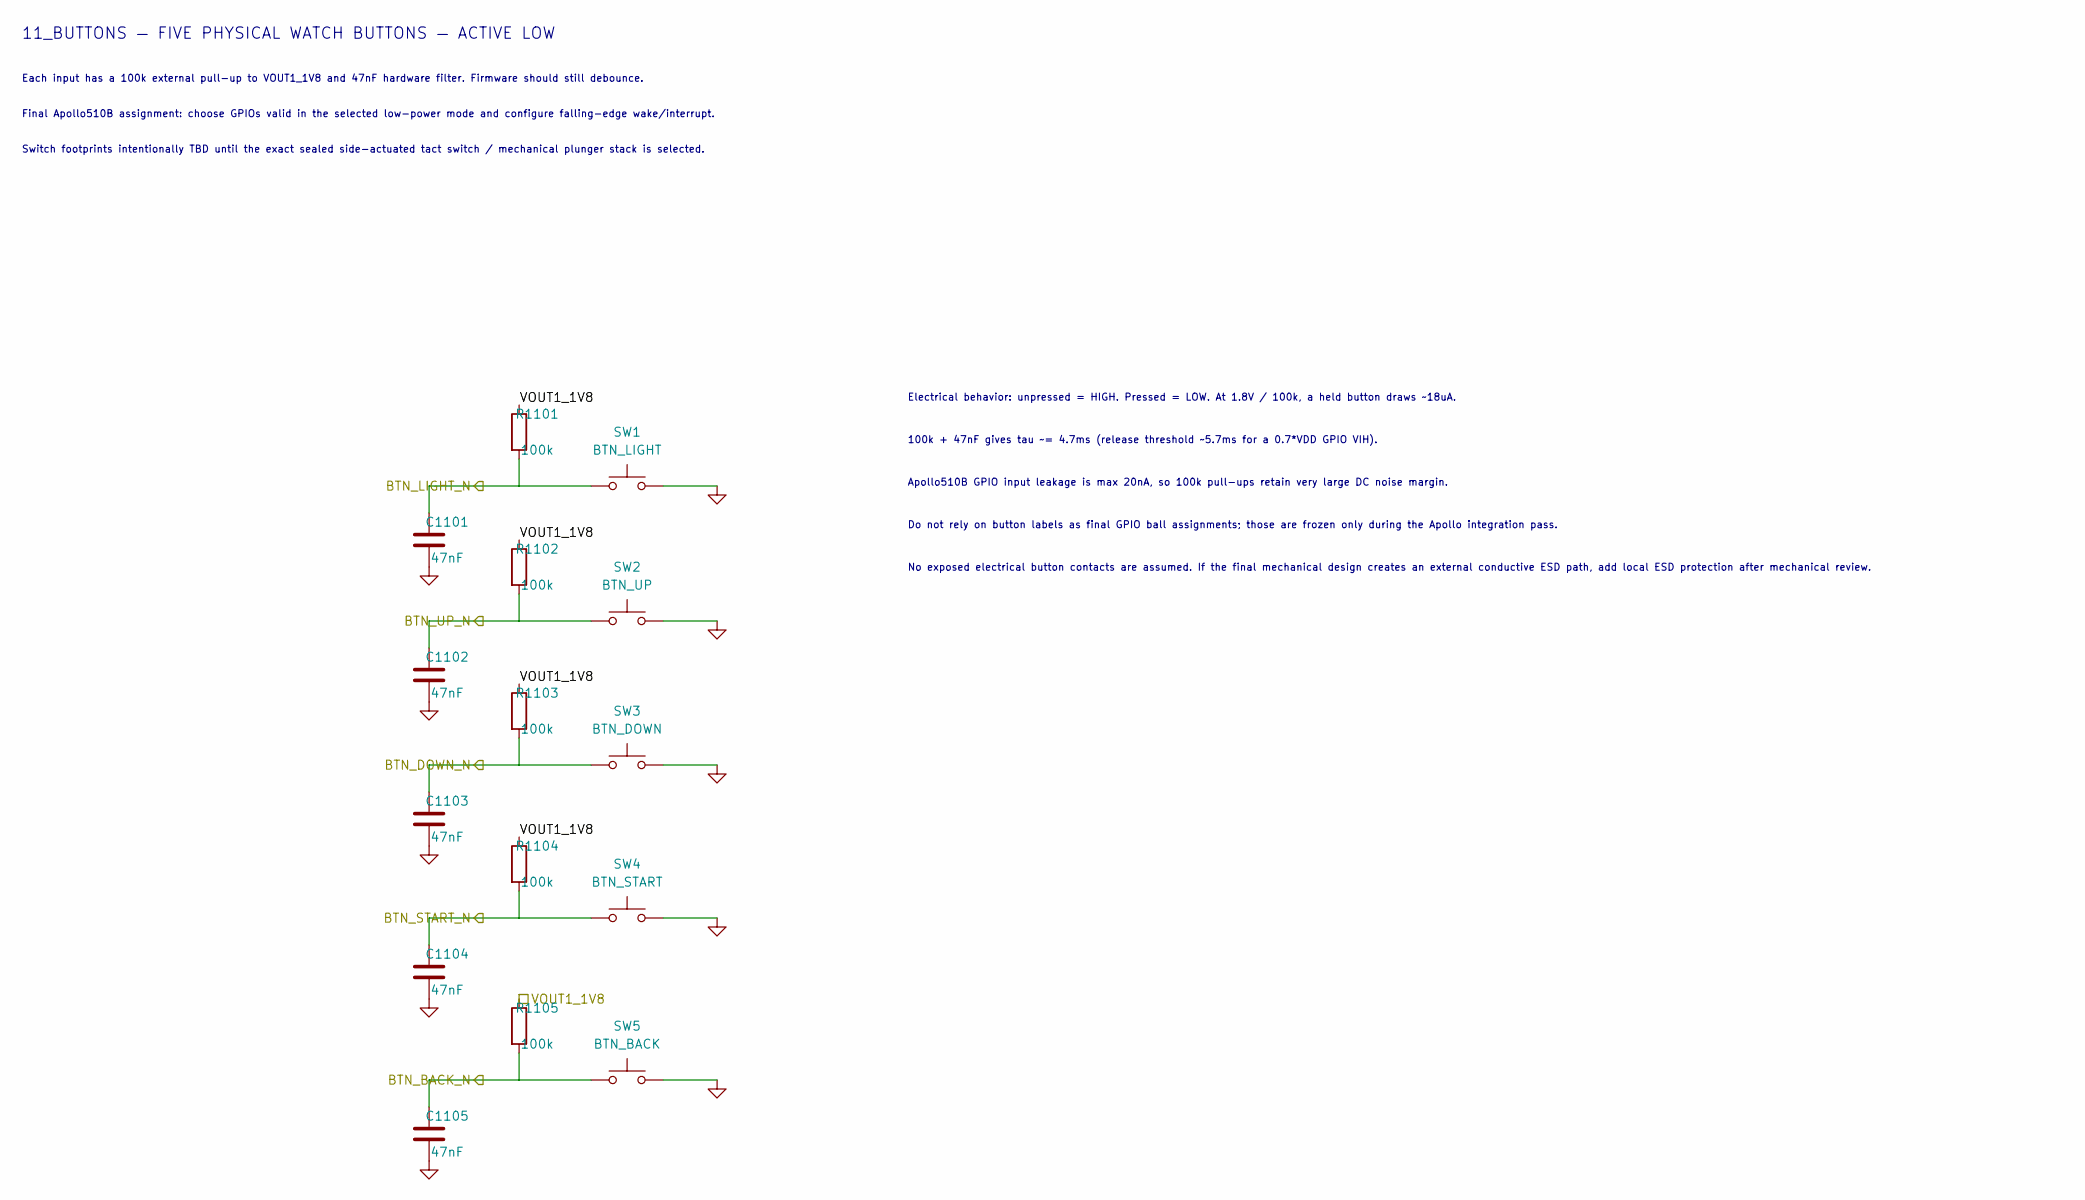
[picture p17: schematic 11_BUTTONS.kicad_sch, Rev-A — Physical buttons]

Parts:
C1101, C1102, C1103, C1104, C1105: 47nF; C_0402_1005Metric
R1101, R1102, R1103, R1104, R1105: 100k; R_0402_1005Metric
SW1: BTN_LIGHT
SW2: BTN_UP
SW3: BTN_DOWN
SW4: BTN_START
SW5: BTN_BACK

Connections:
/BTN_BACK_N: C1105.1, R1105.2, SW5.1; also elsewhere on the board
/BTN_DOWN_N: C1103.1, R1103.2, SW3.1; also elsewhere on the board
/BTN_LIGHT_N: C1101.1, R1101.2, SW1.1; also elsewhere on the board
/BTN_START_N: C1104.1, R1104.2, SW4.1; also elsewhere on the board
/BTN_UP_N: C1102.1, R1102.2, SW2.1; also elsewhere on the board
GND: C1101.2, C1102.2, C1103.2, C1104.2, C1105.2, SW1.2, SW2.2, SW3.2, SW4.2, SW5.2; also elsewhere on the board
VOUT1_1V8: R1101.1, R1102.1, R1103.1, R1104.1, R1105.1; also elsewhere on the board

Notes on the sheet:
Switch footprints intentionally TBD until the exact sealed side-actuated tact switch / mechanical plunger stack is selected.
Each input has a 100k external pull-up to VOUT1_1V8 and 47nF hardware filter. Firmware should still debounce.
Apollo510B GPIO input leakage is max 20nA, so 100k pull-ups retain very large DC noise margin.
Do not rely on button labels as final GPIO ball assignments; those are frozen only during the Apollo integration pass.
100k + 47nF gives tau ~= 4.7ms (release threshold ~5.7ms for a 0.7*VDD GPIO VIH).
11_BUTTONS — FIVE PHYSICAL WATCH BUTTONS — ACTIVE LOW
No exposed electrical button contacts are assumed. If the final mechanical design creates an external conductive ESD path, add local ESD protection after mechanical review.
Final Apollo510B assignment: choose GPIOs valid in the selected low-power mode and configure falling-edge wake/interrupt.
Electrical behavior: unpressed = HIGH. Pressed = LOW. At 1.8V / 100k, a held button draws ~18uA.

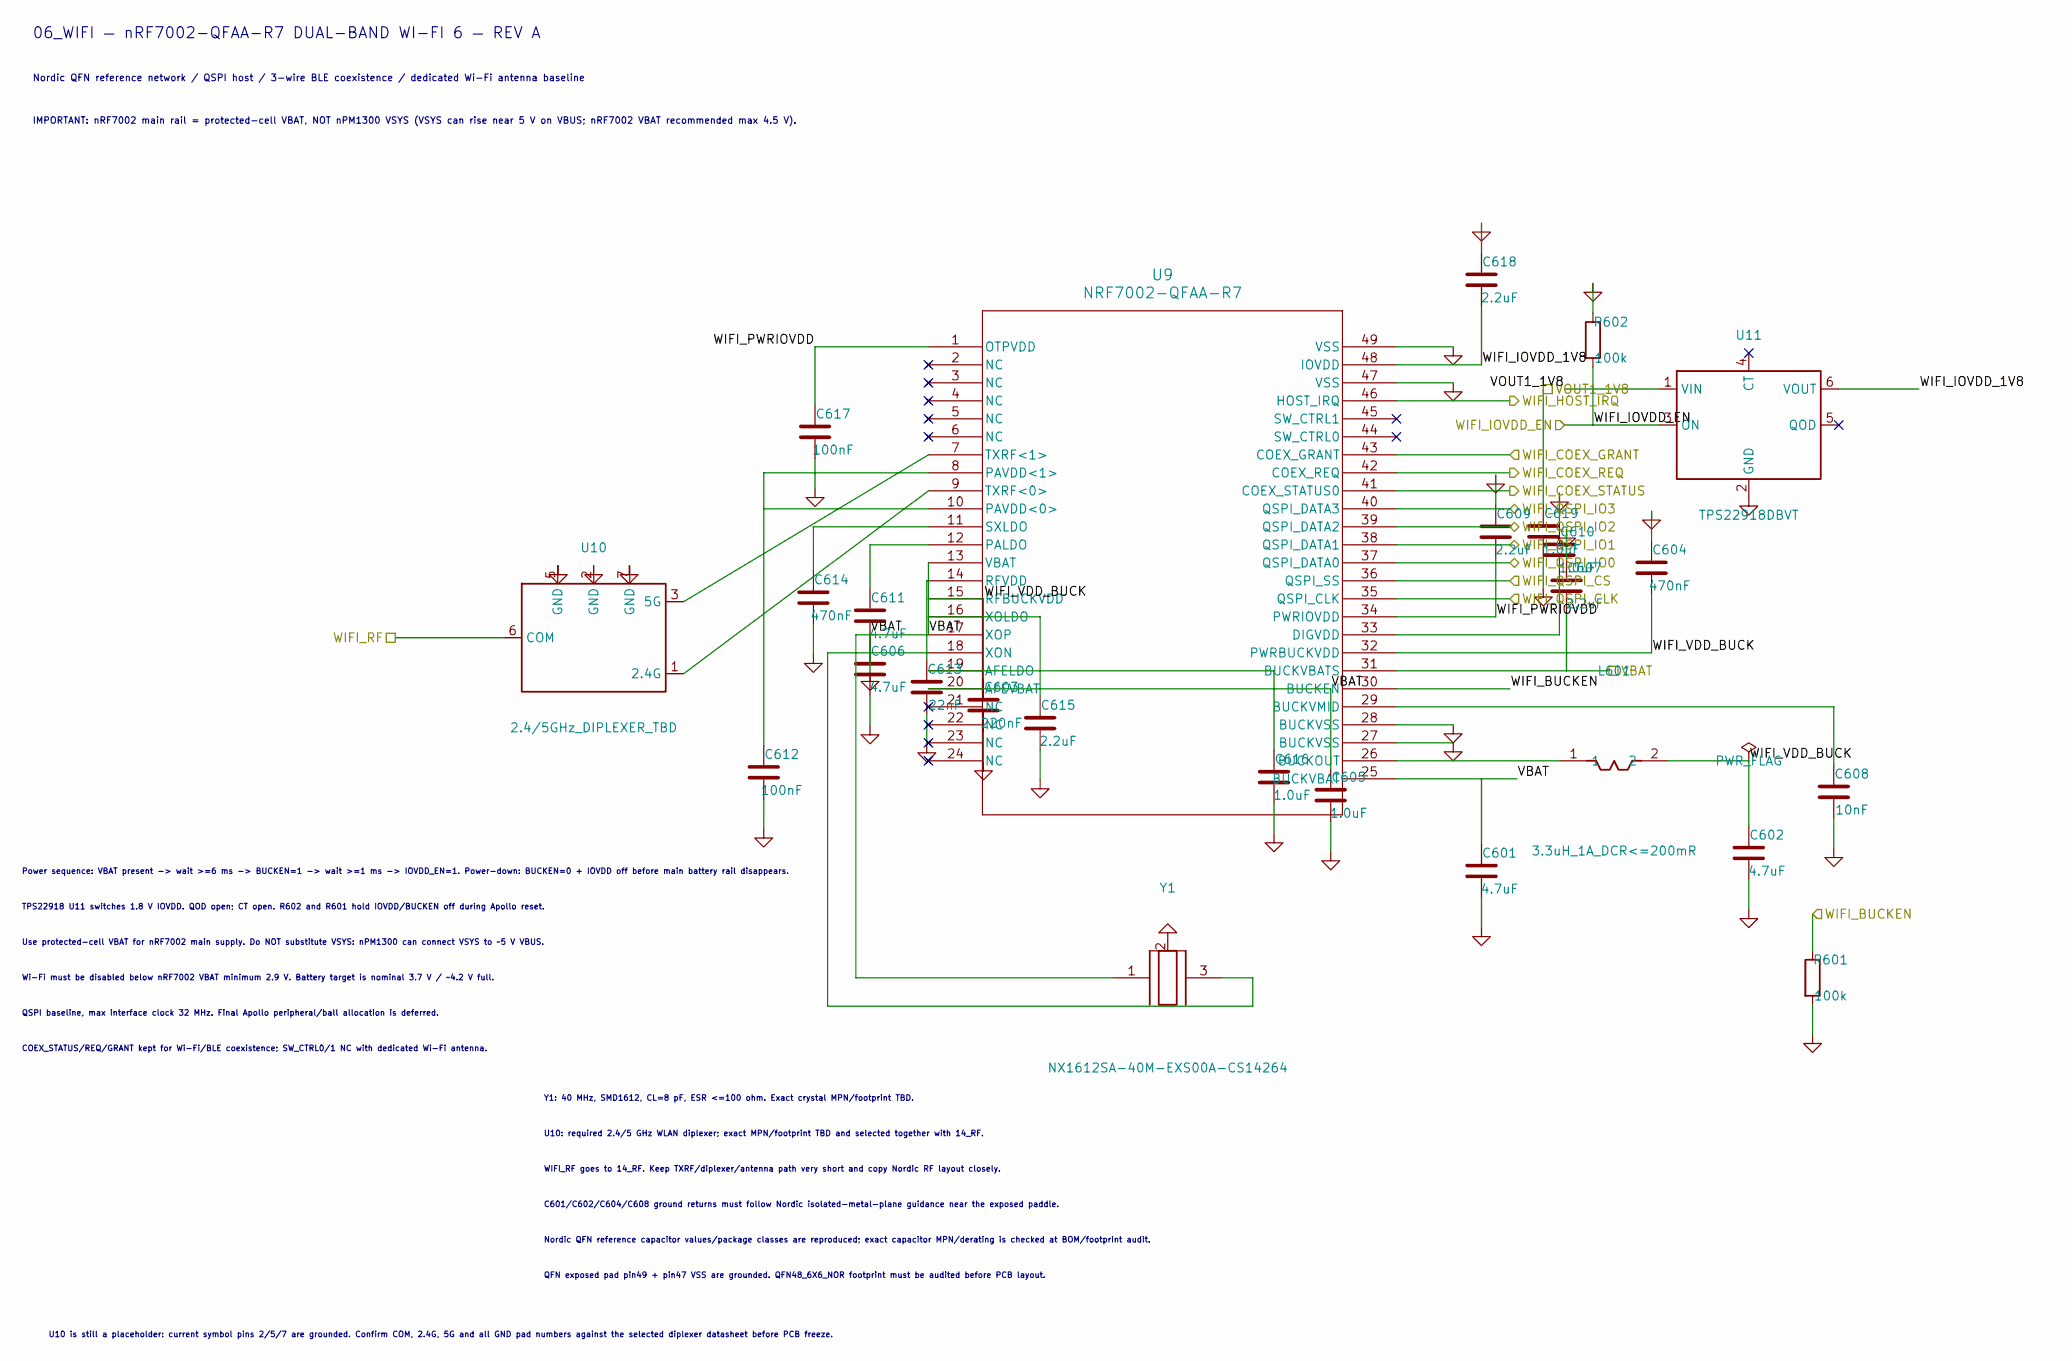
[picture p18: schematic 06_WIFI.kicad_sch, Rev-A — Wi-Fi]

Parts:
C601, C602, C606, C611: 4.7uF; C_0603_1608Metric
C603: 220nF; C_0201_0603Metric
C604, C614: 470nF; C_0201_0603Metric
C605, C610, C616, C619: 1.0uF; C_0402_1005Metric
C607, C618: 2.2uF; C_0603_1608Metric
C608: 10nF; C_0201_0603Metric
C609: 2.2uF; C_0402_1005Metric
C612, C617: 100nF; C_0201_0603Metric
C613: 22nF; C_0201_0603Metric
C615: 2.2uF; C_0201_0603Metric
L601: 3.3uH_1A_DCR<=200mR; L_2016_2016Metric
R601, R602: 100k; R_0402_1005Metric
U9: NRF7002-QFAA-R7; QFN48_6X6_NOR
U10: 2.4/5GHz_DIPLEXER_TBD
U11: TPS22918DBVT; SOT-23-6
Y1: NX1612SA-40M-EXS00A-CS14264; Crystal_1612-4Pin_1.6x1.2mm

Connections:
/06_WIFI/WIFI_IOVDD_1V8: C618.2, U9.48 (IOVDD), U11.6 (VOUT)
/06_WIFI/WIFI_PWRIOVDD: C609.2, C617.1, U9.1 (OTPVDD), U9.34 (PWRIOVDD)
/06_WIFI/WIFI_VDD_BUCK: C602.1, C603.1, C604.2, L601.2, U9.15 (RFBUCKVDD), U9.32 (PWRBUCKVDD)
/WIFI_BUCKEN: R601.1, U9.30 (BUCKEN); also elsewhere on the board
/WIFI_COEX_GRANT: U9.43 (COEX_GRANT); also elsewhere on the board
/WIFI_COEX_REQ: U9.42 (COEX_REQ); also elsewhere on the board
/WIFI_COEX_STATUS: U9.41 (COEX_STATUS0); also elsewhere on the board
/WIFI_HOST_IRQ: U9.46 (HOST_IRQ); also elsewhere on the board
/WIFI_IOVDD_EN: R602.2, U11.3 (ON); also elsewhere on the board
/WIFI_QSPI_CLK: U9.35 (QSPI_CLK); also elsewhere on the board
/WIFI_QSPI_CS: U9.36 (QSPI_SS); also elsewhere on the board
/WIFI_QSPI_IO0: U9.37 (QSPI_DATA0); also elsewhere on the board
/WIFI_QSPI_IO1: U9.38 (QSPI_DATA1); also elsewhere on the board
/WIFI_QSPI_IO2: U9.39 (QSPI_DATA2); also elsewhere on the board
/WIFI_QSPI_IO3: U9.40 (QSPI_DATA3); also elsewhere on the board
GND: C601.2, C602.2, C603.2, C604.1, C605.2, C606.2, C607.1, C608.2, C609.1, C610.1, C611.2, C612.2, C613.2, C614.2, C615.2, C616.2, C617.2, C618.1, C619.2, R601.2, R602.1, U9.27 (BUCKVSS), U9.28 (BUCKVSS), U9.47 (VSS), U9.49 (VSS), U10.2 (GND), U10.5 (GND), U10.7 (GND), U11.2 (GND), Y1.2 (GND), Y1.4 (GND); also elsewhere on the board
unnamed: C616.1, U9.19 (AFELDO)
unnamed: L601.1, U9.26 (BUCKOUT)
unnamed: C608.1, U9.29 (BUCKVMID)
unnamed: C610.2, U9.33 (DIGVDD)
unnamed: C611.1, U9.12 (PALDO)
unnamed: C612.1, U9.8 (PAVDD<1>), U9.10 (PAVDD<0>)
unnamed: C613.1, U9.14 (RFVDD)
unnamed: C614.1, U9.11 (SXLDO)
unnamed: C615.1, U9.16 (XOLDO)
unnamed: U9.18 (XON), Y1.3
unnamed: U9.17 (XOP), Y1.1
unnamed: U9.9 (TXRF<0>), U10.1 (2.4G)
unnamed: U9.7 (TXRF<1>), U10.3 (5G)
VBAT: C601.1, C605.1, C606.1, C607.2, U9.13 (VBAT), U9.20 (AFEVBAT), U9.25 (BUCKVBAT), U9.31 (BUCKVBATS); also elsewhere on the board
VOUT1_1V8: C619.1, U11.1 (VIN); also elsewhere on the board

Notes on the sheet:
QFN exposed pad pin49 + pin47 VSS are grounded. QFN48_6X6_NOR footprint must be audited before PCB layout.
U10: required 2.4/5 GHz WLAN diplexer; exact MPN/footprint TBD and selected together with 14_RF.
06_WIFI — nRF7002-QFAA-R7 DUAL-BAND WI-FI 6 — REV A
COEX_STATUS/REQ/GRANT kept for Wi-Fi/BLE coexistence; SW_CTRL0/1 NC with dedicated Wi-Fi antenna.
Nordic QFN reference capacitor values/package classes are reproduced; exact capacitor MPN/derating is checked at BOM/footprint audit.
IMPORTANT: nRF7002 main rail = protected-cell VBAT, NOT nPM1300 VSYS (VSYS can rise near 5 V on VBUS; nRF7002 VBAT recommended max 4.5 V).
WIFI_RF goes to 14_RF. Keep TXRF/diplexer/antenna path very short and copy Nordic RF layout closely.
C601/C602/C604/C608 ground returns must follow Nordic isolated-metal-plane guidance near the exposed paddle.
Use protected-cell VBAT for nRF7002 main supply. Do NOT substitute VSYS: nPM1300 can connect VSYS to ~5 V VBUS.
TPS22918 U11 switches 1.8 V IOVDD. QOD open; CT open. R602 and R601 hold IOVDD/BUCKEN off during Apollo reset.
Power sequence: VBAT present -> wait >=6 ms -> BUCKEN=1 -> wait >=1 ms -> IOVDD_EN=1. Power-down: BUCKEN=0 + IOVDD off before main battery rail disappears.
QSPI baseline, max interface clock 32 MHz. Final Apollo peripheral/ball allocation is deferred.
Wi-Fi must be disabled below nRF7002 VBAT minimum 2.9 V. Battery target is nominal 3.7 V / ~4.2 V full.
Nordic QFN reference network / QSPI host / 3-wire BLE coexistence / dedicated Wi-Fi antenna baseline
Y1: 40 MHz, SMD1612, CL=8 pF, ESR <=100 ohm. Exact crystal MPN/footprint TBD.
U10 is still a placeholder: current symbol pins 2/5/7 are grounded. Confirm COM, 2.4G, 5G and all GND pad numbers against the selected diplexer datasheet before PCB freeze.
