slimmpylk/Skoll_Ultra/sportwatch_revA.kicad_pcb

## KiCad design sportwatch_revA.kicad_pcb (continued)

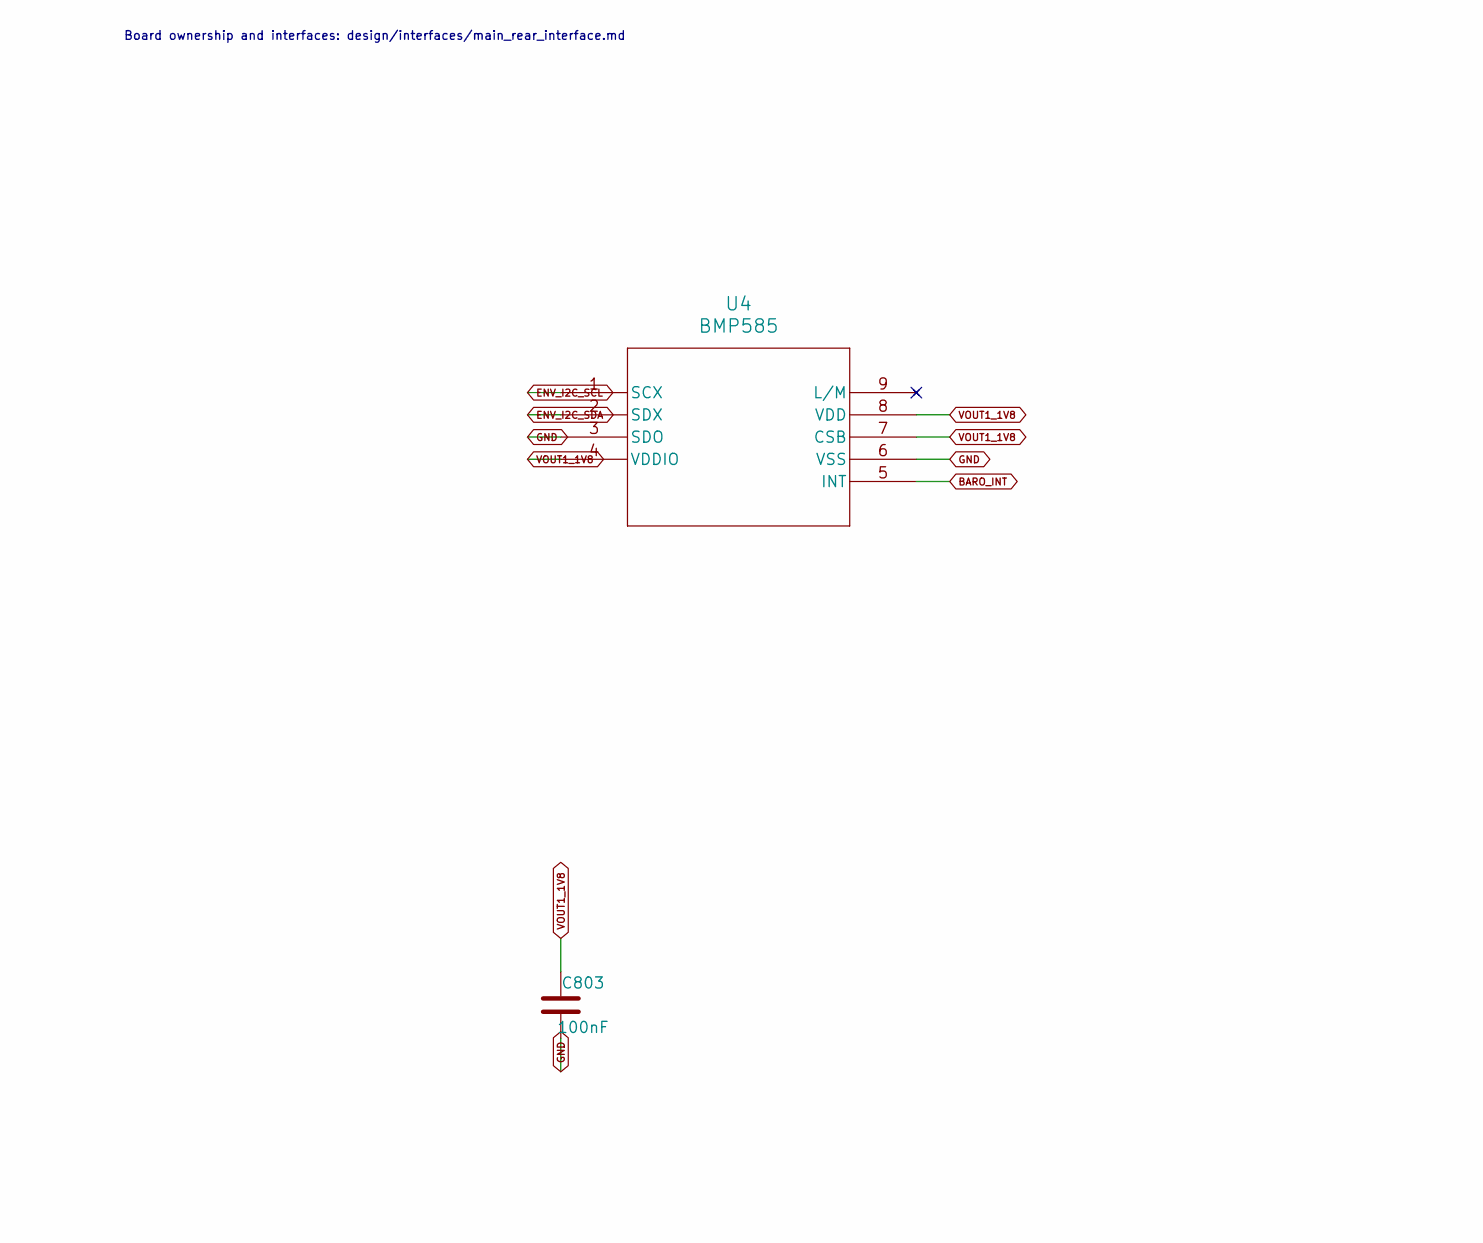
[picture p19: schematic 08_ENVIRONMENT.kicad_sch, MAIN - BMP585 / OPT4001 / ENV I2C pull-ups, part in row 1, column 1]

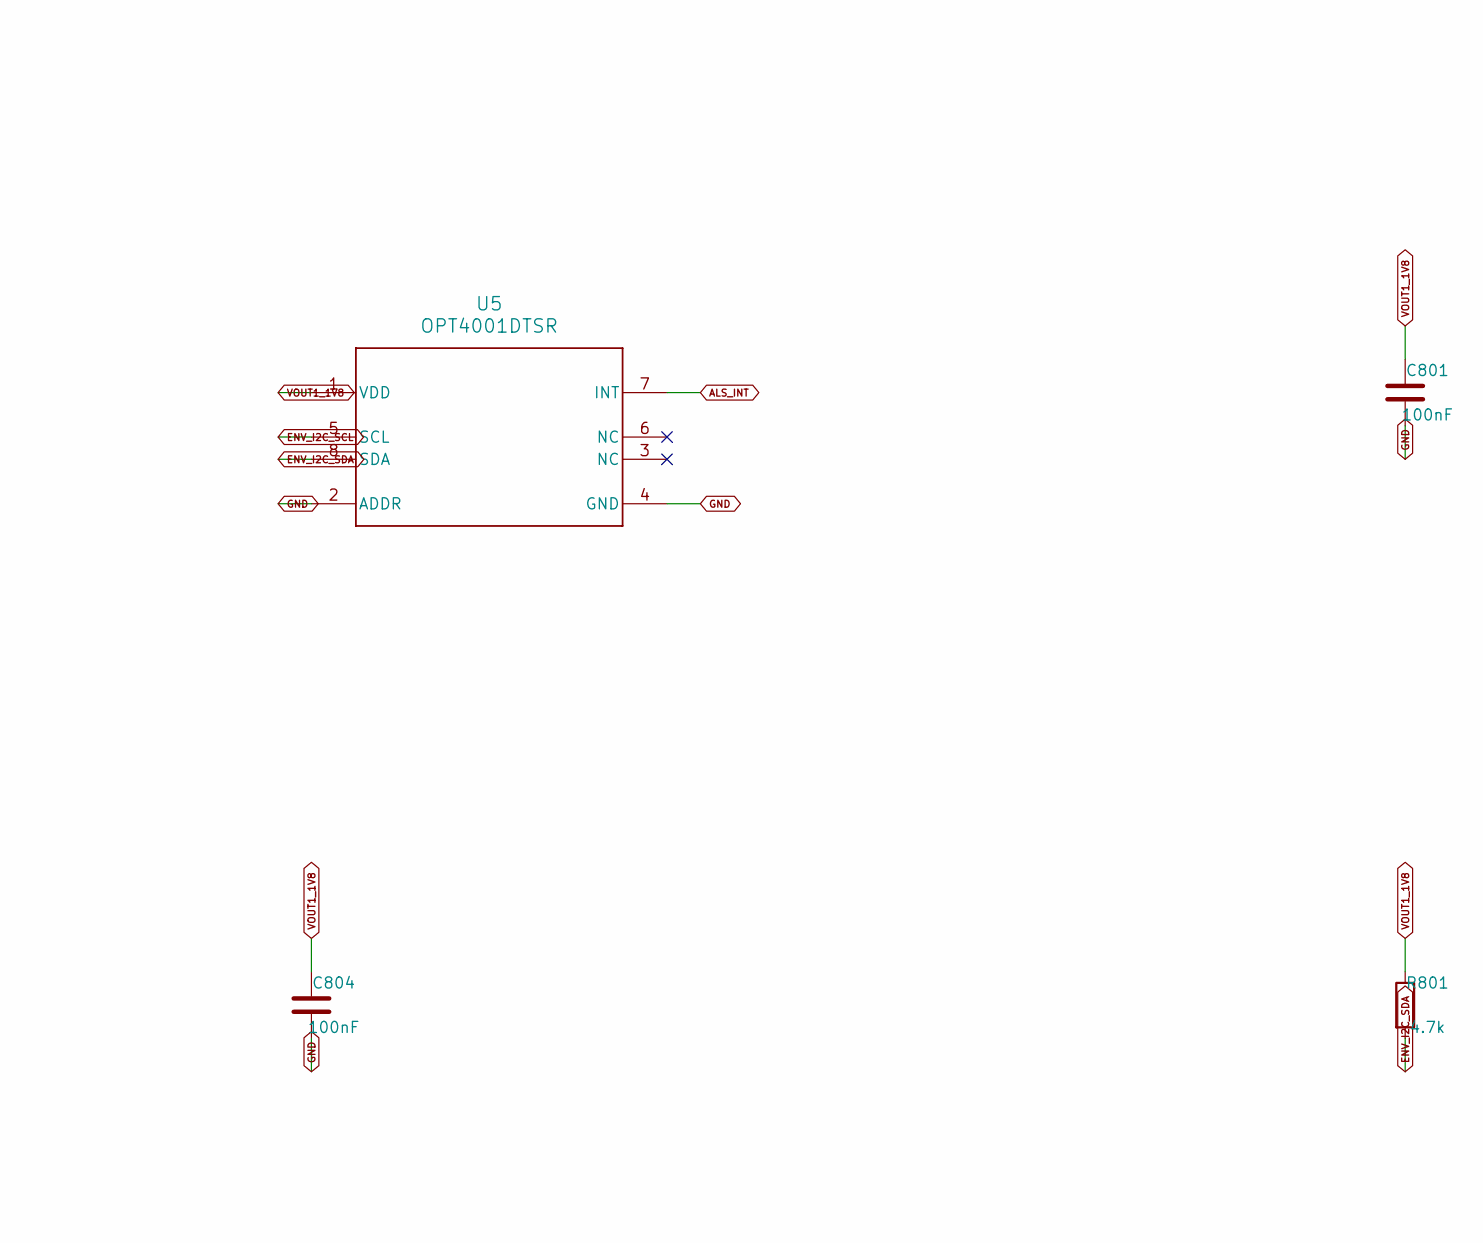
[picture p20: schematic 08_ENVIRONMENT.kicad_sch, MAIN - BMP585 / OPT4001 / ENV I2C pull-ups, part in row 1, column 2]

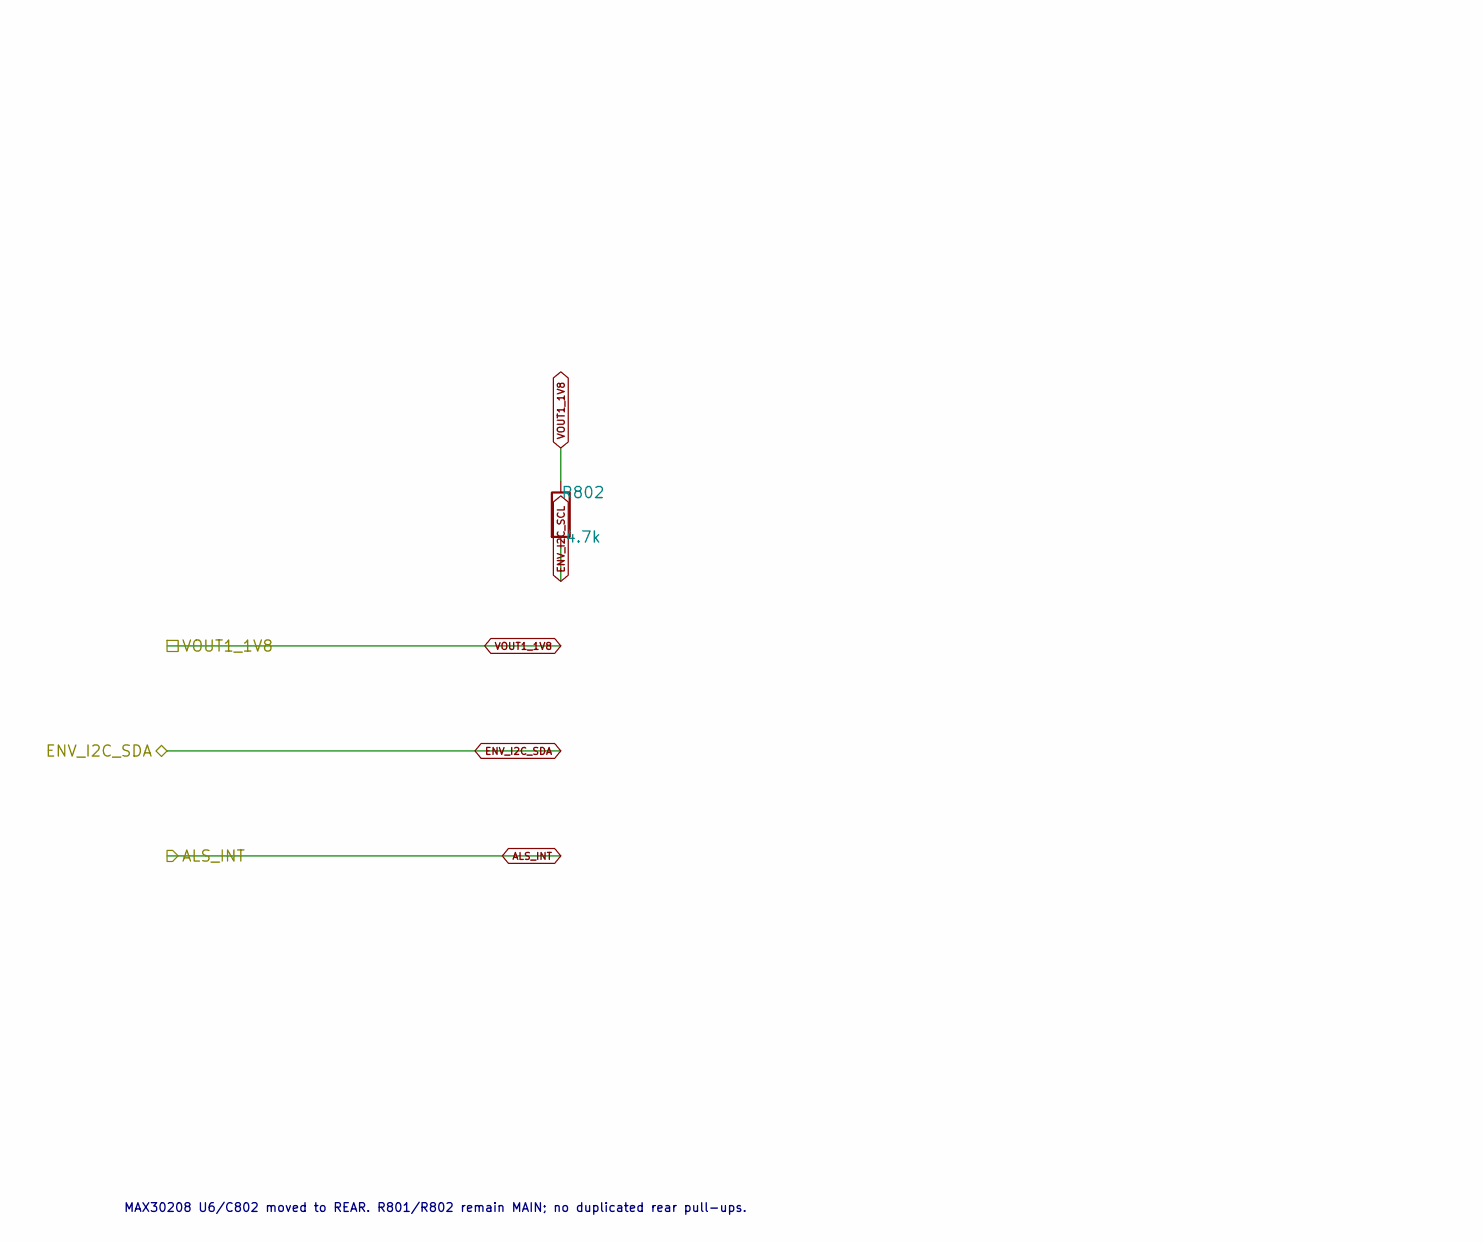
[picture p21: schematic 08_ENVIRONMENT.kicad_sch, MAIN - BMP585 / OPT4001 / ENV I2C pull-ups, part in row 2, column 1]

Parts:
C801, C803, C804: 100nF; C_0402_1005Metric
R801, R802: 4.7k; R_0402_1005Metric
R803: 10k; R_0402_1005Metric
U4: BMP585; LGA9_BMP585_BOS
U5: OPT4001DTSR; DTS0008A-MFG

Connections:
ALS_INT: R803.2, U5.7 (INT); also elsewhere on the board
BARO_INT: U4.5 (INT); also elsewhere on the board
ENV_I2C_SCL: R802.2, U4.1 (SCX), U5.5 (SCL); also elsewhere on the board
ENV_I2C_SDA: R801.2, U4.2 (SDX), U5.8 (SDA); also elsewhere on the board
GND: C801.2, C803.2, C804.2, U4.3 (SDO), U4.6 (VSS), U5.2 (ADDR), U5.4 (GND); also elsewhere on the board
VOUT1_1V8: C801.1, C803.1, C804.1, R801.1, R802.1, R803.1, U4.4 (VDDIO), U4.7 (CSB), U4.8 (VDD), U5.1 (VDD); also elsewhere on the board

Notes on the sheet:
Board ownership and interfaces: design/interfaces/main_rear_interface.md
MAX30208 U6/C802 moved to REAR. R801/R802 remain MAIN; no duplicated rear pull-ups.

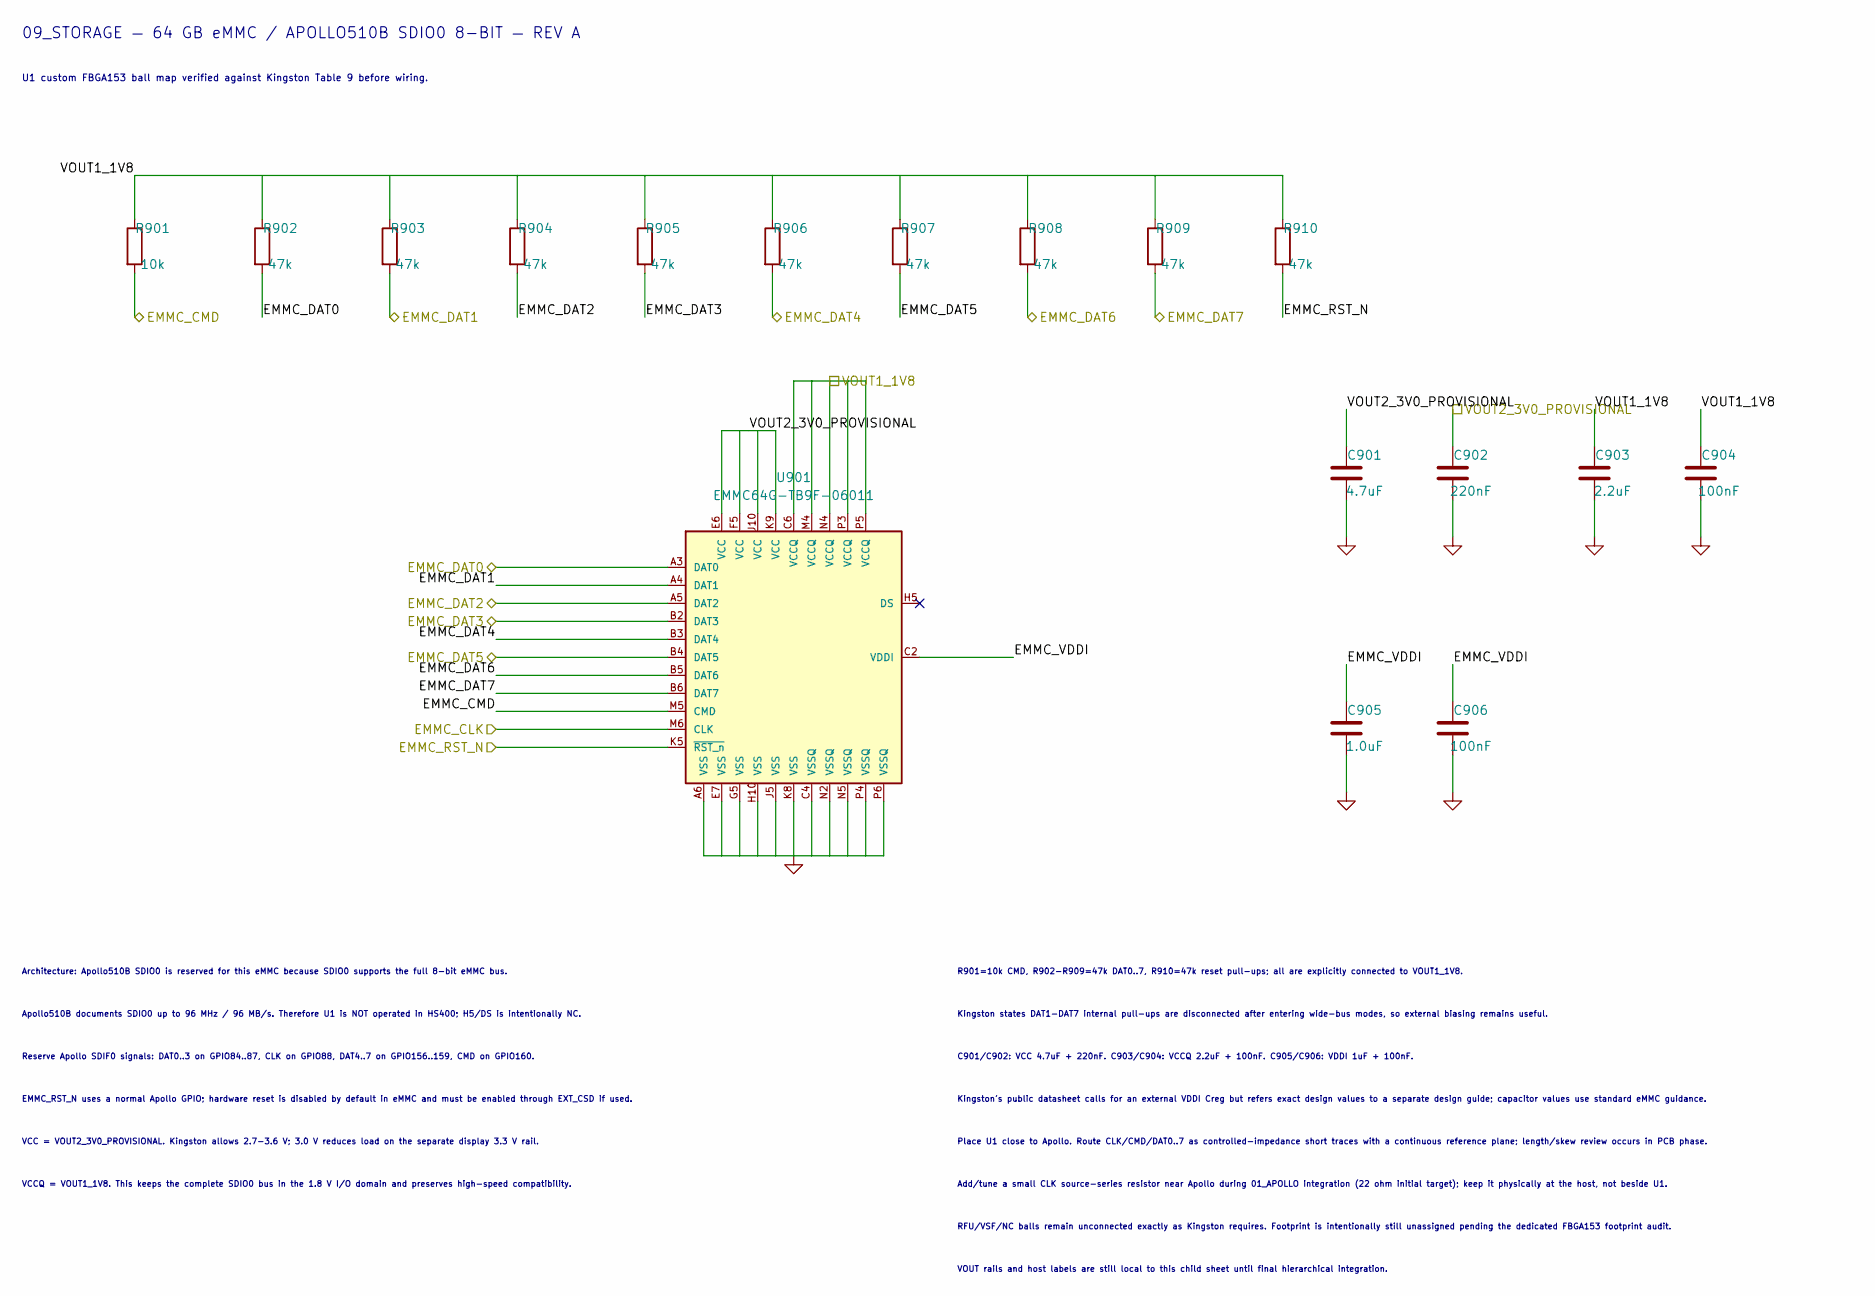
[picture p22: schematic 09_STORAGE.kicad_sch, Rev-A — 64 GB eMMC Storage]

Parts:
C901: 4.7uF; C_0603_1608Metric
C902: 220nF; C_0402_1005Metric
C903: 2.2uF; C_0603_1608Metric
C904, C906: 100nF; C_0402_1005Metric
C905: 1.0uF; C_0402_1005Metric
R901: 10k; R_0402_1005Metric
R902, R903, R904, R905, R906, R907, R908, R909, R910: 47k; R_0402_1005Metric
U901: EMMC64G-TB9F-06011; FBGA-153_8.0x8.5mm_Layout14x14_P0.5mm

Connections:
/09_STORAGE/EMMC_VDDI: C905.1, C906.1, U901.C2 (VDDI)
/EMMC_CLK: U901.M6 (CLK); also elsewhere on the board
/EMMC_CMD: R901.2, U901.M5 (CMD); also elsewhere on the board
/EMMC_DAT0: R902.2, U901.A3 (DAT0); also elsewhere on the board
/EMMC_DAT1: R903.2, U901.A4 (DAT1); also elsewhere on the board
/EMMC_DAT2: R904.2, U901.A5 (DAT2); also elsewhere on the board
/EMMC_DAT3: R905.2, U901.B2 (DAT3); also elsewhere on the board
/EMMC_DAT4: R906.2, U901.B3 (DAT4); also elsewhere on the board
/EMMC_DAT5: R907.2, U901.B4 (DAT5); also elsewhere on the board
/EMMC_DAT6: R908.2, U901.B5 (DAT6); also elsewhere on the board
/EMMC_DAT7: R909.2, U901.B6 (DAT7); also elsewhere on the board
/EMMC_RST_N: R910.2, U901.K5 (~RST_n); also elsewhere on the board
/VOUT2_3V0_PROVISIONAL: C901.1, C902.1, U901.E6 (VCC), U901.F5 (VCC), U901.J10 (VCC), U901.K9 (VCC); also elsewhere on the board
GND: C901.2, C902.2, C903.2, C904.2, C905.2, C906.2, U901.A6 (VSS), U901.C4 (VSSQ), U901.E7 (VSS), U901.G5 (VSS), U901.H10 (VSS), U901.J5 (VSS), U901.K8 (VSS), U901.N2 (VSSQ), U901.N5 (VSSQ), U901.P4 (VSSQ), U901.P6 (VSSQ); also elsewhere on the board
VOUT1_1V8: C903.1, C904.1, R901.1, R902.1, R903.1, R904.1, R905.1, R906.1, R907.1, R908.1, R909.1, R910.1, U901.C6 (VCCQ), U901.M4 (VCCQ), U901.N4 (VCCQ), U901.P3 (VCCQ), U901.P5 (VCCQ); also elsewhere on the board

Notes on the sheet:
RFU/VSF/NC balls remain unconnected exactly as Kingston requires. Footprint is intentionally still unassigned pending the dedicated FBGA153 footprint audit.
Kingston states DAT1-DAT7 internal pull-ups are disconnected after entering wide-bus modes, so external biasing remains useful.
Kingston's public datasheet calls for an external VDDI Creg but refers exact design values to a separate design guide; capacitor values use standard eMMC guidance.
09_STORAGE — 64 GB eMMC / APOLLO510B SDIO0 8-BIT — REV A
Architecture: Apollo510B SDIO0 is reserved for this eMMC because SDIO0 supports the full 8-bit eMMC bus.
EMMC_RST_N uses a normal Apollo GPIO; hardware reset is disabled by default in eMMC and must be enabled through EXT_CSD if used.
Add/tune a small CLK source-series resistor near Apollo during 01_APOLLO integration (22 ohm initial target); keep it physically at the host, not beside U1.
Apollo510B documents SDIO0 up to 96 MHz / 96 MB/s. Therefore U1 is NOT operated in HS400; H5/DS is intentionally NC.
Place U1 close to Apollo. Route CLK/CMD/DAT0..7 as controlled-impedance short traces with a continuous reference plane; length/skew review occurs in PCB phase.
U1 custom FBGA153 ball map verified against Kingston Table 9 before wiring.
VCC = VOUT2_3V0_PROVISIONAL. Kingston allows 2.7-3.6 V; 3.0 V reduces load on the separate display 3.3 V rail.
C901/C902: VCC 4.7uF + 220nF. C903/C904: VCCQ 2.2uF + 100nF. C905/C906: VDDI 1uF + 100nF.
Reserve Apollo SDIF0 signals: DAT0..3 on GPIO84..87, CLK on GPIO88, DAT4..7 on GPIO156..159, CMD on GPIO160.
VCCQ = VOUT1_1V8. This keeps the complete SDIO0 bus in the 1.8 V I/O domain and preserves high-speed compatibility.
R901=10k CMD, R902-R909=47k DAT0..7, R910=47k reset pull-ups; all are explicitly connected to VOUT1_1V8.
VOUT rails and host labels are still local to this child sheet until final hierarchical integration.

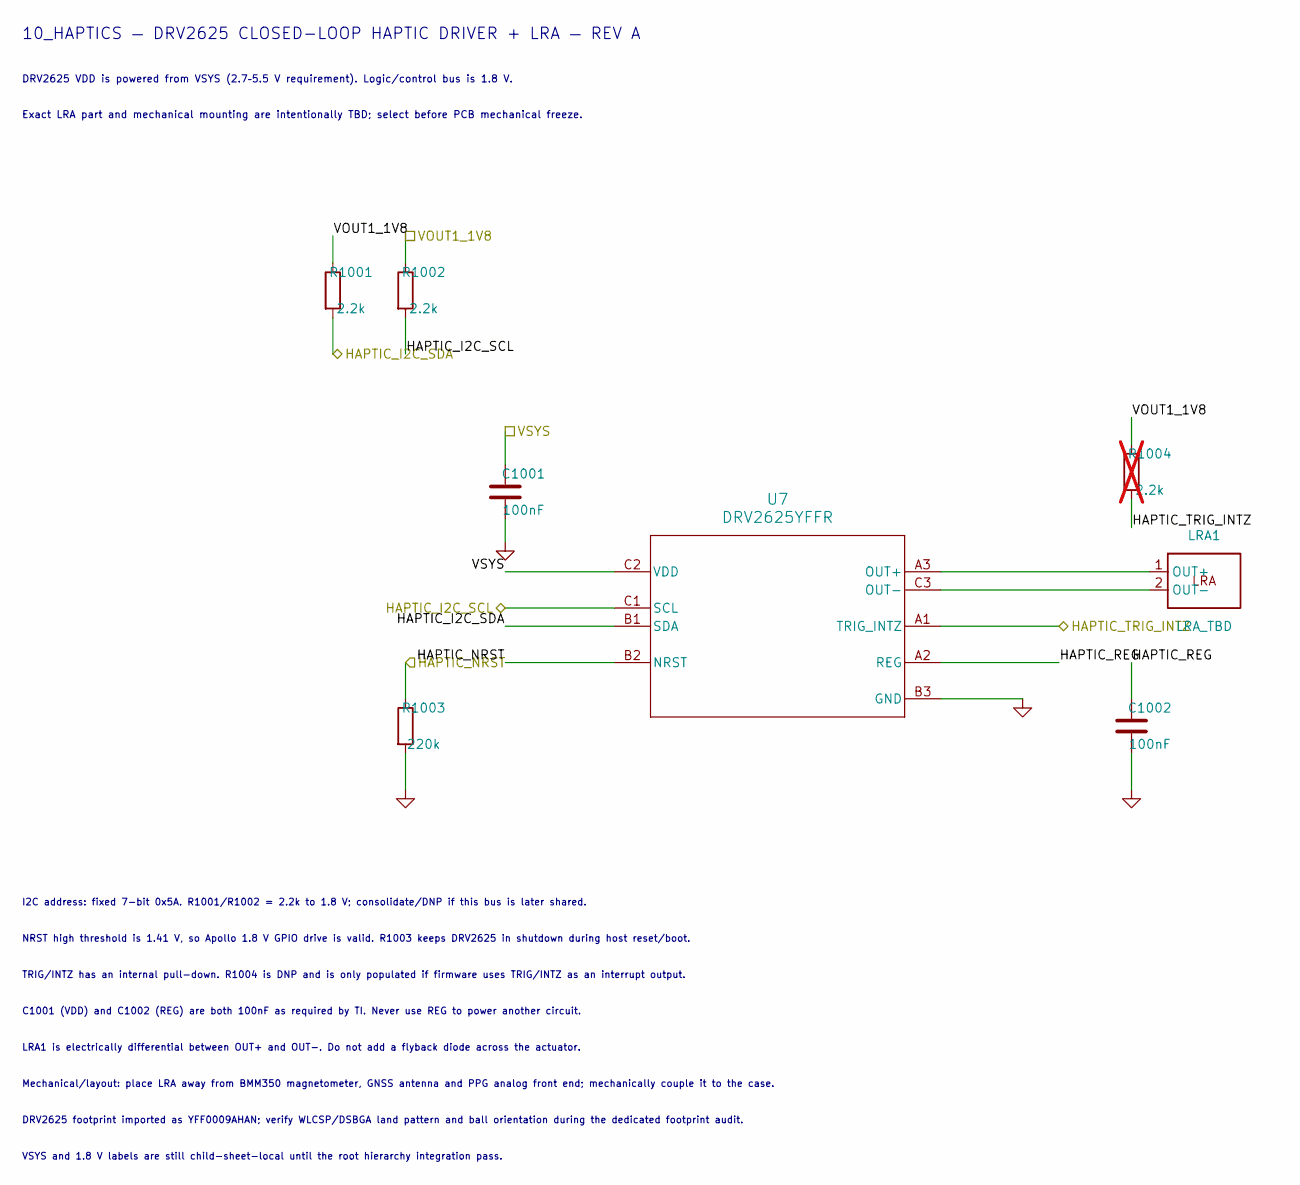
[picture p23: schematic 10_HAPTICS.kicad_sch, Rev-A — Haptic driver]

Parts:
C1001, C1002: 100nF; C_0402_1005Metric
LRA1: LRA_TBD
R1001, R1002: 2.2k; R_0402_1005Metric
R1003: 220k; R_0402_1005Metric
R1004: 2.2k; R_0402_1005Metric; not fitted
U7: DRV2625YFFR; YFF0009AHAN

Connections:
/10_HAPTICS/HAPTIC_REG: C1002.1, U7.A2 (REG)
/HAPTIC_I2C_SCL: R1002.2, U7.C1 (SCL); also elsewhere on the board
/HAPTIC_I2C_SDA: R1001.2, U7.B1 (SDA); also elsewhere on the board
/HAPTIC_NRST: R1003.1, U7.B2 (NRST); also elsewhere on the board
/HAPTIC_TRIG_INTZ: R1004.2, U7.A1 (TRIG_INTZ); also elsewhere on the board
/VSYS: C1001.1, U7.C2 (VDD); also elsewhere on the board
GND: C1001.2, C1002.2, R1003.2, U7.B3 (GND); also elsewhere on the board
unnamed: LRA1.1 (OUT+), U7.A3 (OUT+)
unnamed: LRA1.2 (OUT-), U7.C3 (OUT-)
VOUT1_1V8: R1001.1, R1002.1, R1004.1; also elsewhere on the board

Notes on the sheet:
I2C address: fixed 7-bit 0x5A. R1001/R1002 = 2.2k to 1.8 V; consolidate/DNP if this bus is later shared.
TRIG/INTZ has an internal pull-down. R1004 is DNP and is only populated if firmware uses TRIG/INTZ as an interrupt output.
DRV2625 footprint imported as YFF0009AHAN; verify WLCSP/DSBGA land pattern and ball orientation during the dedicated footprint audit.
10_HAPTICS — DRV2625 CLOSED-LOOP HAPTIC DRIVER + LRA — REV A
VSYS and 1.8 V labels are still child-sheet-local until the root hierarchy integration pass.
NRST high threshold is 1.41 V, so Apollo 1.8 V GPIO drive is valid. R1003 keeps DRV2625 in shutdown during host reset/boot.
Exact LRA part and mechanical mounting are intentionally TBD; select before PCB mechanical freeze.
Mechanical/layout: place LRA away from BMM350 magnetometer, GNSS antenna and PPG analog front end; mechanically couple it to the case.
C1001 (VDD) and C1002 (REG) are both 100nF as required by TI. Never use REG to power another circuit.
LRA1 is electrically differential between OUT+ and OUT-. Do not add a flyback diode across the actuator.
DRV2625 VDD is powered from VSYS (2.7–5.5 V requirement). Logic/control bus is 1.8 V.

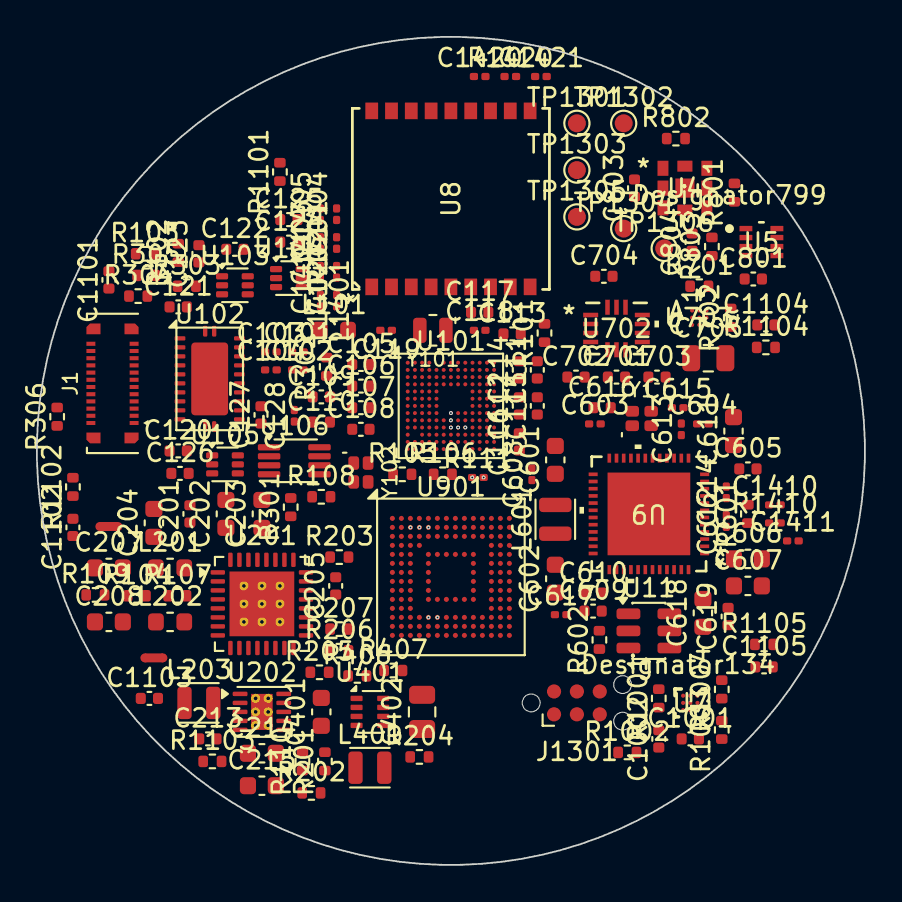
[picture p24: board sportwatch_revA.kicad_pcb from above]

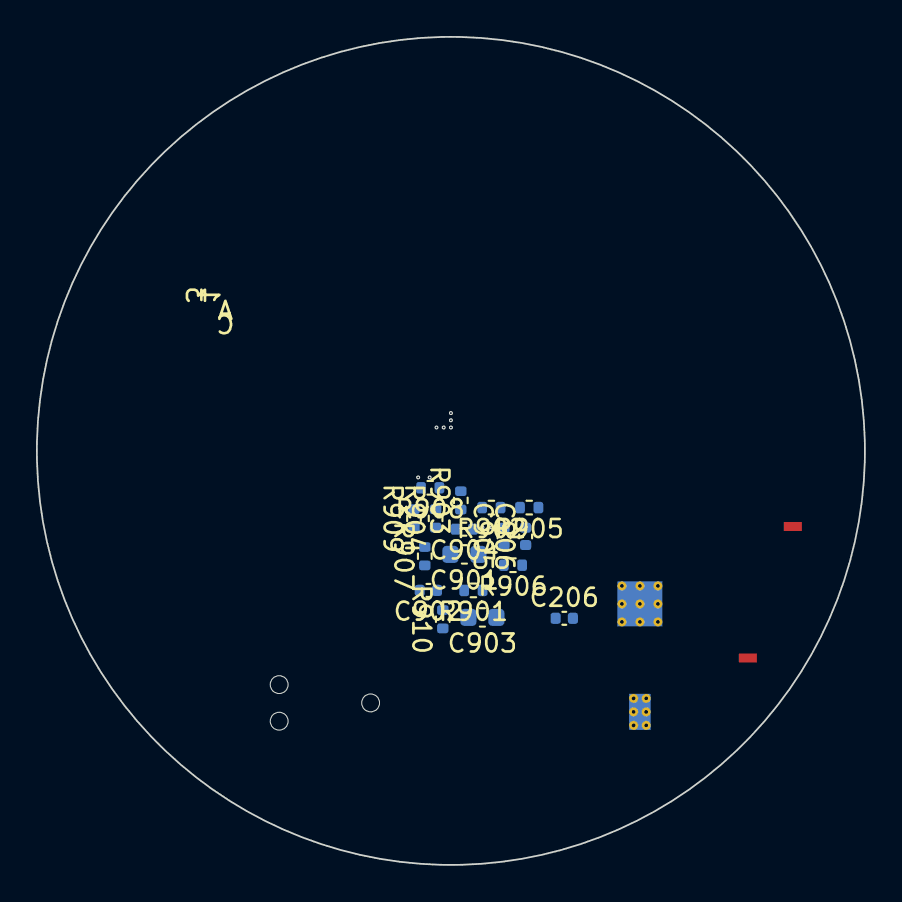
[picture p25: board sportwatch_revA.kicad_pcb from below]

Board: 8 copper layers, 46.0 x 46.0 mm, 184 parts (17 on the bottom side), 145 nets.
