slimmpylk/Skoll_Ultra/rear_sensor/rear_sensor_revA.kicad_pcb

## KiCad design rear_sensor/rear_sensor_revA.kicad_pcb (2026-10-22)

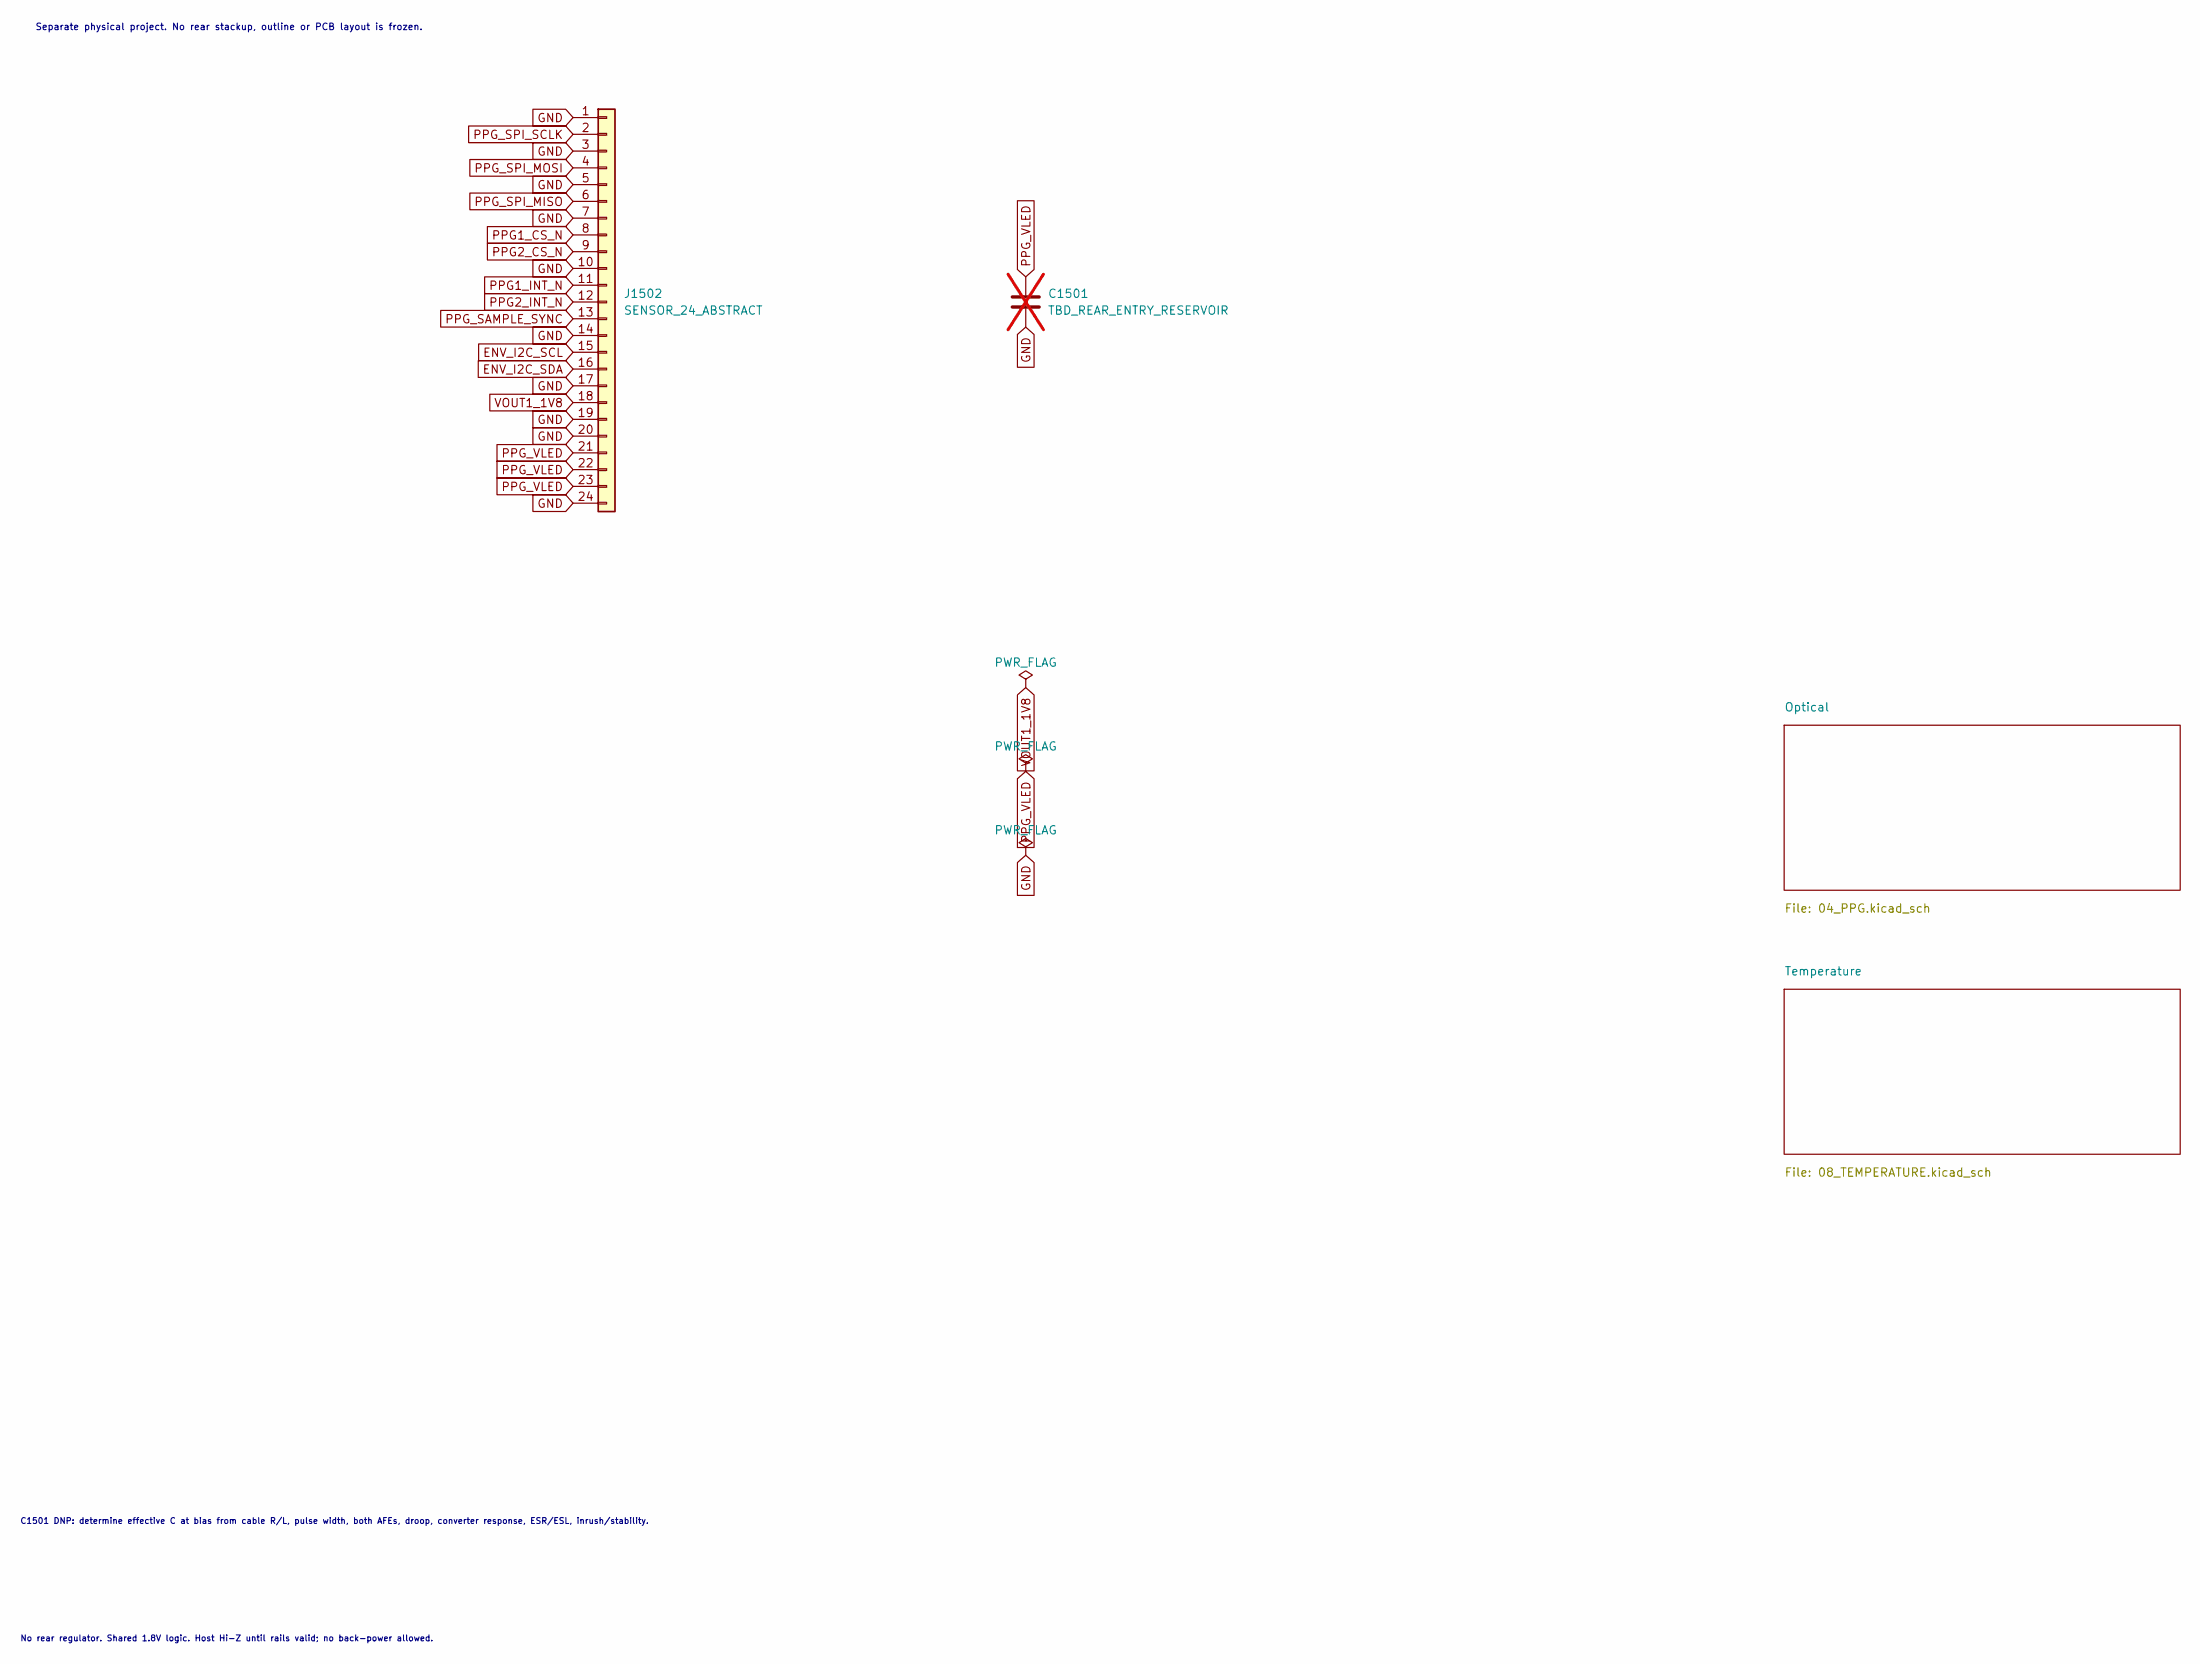
[picture p26: schematic rear_sensor_revA.kicad_sch, REAR SENSOR - external MAIN supplies / 24-position interface]

Parts:
C1501: TBD_REAR_ENTRY_RESERVOIR; not fitted
J1502: SENSOR_24_ABSTRACT

Connections:
unnamed: C1501.1, J1502.21, J1502.22, J1502.23
unnamed: C1501.2, J1502.1, J1502.3, J1502.5, J1502.7, J1502.10, J1502.14, J1502.17, J1502.19, J1502.20, J1502.24

Notes on the sheet:
Separate physical project. No rear stackup, outline or PCB layout is frozen.
C1501 DNP: determine effective C at bias from cable R/L, pulse width, both AFEs, droop, converter response, ESR/ESL, inrush/stability.
No rear regulator. Shared 1.8V logic. Host Hi-Z until rails valid; no back-power allowed.

Schematic: 04_PPG.kicad_sch, REAR - dual MAX86141 / optical / mux / local guards

Parts:
C403, C404, C405, C406, C407, C408, C4102, C4202: 100nF; C_0402_1005Metric
C4101, C4201: 22uF; C_0402_1005Metric
C4103, C4203: 1.0uF; C_0402_1005Metric
C4104, C4204: 10uF; C_0402_1005Metric
D401, D402, D403, D404: SFH7018A Q65113A6157; OSRAM_SFH7018A_2.4x2.4mm
D405, D406, D407: SFH4053B Q65115A1586; OSRAM_SFH4053B_1.0x0.5mm
D413, D414, D423, D424: SFH2703H Q65115A2199; OSRAM_SFH2703_3.2x2.0mm
NT401: PPG1_PD_GND_TIE; NetTie-2_SMD_Pad0.5mm
NT402: PPG2_PD_GND_TIE; NetTie-2_SMD_Pad0.5mm
R401, R402, R405: 100k; R_0402_1005Metric
R403, R404: 47k; R_0402_1005Metric
R408, R409: 10k; R_0402_1005Metric
U12, U13: MAX86141ENP+T; 21-100134_N201A2-1_MXM
U402, U403, U404, U405, U406, U407: TS5A12301E; Texas_DSBGA-6_0.76x1.16mm_Layout2x3_P0.4mm

Connections:
/Optical/PPG1_LED1_GREEN_K: D401.1 (K_GREEN_1), D401.7 (K_GREEN_2), D401.8 (K_GREEN_3), U402.A1 (NO)
/Optical/PPG1_LED2_RED_K: D401.5 (K_RED), U403.A1 (NO)
/Optical/PPG1_LED3_IR850_K: D405.2 (CATHODE), U404.A1 (NO)
/Optical/PPG1_LED4_GREEN_K: D403.1 (K_GREEN_1), D403.7 (K_GREEN_2), D403.8 (K_GREEN_3), U402.C1 (NC)
/Optical/PPG1_LED5_RED_K: D403.5 (K_RED), U403.C1 (NC)
/Optical/PPG1_LED6_IR850_K: D406.2 (CATHODE), U404.C1 (NC)
/Optical/PPG1_LED_GREEN_DRV: U12.D1 (LED1_DRV), U402.B2 (COM)
/Optical/PPG1_LED_IR_DRV: U12.B1 (LED3_DRV), U404.B2 (COM)
/Optical/PPG1_LED_MUX_SEL: R408.2, U12.B4 (GPIO2), U402.A2 (IN), U403.A2 (IN), U404.A2 (IN)
/Optical/PPG1_LED_RED_DRV: U12.C1 (LED2_DRV), U403.B2 (COM)
/Optical/PPG1_PD1_IN: D424.1 (CATHODE), U12.D5 (PD1_IN)
/Optical/PPG1_PD2_IN: D414.1 (CATHODE), U12.D4 (PD2_IN)
/Optical/PPG1_PD_GND: D414.2 (ANODE), D424.2 (ANODE), NT401.1 (A), U12.C5 (PD_GND)
/Optical/PPG1_VREF: C4103.1, U12.B5 (VREF)
/Optical/PPG2_LED1_GREEN_K: D402.1 (K_GREEN_1), D402.7 (K_GREEN_2), D402.8 (K_GREEN_3), U405.A1 (NO)
/Optical/PPG2_LED2_RED_K: D402.5 (K_RED), U406.A1 (NO)
/Optical/PPG2_LED3_IR850_K: D407.2 (CATHODE), U407.A1 (NO)
/Optical/PPG2_LED4_GREEN_K: D404.1 (K_GREEN_1), D404.7 (K_GREEN_2), D404.8 (K_GREEN_3), U405.C1 (NC)
/Optical/PPG2_LED5_RED_K: D404.5 (K_RED), U406.C1 (NC)
/Optical/PPG2_LED6_IR940_K: D402.3 (K_IR), U407.C1 (NC)
/Optical/PPG2_LED_GREEN_DRV: U13.D1 (LED1_DRV), U405.B2 (COM)
/Optical/PPG2_LED_IR_DRV: U13.B1 (LED3_DRV), U407.B2 (COM)
/Optical/PPG2_LED_MUX_SEL: R409.2, U13.B4 (GPIO2), U405.A2 (IN), U406.A2 (IN), U407.A2 (IN)
/Optical/PPG2_LED_RED_DRV: U13.C1 (LED2_DRV), U406.B2 (COM)
/Optical/PPG2_PD1_IN: D423.1 (CATHODE), U13.D5 (PD1_IN)
/Optical/PPG2_PD2_IN: D413.1 (CATHODE), U13.D4 (PD2_IN)
/Optical/PPG2_PD_GND: D413.2 (ANODE), D423.2 (ANODE), NT402.1 (A), U13.C5 (PD_GND)
/Optical/PPG2_VREF: C4203.1, U13.B5 (VREF)
GND: C403.2, C404.2, C405.2, C406.2, C407.2, C408.2, C4101.2, C4102.2, C4103.2, C4104.2, C4201.2, C4202.2, C4203.2, C4204.2, NT401.2 (B), NT402.2 (B), U12.C3 (GND_DIG), U12.C4 (GND_ANA), U12.D3 (PGND), U13.C3 (GND_DIG), U13.C4 (GND_ANA), U13.D3 (PGND), U402.B1 (GND), U403.B1 (GND), U404.B1 (GND), U405.B1 (GND), U406.B1 (GND), U407.B1 (GND); also elsewhere on the board
PPG1_CS_N: R401.2, U12.A5 (CSB)
PPG1_INT_N: R403.2, U12.B2 (*INT)
PPG2_CS_N: R402.2, U13.A5 (CSB)
PPG2_INT_N: R404.2, U13.B2 (*INT)
PPG_SAMPLE_SYNC: R405.2, U12.B3 (GPIO1), U13.B3 (GPIO1)
PPG_SPI_MISO: U12.A3 (SDO), U13.A3 (SDO)
PPG_SPI_MOSI: U12.A4 (SDI), U13.A4 (SDI)
PPG_SPI_SCLK: U12.A2 (SCLK), U13.A2 (SCLK)
PPG_VLED: C403.1, C404.1, C405.1, C406.1, C407.1, C408.1, C4104.1, C4204.1, D401.2 (A_RED_IR_1), D401.4 (A_RED_IR_2), D401.6 (A_GREEN), D402.2 (A_RED_IR_1), D402.4 (A_RED_IR_2), D402.6 (A_GREEN), D403.2 (A_RED_IR_1), D403.4 (A_RED_IR_2), D403.6 (A_GREEN), D404.2 (A_RED_IR_1), D404.4 (A_RED_IR_2), D404.6 (A_GREEN), D405.1 (ANODE), D406.1 (ANODE), D407.1 (ANODE), U12.A1 (VLED), U13.A1 (VLED), U402.C2 (VCC), U403.C2 (VCC), U404.C2 (VCC), U405.C2 (VCC), U406.C2 (VCC), U407.C2 (VCC)
VOUT1_1V8: C4101.1, C4102.1, C4201.1, C4202.1, R401.1, R402.1, R403.1, R404.1, R405.1, R408.1, R409.1, U12.C2 (VDD_DIG), U12.D2 (VDD_ANA), U13.C2 (VDD_DIG), U13.D2 (VDD_ANA); also elsewhere on the board

Notes on the sheet:
Board ownership and interfaces: design/interfaces/main_rear_interface.md
One current path per AFE per exposure. Red <=31mA; green/IR <=62mA initial firmware limits.
PD_GND -> NT401/NT402 -> local system GND. Rebuild physical guards on future REAR layout.
