slimmpylk/Skoll_Ultra/rear_sensor/rear_sensor_revA.kicad_pcb

## KiCad design rear_sensor/rear_sensor_revA.kicad_pcb (continued)

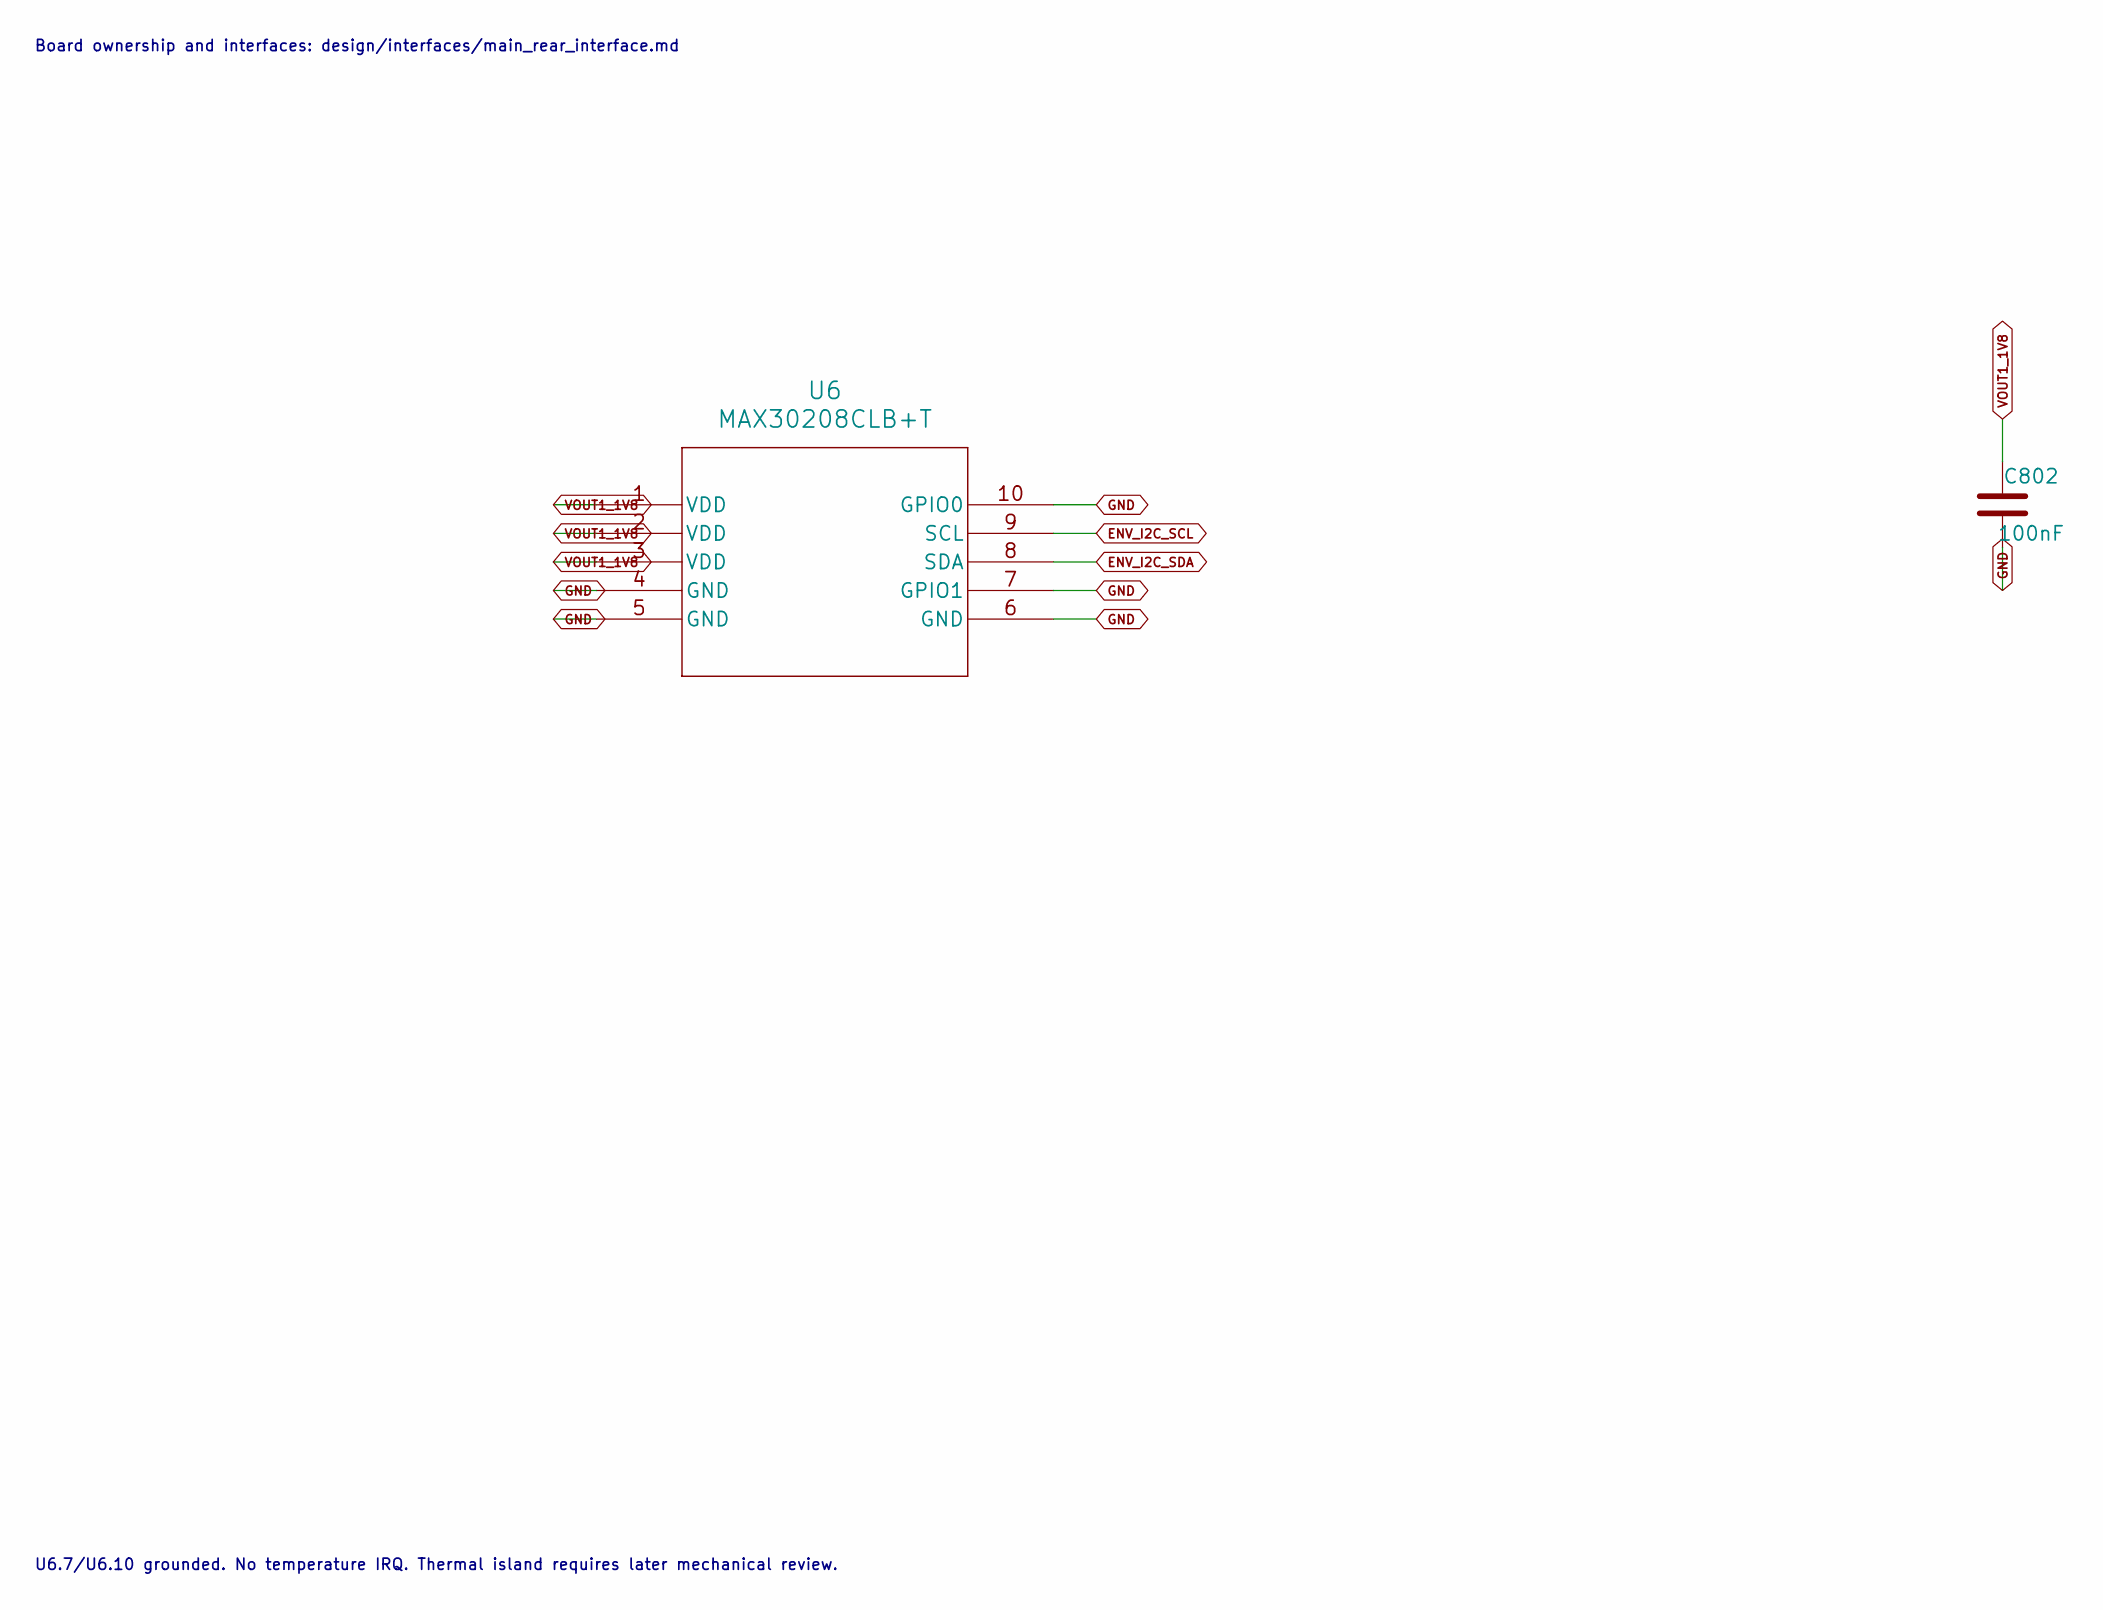
[picture p27: schematic 08_TEMPERATURE.kicad_sch, REAR - MAX30208 ten-pin Thin LGA / polled temperature]

Parts:
C802: 100nF; C_0402_1005Metric
U6: MAX30208CLB+T; 21-100265_MXM

Connections:
ENV_I2C_SCL: U6.9 (SCL)
ENV_I2C_SDA: U6.8 (SDA)
GND: C802.2, U6.4 (GND), U6.5 (GND), U6.6 (GND), U6.7 (GPIO1), U6.10 (GPIO0); also elsewhere on the board
VOUT1_1V8: C802.1, U6.1 (VDD), U6.2 (VDD), U6.3 (VDD); also elsewhere on the board

Notes on the sheet:
Board ownership and interfaces: design/interfaces/main_rear_interface.md
U6.7/U6.10 grounded. No temperature IRQ. Thermal island requires later mechanical review.

Board: 2 copper layers, 44 parts (0 on the bottom side), 39 nets, no tracks yet.
